trm79/Motorcycle-Engine-Design/README.md

# Motorcyle Engine Design

Used MATLAB to anaylyze efficiencies, loads, combustion, etc. After analysis, used SolidWorks to design fully functioning IC motorcycle engine.
