trm79/Motorcycle-Engine-Design/Lubrication/Lubricaiton Appendices References for Final Report.docx

References:

Chapter 13 (Heywood) (11 of Pulkrabeck)

Chapter 12 of Shigley

Lifter/pushrod lubrication:

https://www.thecarguys.net/valve_system_operation.pdf

Standards:

https://www.oilspecifications.org/jaso.php

https://www.cycleworld.com/2014/07/04/ask-kevin-should-i-use-motorcycle-synthetic-oil-or-petroleum

http://www.oil-tech.com/amsoil-pdf-files/motorcycle-oil-comparison.pdf

https://www.yourmechanic.com/article/how-the-engine-lubrication-system-works

http://edge.rit.edu/edge/P14453/public/Research/2-_LEADER_-_Understanding_Journal_Bearings.pdf

http://www.lube-media.com/wp-content/uploads/2017/11/Lube-Tech011-DesigningautomotiveenginelubricatingsystemsNewsurfacecoatingprocessdevelopedtor.pdf

Bearing Design:

Chapter 13 of juvinall
