trm79/Motorcycle-Engine-Design/Lubrication/Process - Lubrication.docx

Process 1:

1. Determine required flow rate for system
  a. Pick bearings based on L/D ratio and crankshaft dimensions
    i. Calculate total leakage rate
  b. Calculate flow rate needed through intake/exhaust manifolds
    i. Splash lubrication from bearings on camshaft, same calculations as for crankshaft and connecting rod bearings
2. Pick pump
  a. This finalizes system flow rate
  b. And pressure
    i. Need to find major, minor losses
    ii. Use flow rate to find velocity
3. Calculate diameter of oil channels through block and crankshaft (also intake/exhaust manifolds)
  a. Using flow rate
  b. Crankshaft channels
    i. Outer channels can be slightly longer with slightly lower pressures because they will have lower flow rates because they only support half the load of the central bearing
4. Implement channels into part design files

Process 2:

1. Design oil pan based on engine block design and required volume of oil (~4 litres)
  a. Must allow for safety factor for tilt, ac/deceleration (eliminate crankshaft dipping)
  b. Include drain plug
  c. Include considerations to ensure intake tube is always submerged
2. Design rest of components
  a. Dipstick
  b. Dipstick tube
  c. Oil manifold
  d. Oil pump mount
3. Spec rest of system components
  a. Intake tube
    i. Tube adapter (male)
  b. Drilling relief valve (after pump, before drilling entrance
  c. Bypass relief valve (before full flow filter)
  d. Piston relief valve (before piston cooling jet)
  e. Full flow filter
  f. Bypass filter
  g. Oil manifold mounting bolts

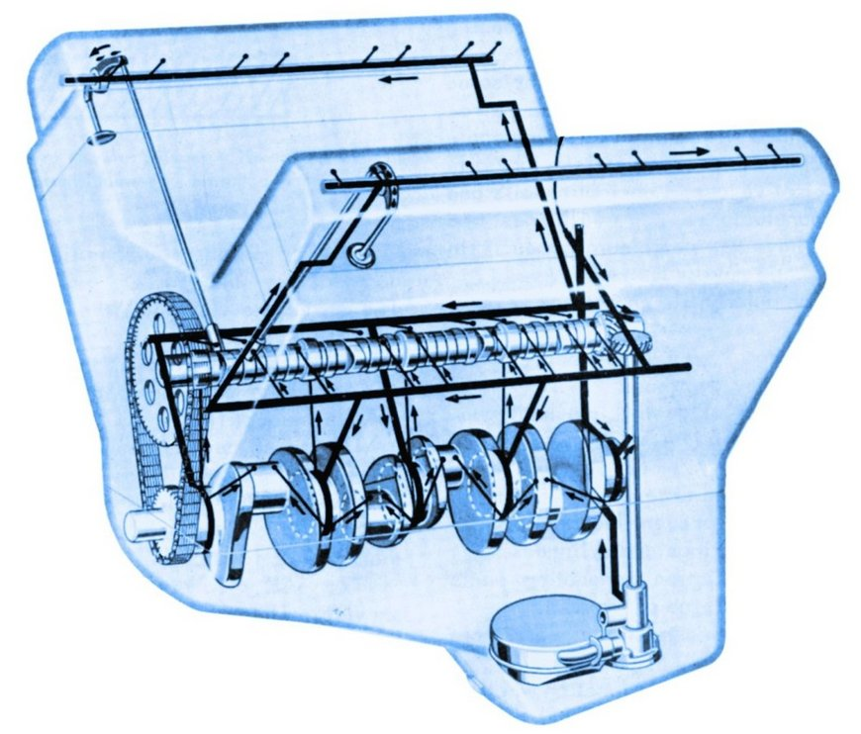
[picture p4: figure]

Lifter/pushrod lubrication:

https://www.thecarguys.net/valve_system_operation.pdf

Bearing material:

AST800 Bimetal Wrapped Steel With Bronze,

Good for lubricated applications, high load capacity, excellent heat dissipation, and good fatigue properties. They have been widely used in automotive industry
