trm79/Motorcycle-Engine-Design/Lubrication/crankshaft oil channels1.PNG

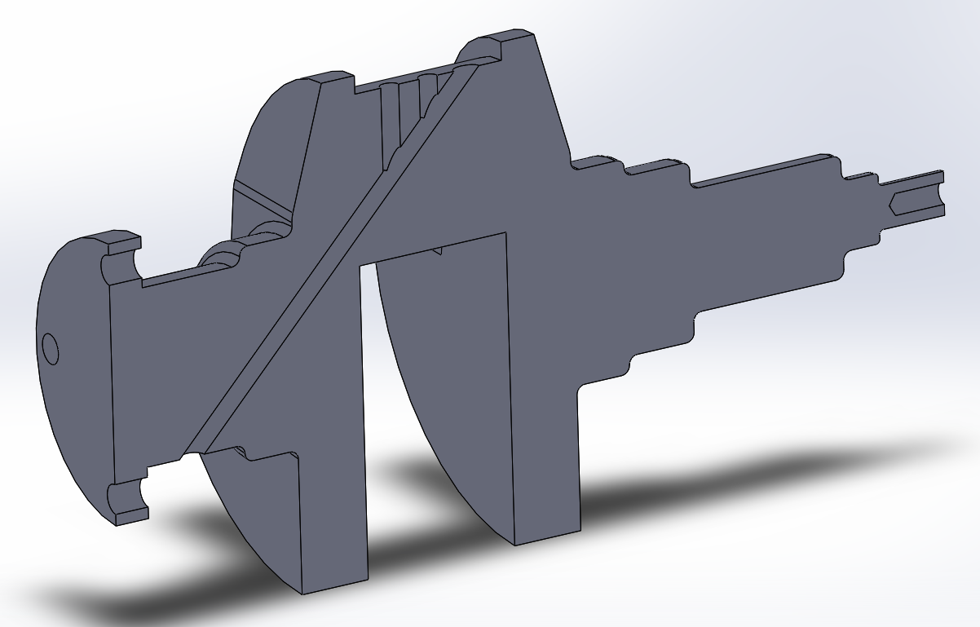
Lubrication/crankshaft oil channels1.PNG
