trm79/Motorcycle-Engine-Design/Lubrication/crankshaft oil channels2.PNG

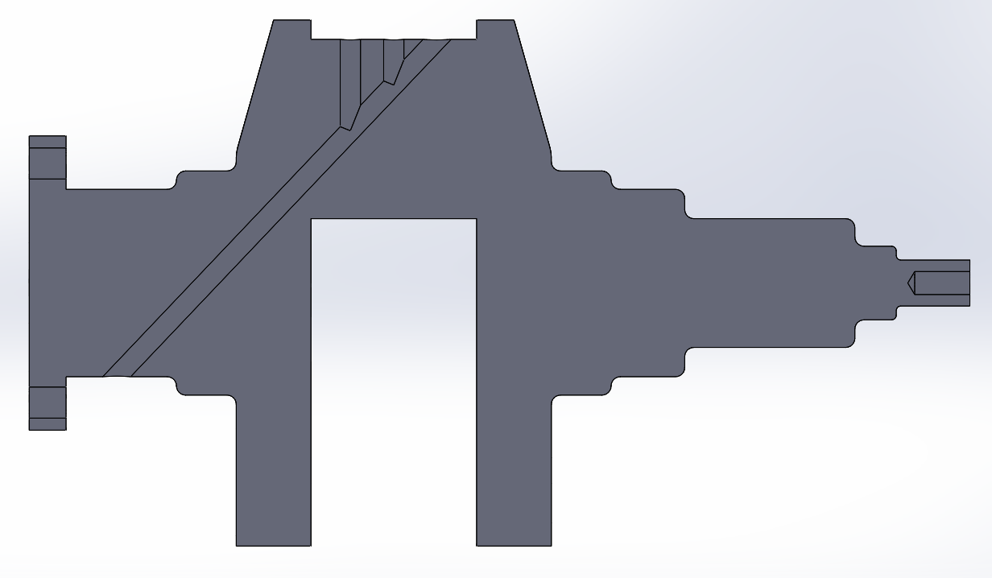
Lubrication/crankshaft oil channels2.PNG
