trm79/Motorcycle-Engine-Design/Lubrication/final flow chart.PNG

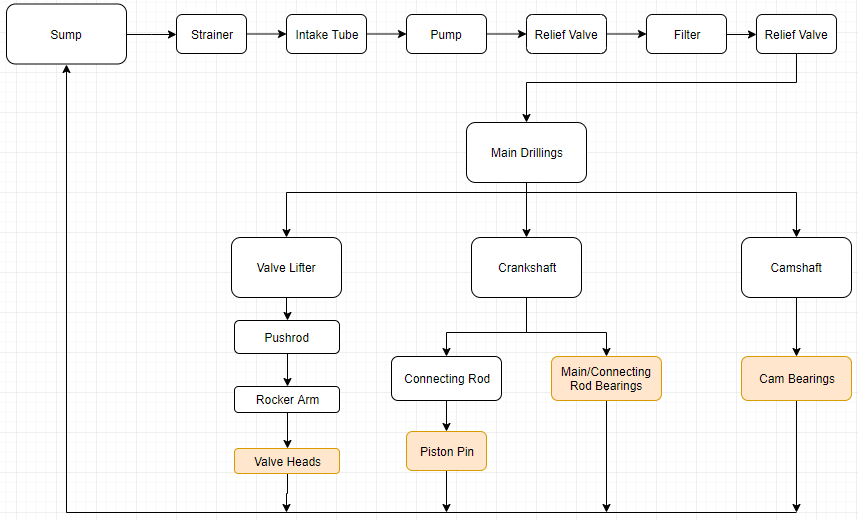
Lubrication/final flow chart.PNG
