trm79/Motorcycle-Engine-Design/Lubrication/Oil Flow Chart.PNG

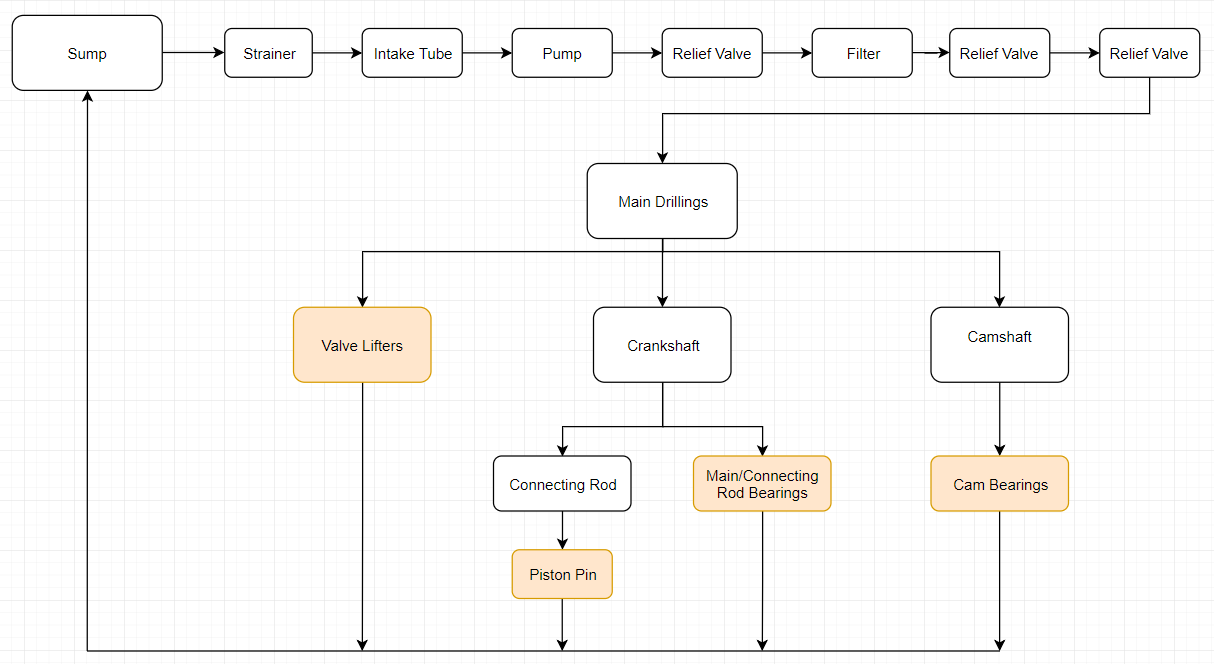
Lubrication/Oil Flow Chart.PNG
