trm79/Motorcycle-Engine-Design/Other Work/cooling flowchart.png

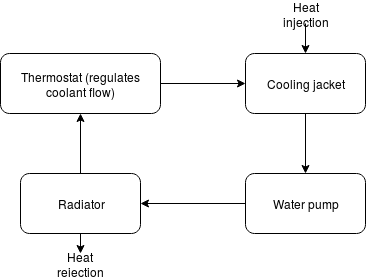
Other Work/cooling flowchart.png
