trm79/Motorcycle-Engine-Design/Other Work/Powertrain ISO.gif

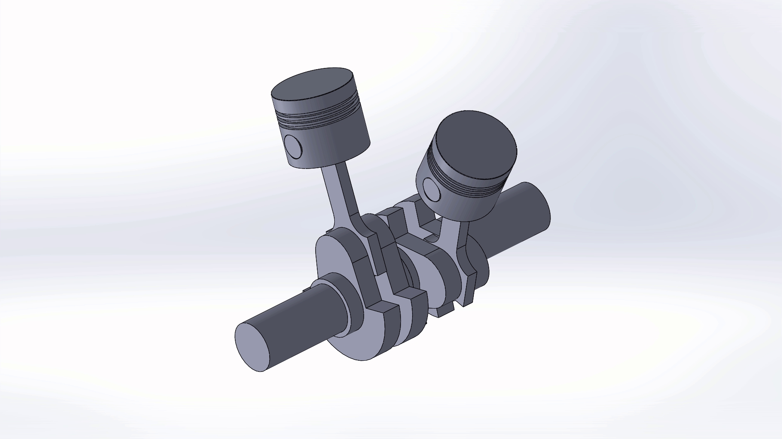
Other Work/Powertrain ISO.gif
