trm79/Motorcycle-Engine-Design/Lubrication/Purchased Parts Specifications.docx

Pump:

Specifications:

Required flow rate: 4.36L/min

Required Pressure: 520kPa

Manufacturer: RB Racing

Cost: $495

Quantity: 1

https://www.rbracing-rsr.com/oilsystems.htm

Filters:

Specifications:

Full flow filtration:

Manufacturer:

Cost:

Quantity: 1

Specifications:

Fine filtration:

Manufacturer:

Cost:

Quantity: 1

Relief Valves:

Specifications:

Main channel relief valve

Manufacturer:

Cost:

Quantity: 1

Specifications:

Filter relief valve:

Manufacturer:

Cost:

Quantity: 1

Strainer:

Specifications:

Manufacturer:

Cost:

Quantity: 1

Tubing:

Specifications:

Manufacturer:

Cost:

Quantity:

Temperature Sensor:

Specifications:

Manufacturer:

Cost:

Quantity: 1

Pump Mounting Bolts:

Specifications:

Manufacturer: RB Racing

Cost: $7.95 (set of 4)

Quantity: 4

Main Crankshaft Bearing:

Specifications:

Manufacturer:

Cost:

Quantity:

Crankpin Bearing:

Specifications:

Manufacturer:

Cost:

Quantity:

Camshaft Bearing:

Specifications:

Manufacturer:

Cost:

Quantity:
