trm79/Motorcycle-Engine-Design/Final Report/Bill of Materials .xlsx

Sheet: Injection
 | Part Name | Part Number | Local Part Number | Description | Material | Manufacturing Method | Retailer (if bought) |  | Quantity | Unit Cost ($) | Unit Weight (lb) | Total Cost | Total Weight (lb) | Comments
Manufactured Components
Purchased Components | Fuel injector* | F 02U V00 868-01 | DH-I-I001 | HDEV5.2 High pressure injector. Flow rate at 100 bar: up to 1,640 g/min (n-heptane) for port injection |  | Purchased | Bosch | http://www.bosch-motorsport.com/media/catalog_resources/HP_Injection_Valve_HDEV_52_Datasheet_51_en_2776067211pdf.pdf | 2 | 65 | 0.149914 | 130 | 0.299828 | Unit weight is without wire
 | Spark plug | 9613 | DH-I-I002 | Bosch Double Iridium Spark Plug |  | Purchased | Bosch | https://www.amazon.com/Bosch-9613-Double-Iridium-Longer/dp/B00515NJB6 | 2 | 7.23 | 0.11 | 14.46 | 0.22 | Bhavya found this
 | Throttle Position Sensor | C701260454BOS | DH-I-I004 | Throttle Position Sensor |  | Purchased | Bosch | https://shop.advanceautoparts.com/p/bosch-bosch-throttle-position-sensor-c701260454bos/10809310-P | 1 | 67 | 0.8 | 67 | 0.8 |  | Throttle valve position, crankshaft position, engine & coolant temp
 | Starter Motor |  | DH-I-I005 | All Balls Starter Motor |  | Purchased | All Balls | https://www.amazon.com/All-Balls-Starter-Motor-Harley/dp/B000GZR4CG | 1 | 287.5 | 8.8 | 287.5 | 8.8
Fasteners, Bearings, etc. | Fuel injector o-rings (2 each) | 1222595 |  | 13/16" Inside x 1" Outside Diam | Nitrile | Purchased | Buna-N | https://www.mscdirect.com/browse/tnpla/01222595?pcrid=164124449498&rd=k&product_id=01222595 | 16 | 3.4 | 0.05 | 54.4 | 0.8

Sheet: Lubrication and Cooling
/ | Part Name | Part Number | Local Part Number | Description | Material | Manufacturing Method | Retailer (if bought) | Quantity | Unit Cost | Unit Weight | Total Cost | Total Weight
Manufactured Components | Oil Pan |  |  | Part of the crankcase, not actually a separate part |  |  | NA | NA | NA | NA | NA | NA
 | Dipstick Tube |  |  | Also part of the crankcase, not a truly original part |  |  | NA | NA | NA | NA | NA | NA
Purchased Components | Oil Pump | 03-1054 | DH-LC-P001 | Oil Prelube / Scavenge Pump SuperX, 1/2" NPT x 1/2" BSPP Male exit/entry, 3.200" x 7.500", 4.0 GPM (15A Fuse) |  | NA | RB Racing | 1 | 395 | 9.46 | 395 | 9.46
 | Pressure Relief Valve (Main Channel) | A60871094826OES | DH-LC-P002 | Regulates pressure at main drilling inlet |  | NA | Advance Auto Parts | 1 | 8.37 | 0.25 | 8.37 | 0.25
 | Pressure Relief Valve (Filters) | A60871094826OES | DH-LC-P003 | Regulates pressure at filter inlet |  | NA | Advance Auto Parts | 1 | 8.37 | 0.25 | 8.37 | 0.25
 | Oil Temperature Sensor | 17 11 1 437 362 | DH-LC-P008 | AT Cooler Thermostat |  | NA | URO Parts | 1 | 35.63 | 0.2 | 35.63 | 0.2
 | Coolant Pump |  | DH-LC-P009 |  |  | NA |  | 1 |  |  | 0 | 0
 | Oil Strainer | 12-1542 | DH-LC-P010 | Includes: strainer, gasket, and pin |  | NA | V-Twin Manufacturing | 1 | 15.95 | 0.05 | 15.95 | 0.05
 | Check Valve (pump outlet) | 03-1036 | DH-LC-P011 | 03-1036 Check valve, 1/2" NPT 1psi backflow |  | NA | RB Racing | 1 | 40.5 | 0.1 | 40.5 | 0.1
 | Hose Barb Fitting | 03-1043 | DH-LC-P012 | 03-1043 1/2" Hose Barb Fitting |  | NA | RB Racing | 2 | 15 | 0.01 | 30 | 0.02
 | Drain plug sealing O-ring | -13 | DH-LC-P014 | Seals oil into crankcase |  | NA | Apple Rubber | 1 | 0.2 | 0.01 | 0.2 | 0.01
 | Drain Plug | BMS008Y | DH-LC-P015 | Screws into lowest point on oil pan to be removed for oil change |  | NA | Motosport | 1 | 6.95 | 0.08 | 6.95 | 0.08
 | Dipstick | 40-0470 | DH-LC-P016 | Measures level of oil, screws into dipstick tube |  | NA | V-Twin Manufacturing | 1 | 2.12 | 0.2 | 2.12 | 0.2
 | Thermostat | 7200-195 | DH-LC-P017 | Regulates coolant flow based on temperature |  | NA | Fail-Safe | 2 | 14.99 | 0.13 | 29.98 | 0.26
Fasteners, Bearings, etc. | Oil Manifold Mounting Bolts | 03-1045 | DH-LC-P017 | 03-1045 Mounting Bolts (pack of 4) |  | NA | RB Racing | 1 | 7.95 | 0.16 | 7.95 | 0.16
 | Main Crankshaft Bearing (top) | NA | DH-LC-P018 | Simple Hydrodynamic Bearing | AST800 Wrapped Steel w/ Bronze | NA | Mechanical Power | 2 | 19.275 | 0.24 | 38.55 | 0.48
 | Main Crankshaft Bearing (bottom) | NA | DH-LC-P019 | Simple Hydrodynamic Bearing | AST800 Wrapped Steel w/ Bronze | NA | Mechanical Power | 2 | 19.275 | 0.23 | 38.55 | 0.46
 | Connecting Rod Bearing (bottom) | NA | DH-LC-P020 | Simple Hydrodynamic Bearing | AST800 Wrapped Steel w/ Bronze | NA | Mechanical Power | 3 | 14.475 | 0.14 | 43.425 | 0.42
 | Connecting Rod Bearing (top) | NA | DH-LC-P021 | Simple Hydrodynamic Bearing | AST800 Wrapped Steel w/ Bronze | NA | Mechanical Power | 3 | 14.475 | 0.13 | 43.425 | 0.39
 | Camshaft Bearing (top) | NA | DH-LC-P022 | Simple Hydrodynamic Bearing | AST800 Wrapped Steel w/ Bronze | NA | Mechanical Power | 4 | 17.625 | 0.03 | 70.5 | 0.12
 | Camshaft Bearing (bottom) | NA | DH-LC-P023 | Simple Hydrodynamic Bearing | AST800 Wrapped Steel w/ Bronze | NA | Mechanical Power | 4 | 17.625 | 0.03 | 70.5 | 0.12
 | Auxiliary Crankshaft Bearing (top) | NA | DH-LC-P024 | Simple Hydrodynamic Bearing | AST800 Wrapped Steel w/ Bronze | NA | Mechanical Power | 1 | 11.125 | 0.02 | 11.125 | 0.02
 | Auxiliary Crankshaft Bearing (bottom) | NA | DH-LC-P025 | Simple Hydrodynamic Bearing | AST800 Wrapped Steel w/ Bronze | NA | Mechanical Power | 1 | 11.125 | 0.02 | 11.125 | 0.02
 | Piston Pin Bearing | NB-1457 | DH-LC-P026 | Needle Bearing, #: NB-1457 |  | NA | Parts Unlimited | 2 | 7.95 | 0.02 | 15.9 | 0.04
 | Piston Pin Bearing (ring) | NA | DH-LC-P027 | Needle bearing ring |  | NA | Parts Unlimited | 2 | 0 | 0 | 0 | 0
 | Piston Pin Bearing (needle) | NA | DH-LC-P028 | Needle bearing needle |  | NA | Parts Unlimited | 36 | 0 | 0 | 0 | 0
 | 90 degree pump adapter | 03-1049 | DH-LC-P029 | 90 fitting for inlet/outlet of pump |  | NA | RB Racing | 2 | 27.5 | 0.1 | 55 | 0.2
 | Dipstick O-ring | AS568-56 | DH-LC-P030 | O-ring to seal dipstick |  | NA | Apple Rubber | 1 | 0.2 | 0.01 | 0.2 | 0.01
 |  |  |  |  |  |  |  |  |  |  | 979.32 | 13.32

Sheet: Powertrain
 | Part Name | Part Number | Local Part Number | Description | Material | Manufacturing Method | Retailer (if bought) | Quantity | Unit Cost | Unit Weight | Total Cost | Total Weight
Manufactured Components | Piston |  | DH-PT-M001 | Piston | Aluminum 4032 | Forged | -- | 2
 | Wrist Pin |  | DH-PT-M002 | Secures connecting rod to piston | 4340 Steel | Forged | -- | 2 |  | 1.4 |  | 2.8
 | Blade Connecting Rod |  | DH-PT-M003 | Connects piston to crankshaft | AISI 1340 | Forged, Cold Finished | -- | 1 |  | 2.62 |  | 2.62
 | Connecting Rod Cap, Fork |  | DH-PT-M004 | Bottom portion of connecting rod | AISI 1340 | Forged, Cold Finished | -- | 2 |  |  |  | 0
 | Fork Connecting Rod |  | DH-PT-M009 | Connects piston to connecting rod | AISI 1340 | Forged, Cold Finished | -- | 1 |  | 4.55 |  | 4.55
 | Crankshaft |  | DH-PT-M008 | Provides output to transmission | 4340 Steel | Forged and Machined | -- | 1 |  | 29.75 |  | 29.75
 | Wrist Pin Circlip |  | DH -PT-M010 | Secures wrist clip onto piston | 4340 Steel | Extruded and bent? | -- | 4 |  | 0.002 |  | 0.008
 | Piston Compression Ring |  | DH-PT-M011 | Spreads lubrication along cylinder | Nitride Steel | Buy |  | 2
 | Connecting Rod Cap, Blade |  | DH-PT-M012 | Bottom portion of connecting rod | AISI 1340 | Forged, Cold Finished | -- | 1
Purchased Components | Piston Rings |  | DH-PT-P002 |  |  |  |  | 6
 | Wrist Pin Retainers | LR64 | DH-PT-P002 | Speed-Pro Piston Pin Lock Ring | Steel |  | Speed Pro | 4 | 1.99 | 0.007 | 7.96 | 0.028
Fasteners |  |  |  | Connecting Rod Cap Screws
 |  |  |  | Crankshaft Sprocket Retaining Bolt

Sheet: Valvetrain
 | Part Name | Part Number | Local Part Number | Description | Material | Manufacturing Method | Retailer (if bought) | Quantity | Unit Cost | Unit Weight (lb) | Total Cost | Total Weight (lb)
Manufactured Components | Camshaft Square End | -- | DH-VT-M001 | Camshaft for sprocket mounting | Gray Cast Iron Class 40 A48 |  | -- | 1
 | Camshaft Regular End | -- | DH-VT-M002 | Camshaft with retaining ring groove | Gray Cast Iron Class 40 A48 |  | -- | 1
 | Push Rod | -- | DH-VT-M007 | Connects cams to rocker arms | Steel Alloy 4140 | Machining | -- | 4 |  |  |  | 0
 | Rocker Holder Bottom | -- | DH-VT-M008 | Secures rocker arm shafts |  |  | -- | 4 |  |  |  | 0
 | Rocker Holder Top | -- | DH-VT-M009 | Secures rocker arm shafts |  |  | -- | 4
 | Exhaust Rocker Arm | -- | DH-VT-M0010 | Connects push rods to valve stems | Steel Alloy 4140 | Forging | -- | 2 |  |  |  | 0
 | Intake Rocker Arm | -- | DH-VT-M0011 | Connects push rods to valve stems | Steel Alloy 4140 | Forging | -- | 2 |  |  |  | 0
 | Rocker Arm Shaft | -- | DH-VT-M012 | Provides rotation surface for rocker arms | Steel Alloy 4140 |  | -- | 4
 | Intake Stem | -- | DH-VT-M013 | Stem of intake valve | Stainless Steel 201 |  |  | 4
 | Intake Valve | -- | DH-VT-M014 | Flange of intake valve | Stainless Steel 201 | Forging | -- | 4 |  |  |  | 0
 | Exhaust Stem | -- | DH-VT-M015 | Stem of exhaust valve | Stainless Steel 21-4N |  | -- | 4
 | Exhaust Valve | -- | DH-VT-M016 | Flange of exhaust valve | Stainless Steel 21-4N | Forging | -- | 4
Purchased Components | Crankshaft Timing Sprocket |  | DH-VT-P002 |  |  | -- |  | 1
 | Camshaft Timing Sprocket |  | DH-VT-P003 |  |  | -- |  | 1
 | Valve Lock | 13098-16 | DH-VT-M017/019 | Manley 7 Degree Machined Valve Locks | Alloy Steel | -- | Manley | 8 | 3 | 0.2 | 24 | 1.6
 | Valve Retainer | 660-23604-32 | DH-VT-M018 | Manley Street Master Steel Retainers 0.841" Spring O.D. | 4140 Chromoly steel | -- | Manley | 8 | 4 | 0.0154 | 32 | 0.1232
 | Valve Spring | LC 095J 04 S316 | DH-VT-P001 | Lee Spring Compression Spring | SS316 | -- | Lee Spring | 8 | 9.45 |  | 75.6
 | Oil seal |  |  |  |  | -- |  | 8
 | Camshaft Timing Chain |  |  |  |  | --
 | Hydraulic Lifter |  |  |  |  | --
Fasteners, Bearings, etc. | Camshaft Sprocket Retaining Bolt |  | -- | 1/2-13 0.75" flanged hex bolt |  |  |  | 1
 | Camshaft Retaining Ring |  | --
 | Crankshaft Sprocket Retaining Bolt |  |  | 3/8-16 0.75" flanged hex bolt |  | -- |  | 1

Sheet: IntakeExhaust
 | Part Name | Part Number | Local Part Number | Description | Material | Manufacturing Method | Retailer (if bought) | Link (if bought) | Quantity | Unit Cost | Unit Weight | Total Cost | Total Weight
Manufactured Components | Intake Manifold |  | DH-IE-M001 |  | Stainless Steel AISI 405 | Die Casting |  |  | 1
 | Exhaust Manifold 1 |  | DH-IE-M002 |  | Stainless Steel AISI 405 | Die Casting |  |  | 1
 | Exhaust Manifold 2 |  | DH-IE-M003 |  | Stainless Steel AISI 405 | Die Casting |  |  | 1
Purchased Components | Exhaust Gasket |  | DH-IE-P001 | AS-568-029 |  |  |  |  | 4
 | Intake Gasket |  | DH-IE-P002 | AS-568-029 |  |  |  |  | 4
 | Air Intake Filter
 | Catalytic Converter
 | Muffler
 | O2 Sensor | 15109 | DH-I-I003 | Bosch Exact Fit Oxygen Sensor |  | Purchased | Bosch | https://www.autozone.com/engine-management/oxygen-sensor/bosch-exact-fit-oxygen-sensor/491745_102074_0_98000 | 2 | 60 | 0.28 | 120 | 0.56 | Maybe look into more sensors?
Fasteners, Bearings, etc.

Sheet: Engine BlockHousing
 | Part Name | Part Number | Local Part Number | Description | Material | Manufacturing Method | Retailer | Quantity | Unit Cost | Unit Weight (lb) | Total Cost | Total Weight
Manufactured Components | Crankcase Front | -- | DH-EB-M002 | Houses crankshaft assembly | Aluminum Alloy 356-T6 | Sand Casting | -- | 1 |  | 15.96 |  | 15.96
 | Crankcase Rear | -- | DH-EB-M003 | Houses crankshaft assembly | Aluminum Alloy 356-T6 | Sand Casting | -- | 1 |  | 11.9 |  | 11.9
 | Cylinder | -- | DH-EB-M004 | Houses cylinder lining, cooling and lubrication channels | Aluminum Alloy 356-T6 | Sand Casting | -- | 2 |  | 11.4 |  | 22.8
 | Cylinder Lining | -- | DH-EB-M005 | Lining for smooth piston travel | Gray Cast Iron Class 40 A48 |  | -- | 2 |  |  |  | 0
 | Cylinder Stud | -- | DH-EB-M006 | Threaded rods for cylinder alignment and structure | Steel Alloy 4140 | Forging | -- | 8 |  | 0.4 |  | 3.2
 | Camshaft Retaining Plate | -- | DH-EB-M007 | Holds camshafts, camshaft bearings |  |  | -- | 1 |  |  |  | 0
 | Head Bolt | -- | DH-EB-M008 | Threads into cylinder studs to fixture cylinder, cylinder head |  |  | -- | 8 |  |  |  | 0
 | Cylinder Head | -- | DH-EB-M009 | Contains valves, spark plugs, and hooks to intake/exhaust | Aluminum Alloy 356-T6 | Sand Casting | -- | 2 |  |  |  | 0
 | Valve Stem Liner | -- | DH-EB-M010 | Ensures smooth translation of valves |  |  | -- | 8
 | Tappet Cover Left | -- | DH-EB-M011 | Covers hydraulic push rod lifter, houses pushrod gaskets |  |  | -- | 1
 | Rocker Box | -- | DH-EB-M012 | Houses rocker arms | Aluminum Alloy 356-T6 | Sand Casting | -- | 2
 | Tappet Cover Right | -- | DH-EB-M013 | Covers hydraulic push rod lifter, houses pushrod gaskets |  |  | --
 | Cylinder Cover | -- | DH-EB-M014 | Covers the rocker box |  |  | -- | 2
 | Front Crankcase Cover | -- | DH-EB-M015 | Covers the crankshaft and camshaft sprockets and chain |  |  | -- | 1
 | Push Rod Tube Bottom | -- | DH-EB-M016 | Protects the pushrod, slots into the tappet covers |  |  | -- | 4
 | Push Rod Tube Top | -- | DH-EB-M017 | Protects the pushrod, slots into the cylinder head |  |  | -- | 4
 | Push Rod Tube Spring Cover | -- | DH-EB-M018 | Protects the pushrod retaining spring |  |  | -- | 4
 | Head Gasket | -- | DH-EB-M019 | Seals gap between cylinder head and cylinder |  |  | -- | 2
 | Push Rod Covers | -- | DH-EB-M020 | Ensures tension in push rod spring for fixturing |  |  | -- | 8
 | Rocker Gasket | -- | DH-EB-M021 | Seals gap between rocker box and cylinder head |  |  | -- | 2
 | Cylinder Head Retaining Plug | -- | DH-EB-M023 | Prevents cylinder head slippage when unfastened |  |  | -- | 4
Purchased Components | Cylinder Gasket O-Ring | AS568-424 | DH-EB-P001 |  | Nitrile | -- | Marco Rubber and Plastics | 2 | $0.70 |  | $1.40
 | Push Rod Spring |  | DH-EB-P002 | Spring pressure fixtures push rods |  | -- |  | 4
 | Push Rod Spring Shims |  | DH-EB-P003 | Provides bottom spring support before spring gasket |  | -- |  | 4
 | Push Rod Spring Gasket O-Ring |  | DH-EB-P004 | Seals gap between top and bottom push rod covers | Nitrile | -- | Marco Rubber and Plastics | 4
 | Dual Piston Cam Chain Tensioner | 413-901 | DH-EB-P005,6 | Ensures tension in the crankshaft and camshaft chains | -- | -- | Red Shift | 1 | $159.95
 | Push Rod Gasket O-Ring | AS568-018 | DH-EB-P007 | Seals gap between bottom push rod cover and tappet cover | Nitrile | -- | Marco Rubber and Plastics | 8
Fasteners | 1/4-20 1" hex socket head cap screw |  | -- |  |  |  |  | 6
 | 1/4-20 0.75" hex bolt |  | -- |  |  |  |  | 8
 | 1/4-20 1.875" hex bolt |  | -- |  |  |  |  | 4
 | 1/4-20 1.75" hex bolt |  | -- |  |  |  |  | 4
 | 3/8-16 0.75" hex bolt |  | -- |  |  |  |  | 8
 | 3/8-16 0.625" hex bolt |  | -- |  |  |  |  | 8
 | 1/4-20 1.375" hex bolt |  | -- |  |  |  |  | 10
 | 3/8-16 5.5" hex bolt |  | -- |  |  |  |  | 5
 | 10-32 0.625" socket button head cap screw |  | -- |  |  |  |  | 6

Sheet: Materials
Material | Density (lb/in^3) | Yield Strength (ksi) | Elastic Modulus (ksi) | Ultimate Tensile Strength (ksi)
Stainless Steel AISI 201 | 0.28 | 80 | 28600 | 150
Stainless Steel 21-4N | 0.28 | 100 | 31000 | 180
Stainless Steel AISI 405 | 0.28 | 40 | 29000 | 65
Steel Alloy 4140 | 0.28 | 60 | 30000 | 95
Steel Alloy 4340 | 0.28 | 68.2 | 31000 | 108
Steel Alloy AISI 1340 | 0.28 | 62.9 | 30000 | 102
Aluminum Alloy 356-T6 | 0.0965 | 24 | 10500 | 34
Cast Iron ASTM Class 40 | 0.258 | 28 | 18000 | 40

Sheet: FINAL
Part Name | Part Number | Local Part Number | Description | Material | Manufacturing Method | Retailer | Quantity | Unit Cost | Unit Weight (lb) | Total Cost | Total Weight
Engine Block
Crankcase Front | -- | DH-EB-M002 | Houses crankshaft assembly | Aluminum Alloy 356-T6 | Sand Casting | -- | 1 | $60.00 | 15.61 | $60.00 | 15.610
Crankcase Rear | -- | DH-EB-M003 | Houses crankshaft assembly | Aluminum Alloy 356-T6 | Sand Casting | -- | 1 | $55.00 | 12.27 | $55.00 | 12.270
Cylinder | -- | DH-EB-M004 | Houses cylinder lining, cooling and lubrication channels | Aluminum Alloy 356-T6 | Sand Casting | -- | 2 | $53.00 | 11.3625 | $106.00 | 22.725
Cylinder Lining | -- | DH-EB-M005 | Lining for smooth piston travel | Gray Cast Iron Class 40 A48 | Sand Casting | -- | 2 | $9.00 | 4.6149 | $18.00 | 9.230
Cylinder Stud | -- | DH-EB-M006 | Threaded rods for cylinder alignment and structure | 316 Stainless Steel | Forging | -- | 8 | $5.00 | 0.3839 | $40.00 | 3.071
Camshaft Retaining Plate | -- | DH-EB-M007 | Holds camshafts, camshaft bearings | Aluminum Alloy 356-T6 | Sand Casting | -- | 1 | $10.00 | 0.9979 | $10.00 | 0.998
Head Bolt | -- | DH-EB-M008 | Threads into cylinder studs to fixture cylinder, cylinder head | 316 Stainless Steel | Forging | -- | 8 | $6.00 | 0.5649 | $48.00 | 4.519
Cylinder Head | -- | DH-EB-M009 | Contains valves, spark plugs, and hooks to intake/exhaust | Aluminum Alloy 356-T6 | Sand Casting | -- | 2 | $160.00 | 15.6253 | $320.00 | 31.251
Valve Stem Liner | -- | DH-EB-M010 | Ensures smooth translation of valves | Gray Cast Iron Class 40 A48 | Sand Casting | -- | 8 | $2.00 | 0.0383 | $16.00 | 0.306
Tappet Cover Left | -- | DH-EB-M011 | Covers hydraulic push rod lifter, houses pushrod gaskets | Aluminum Alloy 356-T6 | Sand Casting | -- | 1 | $3.00 | 0.1335 | $3.00 | 0.134
Rocker Box | -- | DH-EB-M012 | Houses rocker arms | Aluminum Alloy 356-T6 | Sand Casting | -- | 2 | $5.00 | 1.877 | $10.00 | 3.754
Tappet Cover Right | -- | DH-EB-M013 | Covers hydraulic push rod lifter, houses pushrod gaskets | Aluminum Alloy 356-T6 | Sand Casting | -- | 1 | $3.00 | 0.1335 | $3.00 | 0.134
Cylinder Cover | -- | DH-EB-M014 | Covers the rocker box | Aluminum Alloy 356-T6 | Sand Casting | -- | 2 | $10.00 | 3.6996 | $20.00 | 7.399
Front Crankcase Cover | -- | DH-EB-M015 | Covers the crankshaft and camshaft sprockets and chain | Aluminum Alloy 356-T6 | Sand Casting | -- | 1 | $11.00 | 9.2172 | $11.00 | 9.217
Push Rod Tube Bottom | -- | DH-EB-M016 | Protects the pushrod, slots into the tappet covers | Aluminum Alloy 356-T6 | Sand Casting | -- | 4 | $3.00 | 0.0807 | $12.00 | 0.323
Push Rod Tube Top | -- | DH-EB-M017 | Protects the pushrod, slots into the cylinder head | Aluminum Alloy 356-T6 | Sand Casting | -- | 4 | $2.00 | 0.0302 | $8.00 | 0.121
Push Rod Tube Spring Cover | -- | DH-EB-M018 | Protects the pushrod retaining spring | Aluminum Alloy 356-T6 | Sand Casting | -- | 4 | $2.00 | 0.0105 | $8.00 | 0.042
Head Gasket | -- | DH-EB-M019 | Seals gap between cylinder head and cylinder | Multi-Layer Steel | Machined | -- | 2 | $5.00 | 0.1632 | $10.00 | 0.326
Push Rod Covers | -- | DH-EB-M020 | Ensures tension in push rod spring for fixturing | Aluminum Alloy 356-T6 | Sand Casting | -- | 8 | $2.00 | 0.0167 | $16.00 | 0.134
Rocker Gasket | -- | DH-EB-M021 | Seals gap between rocker box and cylinder head | Multi-Layer Steel | Machined | -- | 2 | $5.00 | 0.4621 | $10.00 | 0.924
Cylinder Head Retaining Plug | -- | DH-EB-M023 | Prevents cylinder head slippage when unfastened | 316 Stainless Steel | Forging | -- | 4 | $3.00 | 0.0249 | $12.00 | 0.100
Cylinder Gasket O-Ring | AS568-424 | DH-EB-P001 | Seals gap between crank case and cylinder | Nitrile | -- | Marco Rubber and Plastics | 2 | $0.70 | 0.0048 | $1.40 | 0.010
Push Rod Spring | LP 049P 01 S316 | DH-EB-P002 | Spring pressure fixtures push rods | 316 stainless steel | -- | Lee Spring | 4 | $1.08 | 0.005 | $4.31 | 0.020
Push Rod Spring Shims | WSH.625.859.005SS | DH-EB-P003 | Provides bottom spring support before spring gasket | Stainless steel | -- | Apex Fasteners | 4 | $0.10 | 0.0004 | $0.40 | 0.002
Push Rod Spring Gasket O-Ring | AS568-011 | DH-EB-P004 | Seals gap between top and bottom push rod covers | Nitrile | -- | Marco Rubber and Plastics | 4 | $0.70 | 0.0003 | $2.80 | 0.001
Dual Piston Cam Chain Tensioner | 413-901 | DH-EB-P005,6 | Ensures tension in the crankshaft and camshaft chains | -- | -- | Red Shift | 1 | $159.95 | 0.1 | $159.95 | 0.100
Push Rod Gasket O-Ring | AS568-018 | DH-EB-P007 | Seals gap between bottom push rod cover and tappet cover | Nitrile | -- | Marco Rubber and Plastics | 8 | $0.16 | 0.000328 | $1.28 | 0.003
Retaining Plate Screws | 91251A542 | -- | 1/4-20 1" hex socket head cap screw | Black-Oxide Alloy Steel | -- | McMaster Carr | 6 | $0.16 | 0.0192 | $0.98 | 0.115
Rocker Arm Bolts | 91257A548 | -- | 1/4-20 1.75" hex bolt | Zinc Yellow-Chromate Plated Grade 8 Steel | -- | McMaster Carr | 8 | $0.22 | 0.0503 | $1.78 | 0.402
Front Cover Bolts | 92620A550 | -- | 1/4-20 2" hex bolt | Zinc Yellow-Chromate Plated Grade 8 Steel | -- | McMaster Carr | 8 | $0.22 | 0.0503 | $1.76 | 0.402
Rocker Box Bolts | 92620A622 | -- | 3/8-16 0.75" hex bolt | Zinc Yellow-Chromate Plated Grade 8 Steel | -- | McMaster Carr | 8 | $0.23 | 0.0441 | $1.81 | 0.353
Manifold Bolts | 92620A621 | -- | 3/8-16 0.625" hex bolt | Zinc Yellow-Chromate Plated Grade 8 Steel | -- | McMaster Carr | 8 | $0.22 | 0.0402 | $1.79 | 0.321
Cylinder Cover Bolts | 91257A535 | -- | 1/4-20 1.375" hex bolt | Zinc Yellow-Chromate Plated Grade 8 Steel | -- | McMaster Carr | 10 | $0.49 | 0.0279 | $4.93 | 0.279
Crankcase Bolts | 91257A646 | -- | 3/8-16 5.5" hex bolt | Zinc Yellow-Chromate Plated Grade 8 Steel | -- | McMaster Carr | 5 | $2.00 | 0.1931 | $9.99 | 0.965
Tapper Cover Screws | 92949A267 | -- | 10-32 0.625" socket button head cap screw | 18-8 Stainless Steel | -- | McMaster Carr | 6 | $0.08 | 0.0068 | $0.45 | 0.041
Powertrain
Piston | -- | DH-PT-M001 | Piston | Aluminum 4032 | Forged | -- | 2 | $45 | 2.272 | $90.00 | 4.544
Wrist Pin | -- | DH-PT-M002 | Secures connecting rod to piston | 4340 Steel | Forged | -- | 2 | $7 | 0.74 | $14.00 | 1.480
Blade Connecting Rod | -- | DH-PT-M003 | Connects piston to crankshaft | AISI 1340 | Forged, Cold Finished | -- | 1 | $21 | 2.62 | $21.00 | 2.620
Connecting Rod Cap, Fork | -- | DH-PT-M006 | Bottom portion of connecting rod | AISI 1340 | Forged, Cold Finished | -- | 2 | $10 | 0.61 | $20.00 | 1.220
Fork Connecting Rod | -- | DH-PT-M009 | Connects piston to connecting rod | AISI 1340 | Forged, Cold Finished | -- | 1 | $23 | 4.55 | $23.00 | 4.550
Crankshaft | -- | DH-PT-M008 | Provides output to transmission | 4340 Steel | Forged and Machined | -- | 1 | $250 | 29.75 | $250.00 | 29.750
Wrist Pin Circlip | -- | DH -PT-M010 | Secures wrist clip onto piston | 4340 Steel | Extruded and bent | -- | 4 | $2.00 | 0.002 | $8.00 | 0.008
Piston Compression Ring | -- | DH-PT-M011 | Spreads lubrication along cylinder | Gray Cast Iron Class 40 A48 | Machined | -- | 2 | $8.00 | 0.036 | $16.00 | 0.072
Connecting Rod Cap, Blade | -- | DH-PT-M012 | Bottom portion of connecting rod | AISI 1340 | Forged, Cold Finished | -- | 1 | $8.00 | 0.52 | $8.00 | 0.520
Connecting Rod Cap Bolts | 91257A630 | -- | 3/8-16 1.75" hex bolt | Zinc Yellow-Chromate Plated Grade 8 Steel | -- | McMaster Carr | 6 | $0.31 | 0.077 | $1.89 | 0.460
Valvetrain
Camshaft Square End | -- | DH-VT-M001 | Camshaft for sprocket mounting | Gray Cast Iron Class 40 A48 | Casting | -- | 1 | $35 | 1.18 | $35.00 | 1.180
Camshaft Regular End | -- | DH-VT-M002 | Camshaft with retaining ring groove | Gray Cast Iron Class 40 A48 | Casting | -- | 1 | $35 | 1.159 | $35.00 | 1.159
Push Rod | -- | DH-VT-M007 | Connects cams to rocker arms | Steel Alloy 4140 | Machining | -- | 4 | $5 | 0.1334 | $20.00 | 0.534
Rocker Holder Bottom | -- | DH-VT-M008 | Secures rocker arm shafts | Steel Alloy 4140 | Machining | -- | 4 | $8 | 0.3635 | $32.00 | 1.454
Rocker Holder Top | -- | DH-VT-M009 | Secures rocker arm shafts | Steel Alloy 4140 | Machining | -- | 4 | $7 | 0.2486 | $28.00 | 0.994
Intake Rocker Arm | -- | DH-VT-M010 | Connects push rods to valve stems | Steel Alloy 4140 | Forging | -- | 2 | $7 | 0.6054 | $14.00 | 1.211
Exhaust Rocker Arm | -- | DH-VT-M011 | Connects push rods to valve stems | Steel Alloy 4140 | Forging | -- | 2 | $7 | 0.6054 | $14.00 | 1.211
Rocker Arm Shaft | -- | DH-VT-M012 | Provides rotation surface for rocker arms | Steel Alloy 4140 | Machining | -- | 4 | $5 | 0.3953 | $20.00 | 1.581
Intake Stem | -- | DH-VT-M013 | Stem of intake valve | Stainless Steel AISI 201 | Forging | -- | 4 | $17 | 0.0567 | $68.00 | 0.227
Intake Valve | -- | DH-VT-M014 | Flange of intake valve | Stainless Steel AISI 201 | Forging | -- | 4 | $0 | 0.1386 | $0.00 | 0.554
Exhaust Stem | -- | DH-VT-M015 | Stem of exhaust valve | Stainless Steel 21-4N | Forging | -- | 4 | $17 | 0.0529 | $68.00 | 0.212
Exhaust Valve | -- | DH-VT-M016 | Flange of exhaust valve | Stainless Steel 21-4N | Forging | -- | 4 | $0 | 0.1082 | $0.00 | 0.433
Crankshaft Timing Sprocket | D25B18H | DH-VT-P002 | Transfers motion of crankshaft to camshaft | Stainless steel | -- | Martin Sprocket | 1 | $7.99 | 0.48 | $7.99 | 0.480
Camshaft Timing Sprocket | D25B36H | DH-VT-P003 | Transfers motion of crankshaft to camshaft | Stainless steel | -- | Martin Sprocket | 1 | $9.99 | 0.76 | $9.99 | 0.760
Valve Lock | 13098-16 | DH-VT-M017/019 | Manley 7 Degree Machined Valve Locks | Alloy Steel | -- | Manley | 8 | $3.00 | 0.20 | $24.00 | 1.600
Valve Retainer | 660-23604-32 | DH-VT-M018 | Manley Street Master Steel Retainers 0.841" Spring O.D. | 4140 Chromoly steel | -- | Manley | 8 | $4.00 | 0.0154 | $32.00 | 0.123
Valve Spring | LC 095J 04 S316 | DH-VT-P001 | Ensures push rod engagement and smooth valve lift/return | 316 stainless steel | -- | Lee Spring | 8 | $9.45 | 0.0238 | $75.60 | 0.190
Oil seal | AS568-56 | DH-VT-P005 | Ensures oil does not leak out into cylinder head | Nitrile | -- | Marco Rubber and Platics | 8 | $0.15 | 0.01 | $1.20 | 0.080
Camshaft Timing Chain | 25A2 | DH-VT-P004 | Connects camshaft and crankshaft sprockets | Medium Carbon Steel | -- | Renold | 1 | $8.85 | 2.375 | $8.85 | 2.375
Hydraulic Lifter | 84000-12 | -- | Helps transfer load between cam and push rod | -- | -- | Comp Cams | 4 | $65.99 | 1 | $263.96 | 4.000
Camshaft Sprocket Retaining Bolt | 92316A710 | -- | 1/2-13 0.75" flanged hex bolt | High-Strength Grade 8 Steel | -- | McMaster Carr | 1 | $0.94 | 0.091 | $0.94 | 0.091
Camshaft Retaining Ring | 93416A315 | -- | 1" OD Heavy Duty External Retaining Ring | 15-7 PH Stainless Steel | -- | McMaster Carr | 1 | $8.68 | 0.01 | $8.68 | 0.010
Crankshaft Sprocket Retaining Bolt | 92316A622 |  | 3/8-16 0.75" flanged hex bolt | High-Strength Grade 8 Steel | -- | McMaster Carr | 1 | $0.39 | 0.045 | $0.39 | 0.045
Lubrication and Cooling
Oil Pan | -- | -- | Part of the crankcase, not actually a separate part | -- | -- | -- | -- | -- | -- | -- | --
Dipstick Tube | -- | -- | Also part of the crankcase, not a truly original part | -- | -- | -- | -- | -- | -- | -- | --
Oil Pump | 03-1054 | DH-LC-P001 | Oil Prelube / Scavenge Pump SuperX, 1/2" NPT x 1/2" BSPP Male exit/entry, 3.200" x 7.500", 4.0 GPM (15A Fuse) | -- | -- | RB Racing | 1 | $395.00 | 9.46 | $395.00 | 9.460
Pressure Relief Valve (Main Channel) | A60871094826OES | DH-LC-P002 | Regulates pressure at main drilling inlet | -- | -- | Advance Auto Parts | 1 | $8.37 | 0.25 | $8.37 | 0.250
Pressure Relief Valve (Filters) | A60871094826OES | DH-LC-P003 | Regulates pressure at filter inlet | -- | -- | Advance Auto Parts | 1 | $8.37 | 0.25 | $8.37 | 0.250
Oil Temperature Sensor | 17 11 1 437 362 | DH-LC-P008 | AT Cooler Thermostat | -- | -- | URO Parts | 1 | $35.63 | 0.2 | $35.63 | 0.200
Coolant Pump | 9013 | DH-LC-P009 | EBP25 Electric Booster Pump | -- | -- | Davies Craig | 1 | $185.00 | 2.19 | $185.00 | 2.190
Oil Strainer | 12-1542 | DH-LC-P010 | Includes: strainer, gasket, and pin | -- | -- | V-Twin Manufacturing | 1 | $15.95 | 0.05 | $15.95 | 0.050
Check Valve (pump outlet) | 03-1036 | DH-LC-P011 | 03-1036 Check valve, 1/2" NPT 1psi backflow | -- | -- | RB Racing | 1 | $40.50 | 0.1 | $40.50 | 0.100
Hose Barb Fitting | 03-1043 | DH-LC-P012 | 03-1043 1/2" Hose Barb Fitting | -- | -- | RB Racing | 2 | $15.00 | 0.01 | $30.00 | 0.020
Drain plug sealing O-ring | -13 | DH-LC-P014 | Seals oil into crankcase | Nitrile | -- | Marco Rubber and Plastics | 1 | $0.20 | 0.01 | $0.20 | 0.010
Drain Plug | BMS008Y | DH-LC-P015 | Screws into lowest point on oil pan to be removed for oil change | ASTM A320 Steel | -- | Motosport | 1 | $6.95 | 0.08 | $6.95 | 0.080
Dipstick | 40-0470 | DH-LC-P016 | Measures level of oil, screws into dipstick tube | High Density Polyethylene | -- | V-Twin Manufacturing | 1 | $2.12 | 0.2 | $2.12 | 0.200
Thermostat | 7200-195 | DH-LC-P017 | Regulates coolant flow based on temperature | -- | -- | Fail-Safe | 2 | $14.99 | 0.13 | $29.98 | 0.260
Oil Manifold Mounting Bolts | 03-1045 | DH-LC-P017 | 03-1045 Mounting Bolts (pack of 4) | Zinc Yellow-Chromate Plated Grade 8 Steel | -- | RB Racing | 1 | $7.95 | 0.16 | $7.95 | 0.160
Main Crankshaft Bearing (top) | Custom Designed Part (no specific part #) | DH-LC-P018 | Simple Hydrodynamic Bearing | AST800 Wrapped Steel w/ Bronze | -- | Mechanical Power | 2 | $19.27 | 0.24 | $38.55 | 0.480
Main Crankshaft Bearing (bottom) | Custom Designed Part (no specific part #) | DH-LC-P019 | Simple Hydrodynamic Bearing | AST800 Wrapped Steel w/ Bronze | -- | Mechanical Power | 2 | $19.27 | 0.23 | $38.55 | 0.460
Connecting Rod Bearing (bottom) | Custom Designed Part (no specific part #) | DH-LC-P020 | Simple Hydrodynamic Bearing | AST800 Wrapped Steel w/ Bronze | -- | Mechanical Power | 3 | $14.47 | 0.14 | $43.42 | 0.420
Connecting Rod Bearing (top) | Custom Designed Part (no specific part #) | DH-LC-P021 | Simple Hydrodynamic Bearing | AST800 Wrapped Steel w/ Bronze | -- | Mechanical Power | 3 | $14.47 | 0.13 | $43.42 | 0.390
Camshaft Bearing (top) | Custom Designed Part (no specific part #) | DH-LC-P022 | Simple Hydrodynamic Bearing | AST800 Wrapped Steel w/ Bronze | -- | Mechanical Power | 4 | $17.62 | 0.03 | $70.50 | 0.120
Camshaft Bearing (bottom) | Custom Designed Part (no specific part #) | DH-LC-P023 | Simple Hydrodynamic Bearing | AST800 Wrapped Steel w/ Bronze | -- | Mechanical Power | 4 | $17.62 | 0.03 | $70.50 | 0.120
Auxiliary Crankshaft Bearing (top) | Custom Designed Part (no specific part #) | DH-LC-P024 | Simple Hydrodynamic Bearing | AST800 Wrapped Steel w/ Bronze | -- | Mechanical Power | 1 | $11.12 | 0.02 | $11.12 | 0.020
Auxiliary Crankshaft Bearing (bottom) | Custom Designed Part (no specific part #) | DH-LC-P025 | Simple Hydrodynamic Bearing | AST800 Wrapped Steel w/ Bronze | -- | Mechanical Power | 1 | $11.12 | 0.02 | $11.12 | 0.020
Piston Pin Bearing | NB-1457 | DH-LC-P026 | Needle Bearing, #: NB-1457 | -- | -- | Parts Unlimited | 2 | $7.95 | 0.02 | $15.90 | 0.040
Piston Pin Bearing (ring) | no unique # (part of bearing) | DH-LC-P027 | Needle bearing ring | Carbon Chromium Bearing Steel | -- | Parts Unlimited | 2 | $0.00 | 0 | $0.00 | 0.000
Piston Pin Bearing (needle) | no unique # (part of bearing) | DH-LC-P028 | Needle bearing needle | Carbon Chromium Steel | -- | Parts Unlimited | 36 | $0.00 | 0 | $0.00 | 0.000
90 degree pump adapter | 03-1049 | DH-LC-P029 | 90 fitting for inlet/outlet of pump | -- | -- | RB Racing | 2 | $27.50 | 0.1 | $55.00 | 0.200
Dipstick O-ring | AS568-56 | DH-LC-P030 | O-ring to seal dipstick | Nitrile | -- | Marco Rubber and Plastics | 1 | $0.20 | 0.01 | $0.20 | 0.010
Injection
Fuel injector | F 02U V00 868-01 | DH-IN-P001 | HDEV5.2 High pressure injector. Flow rate at 100 bar: up to 1,640 g/min (n-heptane) for port injection | -- | Purchased | Bosch | 2 | $65.00 | 0.149914 | $130.00 | 0.300
Spark plug | 9613 | DH-IN-P002 | Bosch Double Iridium Spark Plug | -- | Purchased | Bosch | 2 | $7.23 | 0.11 | $14.46 | 0.220
Throttle Position Sensor | C701260454BOS | DH-IN-P004 | Throttle Position Sensor | -- | Purchased | Bosch | 1 | $67.00 | 0.8 | $67.00 | 0.800
Starter Motor | 80-1001 | DH-IN-P005 | All Balls Starter Motor | -- | Purchased | All Balls | 1 | $287.50 | 8.8 | $287.50 | 8.800
Fuel injector o-rings | 1222595 | DH-I-P006 | 13/16" Inside x 1" Outside Diam | Nitrile | Purchased | Marco Rubber and Plastics | 16 | $3.40 | 0.05 | $54.40 | 0.800
Intake/Exhaust
Intake Manifold | -- | DH-IE-M001 | Directs air into the cylinder head | Stainless Steel AISI 405 | Die Casting | -- | 1 | $11 | 2.7618 | $11.00 | 2.762
Exhaust Manifold 1 | -- | DH-IE-M002 | Directs air out of the cylinder head on the left side | Stainless Steel AISI 405 | Die Casting | -- | 1 | $12 | 2.9604 | $12.00 | 2.960
Exhaust Manifold 2 | -- | DH-IE-M003 | Directs air out of the cylinder head on the right side | Stainless Steel AISI 405 | Die Casting | -- | 1 | $14 | 4.0822 | $14.00 | 4.082
Exhaust Gasket | AS-568-029 | DH-IE-P001 | Seals gap betwen exhaust manifold and cylinder head | Nitrile | -- | Marco Rubber and Plastics | 4 | $0.20 | 0.0006 | $0.80 | 0.002
Intake Gasket | AS-568-029 | DH-IE-P002 | Seals gap betwen intake manifold and cylinder head | Nitrile | -- | Marco Rubber and Plastics | 4 | $0.20 | 0.0006 | $0.80 | 0.002
Air Intake Filter | 29400020 | DH-IE-P003 | Filters air before it enters the intake manifold | -- | -- | Harley Davidson | 1 | $59.95 | 2 | $59.95 | 2.000
Catalytic Converter | 444106 | DH-IE-P004 | Lessens pollutants coming from exhaust manifold | -- | -- | Magna Flow | 1 | $206.99 | 4.6 | $206.99 | 4.600
O2 Sensor | 15109 | DH-IN-P003 | Bosch Exact Fit Oxygen Sensor | -- | -- | Bosch | 2 | $60 | 0.28 | $120 | 0.560
TOTALS |  |  |  |  |  |  |  |  |  | $4352.34 | 214.224
