trm79/Motorcycle-Engine-Design/Other Work/02 Crucial Part Dimensions.xlsx

Sheet: Master Dimensions Sheet
 | Dimension Name | Dimension Value | Units | Who Calculated/Selected It? | How Was It Calculated/Selected? | Any Relevant Links/Notes
Powertrain
 | Cylinder Bore | 4.0625 | in | Clarissa | CDR slide 9 equations
 | Cylinder Stroke | 4.1875 | in | Clarissa | CDR slide 9 equations
 | Bore/Stroke Ratio | 0.97 | - | Clarissa | CDR slide 9 equations
 | Rod Ratio | 4 | - | Clarissa | Calculations Tab 1
Connecting Rod | Crankpin Offset Angle | 90 | degrees | Mere | equation from link | https://www.cycleworld.com/2016/02/01/motorcycle-v-twin-and-parallel-twin-and-flat-twin-engine-tech-sound-insights | X = 180 - (2*V_angle)
 | Connecting Rod Length | 8.375 |  | Clarissa | Pulkrabek PDT pg. 50
 | Piston-Connecting Rod Interface Diameter | 1.26 | in | Adam | Calculations Force Analysis Tab | The following 4 values add up to the minimum 800 sq mm cross sectional area requirement needed from the force analysis
 | Piston-Connecting Rod Interface Width | 0.6 | in | Adam | Calculation Force Analysis Tab
 | Connecting Rod Crankshaft Interface Diameter | 2.44 | in | Adam | Calculation Force Analysis Tab
 | Connecting Rod Crankshaft Interface Width | 0.6 | in | Adam | Calculation Force Analysis Tab
 | Forked Connecting Rod Crankshaft Interface Width | 0.59 | in | Adam
 | Crank Offset | 2.09375 | in | Clarissa | PDF Pg. 50 Pulkrabek
 |  | 5.318125 | cm
 | Oil Hole Diameter | 0.15 | in | Adam | Rex
Crankshaft | Cylinder Spacing | 4.875 | in | James | Hoag ch 16, p. 16
 | Crankpin (Conrod-Crankshaft) Diameter | 2.4375 | in | James | Hoag ch 16, p. 17
 | Crankpin Journal Width | 1.421875 | in | James | Hoag ch 16, p. 18
 | Main Journal Diameter | 3.046875 | in | James | Hoag ch 16, p. 19
 | Main Journal Width | 1.625 | in | James | Hoag ch 16, p. 20
 | Web (cheek) Thickness | 1.015625 | in | James | Hoag ch 16, p. 21
 | Crankpin fillet | 0.1625 | in | James | Hoag ch 16, p. 22
 | Main fillet | 0.1625 | in | James | Hoag Eqn. 16.1
 | Pin Overlap | 0.6484375 | in
 | Offset of Rod Journal | 2.09375 |  |  | stroke / 2
 | Counterweight
 | Linear offset of cranks | 5.078125
 | Mean Piston Speed
Valvetrain
Cam |  |  | in | Mere | Valve lift (ex) = Rlg - Rsm
 |  |  | in | Mere | Arbitrary
 | Shaft Diameter | 1 | in | Mere |  | https://www.google.com/search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
 | Shaft Length | 1 | in
 | Thickness | 0.5 | in |  | Arbitrary
 | Diameter
Rocker | Rocker Ratio (Intake) | 1.128912665
 | Rocker Ratio (Exhaust) | 1
 | Valve Angle (btw valves) | 45 | degrees
Engine Block
Injection
Intake valves | head diameter | 1.462 | in | Grace | Chapter 6 Heywood | .36*bore
 | Inner seat diameter | 1.336 | in | Grace | Heywood | D/1.095
 | Stem diameter | 0.280 | in | Grace | Heywood | .21*Dseat
 | Valve lift | 0.575 | in | Mere | R.S. Khurmi and J.K. Gupta | Dport/(4cos(45))
 | Seat Width | 0.073 | in | Mike | Heywood
 | Mean Seat Diameter | 1.389 | in | Mike | Heywood 6.8
 | Valve curtain area | 2.590 | in^2 | Grace | Hoag | pi*D*.98*Lift
 | Port area | 1.147 | in^2 | Grace | Hoag | pi/4*(seat Diameter^2 - Stem Diam ^2)
 | Valve stem length | 4.141 | in | Mere
 | Port diameter | 1.209 | in | Grace | Hoag | d=2*sqrt(PortArea/pi)
 | Seat angle | 45.000 | degrees | Grace | Heywood | Based off Heywood
 | Overall thickness of head | 0.120 | in | Grace | Heywood | .1*D
Intake Spring | Total load on valve spring | 39.670 | lb | Grace | Internal Combustion Engine Parts
 | Diameter of wire | 0.0932 | in | Grace | Internal Combustion Engine Parts
 | Mean diameter of spring coil | 0.746 | in | Grace | Internal Combustion Engine Parts
 | Outer diameter of spring coil | 0.839 | in | Grace | Internal Combustion Engine Parts
 | Turns in coil | 5.000 | turns | Grace | Internal Combustion Engine Parts
 | turns in coil (squared & ground ends) | 7.000 | turns | Grace | Internal Combustion Engine Parts
 | Max compression produced | 0.593 | in | Grace | Internal Combustion Engine Parts
 | Free length | 1.333 | in | Grace | Internal Combustion Engine Parts
 | Pitch of coil | 0.222 | in | Grace | Internal Combustion Engine Parts
 | spring constant (k) | 77.800 | lb/in | Clarissa | Motion study
Exhaust valves | head diameter | 1.219 | in | Grace | Heywood | .3*bore
 | Inner seat diameter | 1.103 | in | Grace | Heywood | D/1.105
 | Stem diameter | 0.2647 | in | Grace | Heywood | .24*Dseat
 | Valve lift | 0.5095 | in | Grace | R.S. Khurmi and J.K. Gupta | Dport/(4cos(45))
 | Seat Width | 0.0609 | in | Mike | heywood 6.8
 | Mean Seat Diameter | 1.1578 | in | Mike | heywood
 | Valve curtain area | 1.9119 | in^2 | Grace | Hoag | pi*D*.98*Lift
 | Port area | 0.9004 | in^2 | Grace | Hoag | pi/4*(seat Diam^2 - Stem Diam ^2)
 | Valve stem length | 4.1410 | in | Mere
 | Port diameter | 1.0707 | in | Grace | Hoag | d=2*sqrt(PortArea/pi)
 | Seat angle | 45.000 | degrees | Grace | Heywood | Based off Heywood
 | Overall thickness of head | 0.110 | in | Grace | Heywood | .09*Seat Diameter
Exhaust Spring | Total load on valve spring | 33.843 | lb | Grace | Internal Combustion Engine Parts
 | Diameter of wire | 0.09524 | in | Grace | Internal Combustion Engine Parts
 | Mean diameter of spring coil | 0.7619 | in | Grace | Internal Combustion Engine Parts
 | Outer diameter of spring coil | 0.85714 | in | Grace | Internal Combustion Engine Parts
 | Turns in coil | 5 | turns | Grace | Internal Combustion Engine Parts
 | turns in coil (squared & ground ends) | 7 | turns | Grace | Internal Combustion Engine Parts
 | Max compression produced | 0.5927 | in | Grace | Internal Combustion Engine Parts
 | Free length | 1.348 | in | Grace | Internal Combustion Engine Parts
 | Pitch of coil | 0.2247 | in | Grace | Internal Combustion Engine Parts
 | Spring constant (k) | 77.800 | lb/in | Clarissa | Motion study
Exhaust |  |  |  |  |  |  |  | AQS BHV C
Cooling
Lubrication
Air Intake

Sheet: Piston Dimensions
Piston Dimensions
Thickness of the Piston Head (th): | 0.605 in.
Radial Thickness of the Ring (t1): | 0.179 in.
Axial Thickness of Ring (t2): | 0.179 in.
Width of the Top Land (b1): | 0.726 in.
Width of the other Lands (b2): | 0.134 in.
Maximum Thickness of Barrel (t3): | 0.480 in.
Piston Wall Thickness Towards the Open End (t4): | 0.163 in.
Gap between the rings (tL): | 0.223 in.
Second Ring: | 0.163 in.
Depth of Ring Groove (Dr): | 0.194 in.
Length of Piston Skirt (Lps): | 2.031 in.
Length of Piston (L): | 3.562 in.
Piston Pin Diameter (Pdo): | 1.137 in.
Diameter of Thickening of Piston Pin (d): | 1.219 in.
Depth of Thickening of Piston Pin (b): | 1.219 in.

Sheet: ConRod Dimension Calcs
Calcs Needed | Connecting Rod Calculations |  |  |  |  |  | Fork Cross Sectional Area |  |  | Reg Cross Sectional Area
 | R = r/a |  |  |  | Cylinder Angle | Crankpin Offset | Design Force | 279.7 | kN | Design Force | 194.1 | kN
Max Pressure | r = connecting rod length = R*a |  |  |  | 45 | 90 | Yield Strength | 814 | MPa | Yield Strength | 814 | MPa
Temperature | a = crank offset = S/2 |  |  |  |  |  | Required Cross Sectional Area | 343.6 | mm^2 | Required Cross Sectional Area | 238.4 | mm^2
 | R = 3 |  |  |  |  |  |  | 0.533 | in^2 |  | 0.370 | in^2
 |  |  |  |  |  |  | Actual Cross Sectional Area | 0.99 | in^2 | Actual Cross Sectional Area | 0.749 | in^2
 | Variable | Value (in) | Value (cm) | Description |  |  |  | 638.7 | mm^2 |  | 483.2 | mm^2
 | S | 4.1875 | 10.63625 | Stroke length |  |  | Safety Factor | 5.6 |  | Safety Factor | 6.1
 | R | 3 | 3 | Ratio of conrod length to crank offset
 | a | 2.09375 | 5.318125 | crank offset |  |  | Ring Hoop Thickness
 | r | 6.28125 | 15.954375 | conrod length |  |  | Tensile Reciprocating Force | 65500.0 | N
 |  |  |  |  |  |  | Shear Strength | 407000000 | Pa
 | Rod Length/Stroke | 1.5 |  |  |  |  | Required Cross Sectional Area | 0.000161 | in^2
 |  |  |  |  |  |  |  | 1.61 | cm^2
 |  |  |  |  |  |  |  | 0.28 | in^2
 | Max Angles | (deg)
 | Sm end w/ vertical | 19.5
 | Lg end w/horiz | 70.5

Sheet: ConRod Force Analysis
Combustion Force (Ideal) |  | Units | Combusiton Force (Non Ideal) |  | Units
Max Pressure from ideal (Pa) | 11768300 | Pa | Max Presssure non ideal (Pa) | 7961200 | Pa |  | 7961.2 | kPa
Bore (m) | 0.1031875 | m | Bore (m) | 0.1031875 | m |  | 10.31875 | cm
Piston Head Area (m^2) | 0.008362652731 | m^2 | Piston Head Area (m^2) | 0.008362652731 | m^2 |  | 83.62652731 | cm^2
Combustion Force (N) | 98414.20614 | N | Combusiton Force (N) | 66576.75092 | N |  | 66.57675092
Safety Factor | 3 |  | Safety Factor | 1
Design Load (kN) | 295.2 |  | Design Load (kN) | 66.6
Reciprocating Force (tensile) |  |  | Reciprocating Force (compressive) |  |  |  | Reciprocating Force (tensile) y-fork |  |  | Reciprocating Force (compressive) y-fork
Piston Mass | 0.963 | kg | Piston Mass | 0.963 | kg |  | Pistion Mass | 0.963 | kg | Pistion Mass | 0.963 | kg
ConRod Mass | 0.87 | kg | ConRod Mass | 0.87 | kg |  | Y-ConRod Mass | 2.10 | kg | Y-ConRod Mass | 2.10 | kg
Crank Radius (stroke/2) | 0.0532 | m | Crank Radius (stroke/2) | 0.0532 | m |  | Crank Radius (stroke/2) | 0.0532 | m | Crank Radius (stroke/2) | 0.0532 | m
ConRod Length (pin to pin, measured from centerpoints) | 0.213 | m | ConRod Length (pin to pin, measured from centerpoints) | 0.213 | m |  | ConRod Length (pin to pin, measured from centerpoints) | 0.2128 | m | ConRod Length (pin to pin, measured from centerpoints) | 0.2128 | m
Angular Velocity | 590.7 | rad/sec | Angular Velocity | 590.7 | rad/sec |  | Angular Velocity | 590.7 | rad/sec | Angular Velocity | 590.7 | rad/sec
Theta | 0 | rad | Theta | 0 | rad |  | Theta | 0 | rad | Theta | 0 | rad
Lambda | 0.250 |  | Lambda | 0.250 |  |  | Lambda | 0.250 |  | Lambda | 0.250
Reciprocating Force (tensile) | 42501.9 | N | Gas Force | 22192.3 | N |  | Reciprocating Force (tensile) | 71041.2 | N | Gas Force | 22192.3 | N
 | 42.5 | kN | Reciprocating Force (compressive) | 64694.2 | N |  |  | 71.0 | kN | Reciprocating Force (compressive) | 93233.4 | N
 |  |  |  | 64.7 | kN |  |  |  |  |  | 93.2 | kN
Helpful Constants
density | 7870 | kg/m^3
 | 7.87 | g/cm^3 | Beam Force
Normal Volume | 110.48 | cm^3 | Reg | 43040.04 | N
 | 6.74 | in^3 | Fork | 103949.89 | N
Redline | 5641 | rpm | Max Moment
 | 590.7 | rad/s | Reg | 1175.09 | Nm
Stroke | 0.10636 | m | Fork | 2838.06 | Nm
Tensile Strength | 814 | MPa | Critical Force | 16838105013 | N
Shear Strength | 407 | MPa | Johnson Buckling | -139430370191 | N
Forked Volume | 16.29 | in^3 |  | -139430370.2 | kN
 | 266.8302 | cm^3 | Euler Buckling | 256744.8782 | N | 256744.8782
Izz | 9.6571e-05 | kg*m^2 |  | 256.7 | kN
 | 0.33 | lb*in^2 | Rankin Buckling | 9118.178025 | N
Modulus of Elasticity | 200 | GPa |  | 9.1 | kN
xx M of I | 18.94 | lb*in^2
 | 5.89e-09 | kg*m^2
mass | 0.8694776 | kg
Rad of Gyr | 8.230542246e-05 | m^2
Slend Ratio | 1292.75
Test Value 16.39 | 69.6 |  | Safety Factor | 3.9
Forked Cross Sectional Area | 0.768 | in^2
 | 5.0 | cm^2
Forked Max Force | 403223.04 | N
 | 403.2 | kN
Forked Factor of Safety | 4.3

Sheet: ConRod Bearing Calcs
Max Static Load on Piston End (both) | 64.7 | kN
Max Static Load on Crank End (Reg) | 64.7 | kN
Max Static Load on Crank End (Fork) | 46.6 | kN
Crankshaft Diameter | 2.44 | in
 | 6.1976 | cm
Piston Pin Diameter | 1.26 | in
 | 3.20 | cm
Bearing Length Reg | 0.6 | in
 | 1.524 | cm
Bearing Length Fork | 0.6 | in
 | 1.524 | cm
Oil Viscosity
Max RPM | 5641
Min RPM | 800
L/D Ratio Crank | 0.25
L/D Ratio Piston | 0.48

Sheet: IntakeExhaust Calcs
Helpful Constants |  | Units |  | Needed Dimensions | Units
Bore | 4.1 | in |  | Required Inlet Area | m^2
 | 10.3 | cm
Stroke | 4.2 | in
 | 10.6 | cm
1 Cyl Displacement | 889.5 | cm^3
Total Displacement | 1778.9 | cm^3
Redline RPM | 5641 | RPM
Redline RPS | 94.0 | RPS
Volume Per Second | 41812.6 | cm^3/s
 | 0.04181 | m^3/s
Density | 1.2 | kg/m^3
Mass Flow per Second | 0.0502 | kg/s
Intake Pressure | 101.3 | kPa
 | 101300 | Pa | kg/m*s^2
 |  |  | N=kgm/s^2
 |  |  | Pa=kg/m*s^2

Sheet: Sprocket Calcs
Chain Length based on Center-to-Center distance |  |  |  | Horspower needed to be transmitted to Camshaft (using Genesis's Group Report)
Parameters | Variable | Value |  | Parameters | Variable | Value | Units
Center-to-Center Distance (in) | C | 2.782905956 |  | Spring Constant | k | 77.8 | lb/in
Number of Teeth (Large Sprocket) | N | 36 |  | Lift | Lv(theta) | 0.5095 | in | 12.9413 | mm
Number of Teeth (Small Sprocket) | n | 18 |  | Pressure Angle | phi | 0.464257581
Length of Chain in Pitches | L | 50 |  | Prime Radius | Rp | 0.591 | in | 15.0114 | mm
Pitch of Chain | P | 0.25 |  | Spring Preload | p | 0.1 |  | 2.54
c-c in pitches |  | 11.13162383 |  | Force | F | 53.03234951 | lbf | 235.8878906 | N
length in inches |  | 12.5 |  | Lever Arm | L | 0.5510893489 | in | 13.99766946 | mm
 | Spring Preload |  |  | RPM | RPM | 2964.5 | rev/min
 | FS | 1.5 |  | Torque | T | 29.22556296 | lb in | 3.302488614 | Nm
 | Fnet,in | 58.73147812 |  | Power | P | 1.374679594 | hp
 | Fnet,ex | 47.4191
 | Fpre,in | 7.78
 | Fpre,ex | 7.78
 | Kin | 77.8
 | Kex | 77.8
 | Xpre,in | 0.1
 | Xpre,ex | 0.1 |  | Camshaft Torque and Horspower (T = k * x^2)
 |  |  |  | Parameters | Variable | Value | Units
 |  |  |  | Spring Constant | k | 77.8 | lb/in
small sprocket diameter | 1.56775 | 1.57 |  | Valve displacement | x | 0.6095 | in
large sprocket diameter | 3.0075 | 3.01 |  | Torque | T | 1.206084514 | ft lb
min c-c distance | 2.287625 | 2.29 |  | Alt HP | HP | 0.680776379 | hp
 | 3.4314375 |  |  | HP w SF |  | 1.021164568 | hp
 |  |  |  | 33.30308223
 |  |  |  |  |  | lever arm | 0.5220870964
 |  |  |  |  |  | torque | 30.66294688
 | Quick Selector Chart |  |  |  |  |  | 2.555245573
 | Parameters | Variable | Value | Units |  | hp | 1.442312548 | 2.163468822
 | Pitch | p | 0.25 | in |  | Tension | 32.1108545
 | large Sprocket RPM | N | 5929 | RPM
 | large Sprocket Teeth | T | 18 | teeth
 | Linear Chain Speed | S | 2223.375 | ft/min
 | Torque | t | 14.47301417 | in lb
 | Horsepower | HP | 2.042329137 | hp
 | Working Load | WL | 30.31286289 | lb |  | Working load of chain is 134 lb, so this is well under the limit
 |  |  |  |  |  | For continuous use max load is 1/8 of that, or |  | 16.75

Sheet: Flywheel Calcs
Emotor | 1331.86 | W |  | w_diff | 2.51 | rad/s |  | thickness | 1.8 | in
Ework | 209.11 | W |  | w1 | 82.52 | rad/s |  | Inner radius | 1 | in
Eflywheel | 1122.75 | W |  | w2 | 85.03 | rad/s |  | outer radius | 6.5 | in
 | 26.95 | J |  |  |  |  |  | mass | 36 | lb
w_mean | 800 | rpm |  |  |  |  |  | density | 7750 | lb
 | 83.78 | rad/s |  | I | 0.13 | kg*m^2
CdA | 0.5 | m^2
p | 1.167 | kg/m^3
v | 100 | km/h
 | 27.78 | m/s |  |  |  |  |  | 0.3199457137
Cf | 0.03
 |  |  |  |  |  | 1827.28
Stroke | Pressure (kPa) | Vdot (m^3/s) | Avg energy (W) |  | Overall Average Energy | 209.1117742
Intake | 101.3 | 0.167 | -16.95 |  | Max fluctuation | 1122.75
Compression | 2542.9 | 0.167 | -425.41
Power | 7961.2 | 0.167 | 1331.86
Exhaust | 317.1 | 0.167 | -53.06
 |  |  |  |  | Friction Force | 5307.74 | N
atmosphere | 101.3 | kPa |  |  | Piston losses | 564.54 | J
Bore | 4.063 | in |  |  |  | 23522.67 | W
 | 10.32 | cm |  |  | Chem Energy | 3222.32 | lb
 | 0.10 | m |  |  | mFuel | 0.00016 | J/lb
Stroke | 4.1875 | in |  |  | Energy density | 20139501 | kW
 | 10.64 | cm |  |  | Pout | 33.3
Mean Piston spd | 20 | m/s |  |  | Time | 0.012 | kJ
Vdot | 0.167 | m^3/s |  |  | Eout | 0.3996 | J
time | 0.024 | s |  |  |  | 399.6 | J
 |  |  |  |  | Losses | 2822.72
