trm79/Motorcycle-Engine-Design/Part Files/Powertrain/DH-LC-P026.SLDASM

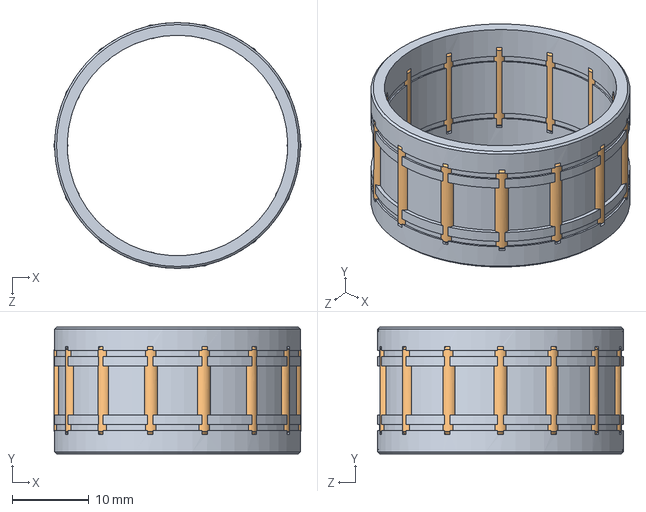
[picture p21: CAD file, 2019-07-24]
Part Files/Powertrain/DH-LC-P026.SLDASM
32.2 x 16.5 x 32.0 mm
DH-LC-P027
DH-LC-P028 x 14
