trm79/Motorcycle-Engine-Design/Part Files/Intake_Exhaust/DH-IE-A002.SLDASM

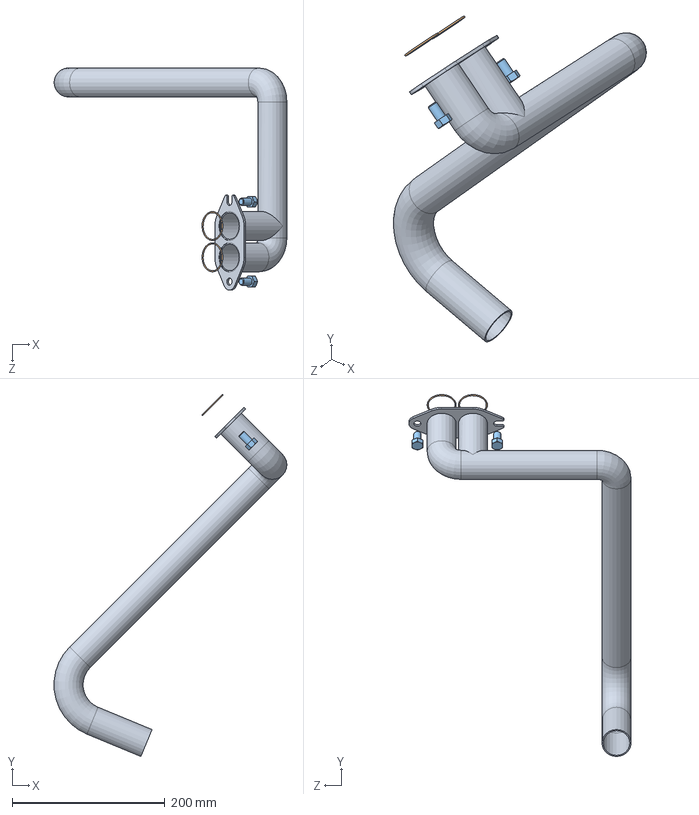
[picture p22: CAD file, 2019-07-24]
Part Files/Intake_Exhaust/DH-IE-A002.SLDASM
304.4 x 473.2 x 290.4 mm
DH-IE-M002
DH-IE-P001 x 2
hex bolt_ai x 2
