trm79/Motorcycle-Engine-Design/Part Files/Valvetrain/DH-VT-SA004.SLDASM

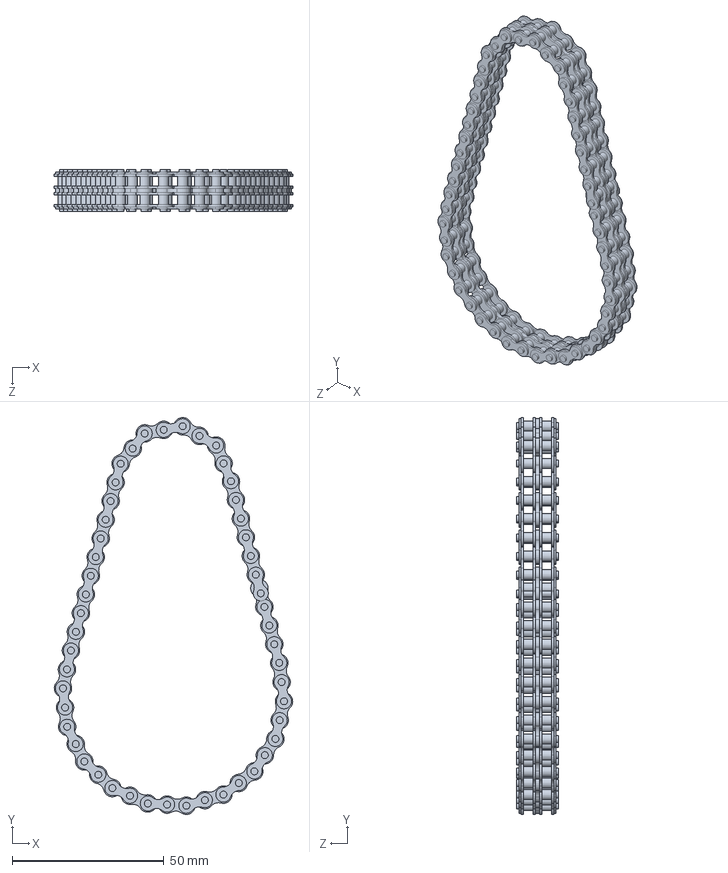
[picture p23: CAD file, 2019-07-24]
Part Files/Valvetrain/DH-VT-SA004.SLDASM
78.5 x 130.7 x 13.7 mm
DH-VT-P005 x 25
