trm79/Motorcycle-Engine-Design/Part Files/Intake_Exhaust/DH-IE-A003.SLDASM

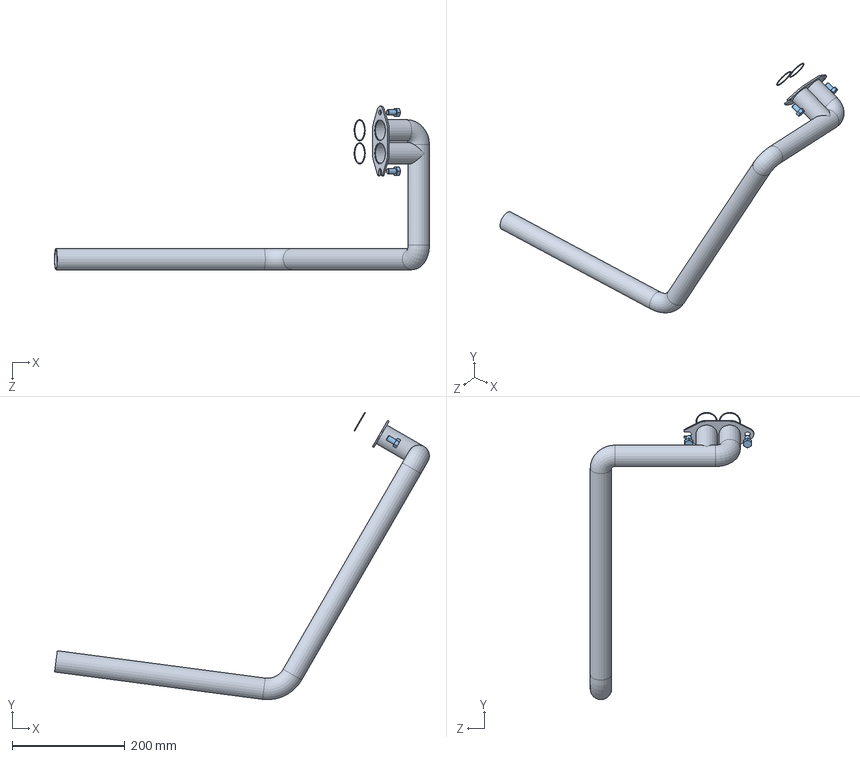
[picture p24: CAD file, 2019-07-24]
Part Files/Intake_Exhaust/DH-IE-A003.SLDASM
665.8 x 510.1 x 290.4 mm
DH-IE-M003
DH-IE-P001 x 2
hex bolt_ai x 2
