trm79/Motorcycle-Engine-Design/Part Files/Intake_Exhaust/Intake Manifold Assembly (Drawings).SLDASM

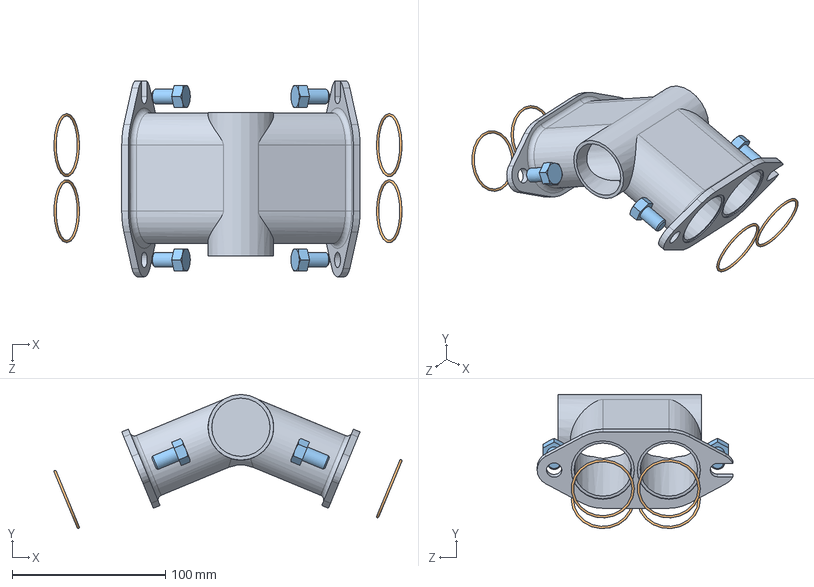
[picture p25: CAD file, 2019-07-24]
Part Files/Intake_Exhaust/Intake Manifold Assembly (Drawings).SLDASM
227.1 x 87.5 x 127.7 mm
DH-IE-M001
DH-IE-P002 x 4
hex bolt_ai x 4
