trm79/Motorcycle-Engine-Design/Part Files/Powertrain/DH-PT-A001.SLDASM

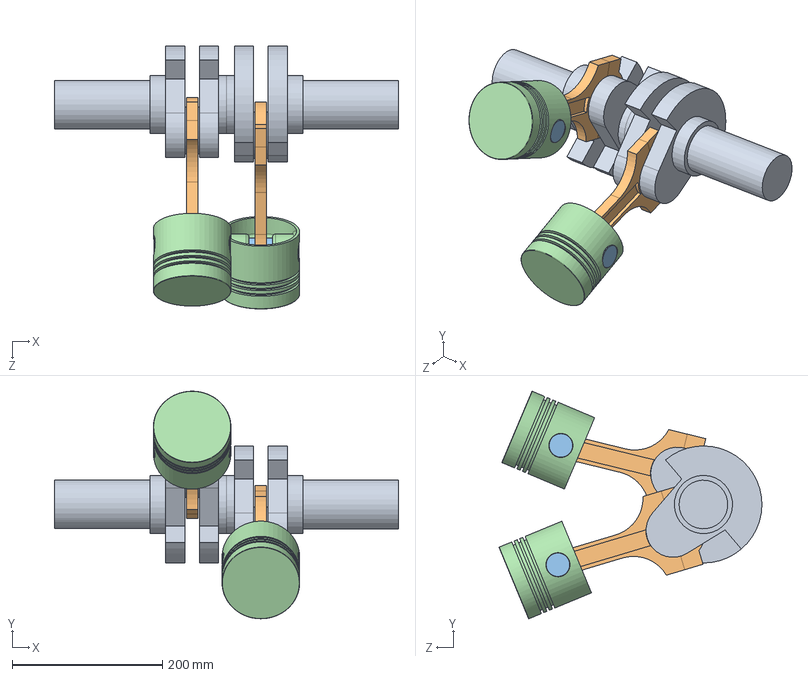
[picture p26: CAD file, 2019-07-24]
Part Files/Powertrain/DH-PT-A001.SLDASM
457.2 x 302.5 x 349.4 mm
DH-PT-M005
DH-PT-M003 x 2
DH-PT-M002 x 2
DH-PT-M001 x 2
