trm79/Motorcycle-Engine-Design/Part Files/Powertrain/Powertrain.SLDASM

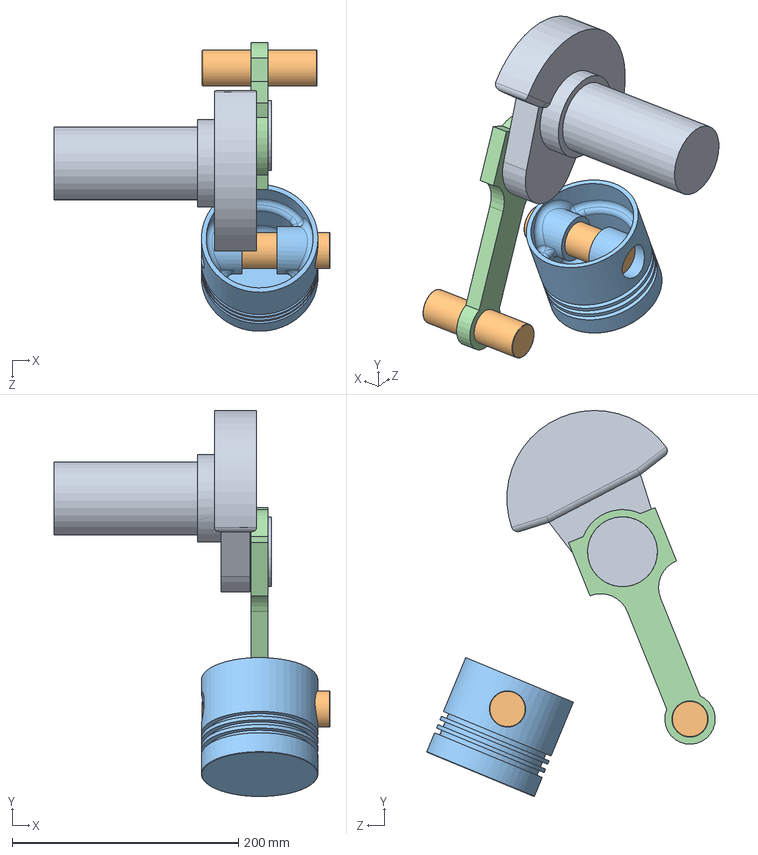
[picture p27: CAD file, 2019-07-24]
Part Files/Powertrain/Powertrain.SLDASM
244.1 x 341.5 x 255.2 mm
Crankshaft2
WristPin1 x 2
Piston WB
ConRod
