trm79/Motorcycle-Engine-Design/Part Files/Valvetrain/DH-VT-A002.SLDASM

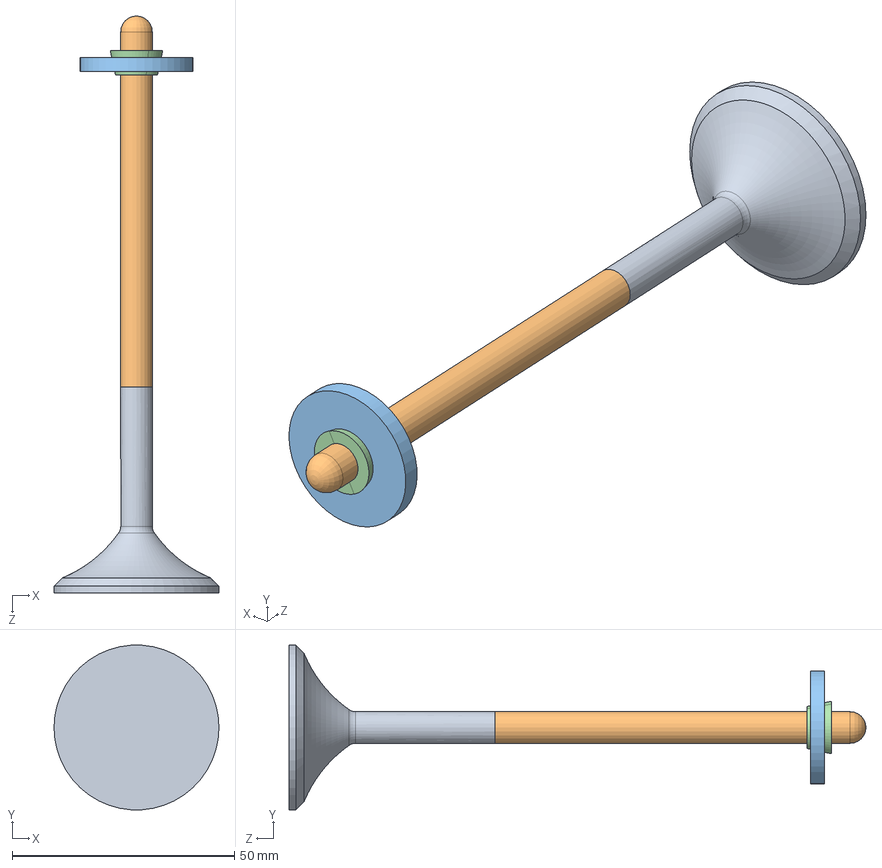
[picture p28: CAD file, 2019-07-24]
Part Files/Valvetrain/DH-VT-A002.SLDASM
37.1 x 37.1 x 129.9 mm
DH-VT-M014
DH-VT-M013
DH-VT-M018
DH-VT-M017 x 2
