trm79/Motorcycle-Engine-Design/Part Files/Engine Block/DH-EB-A001.SLDASM

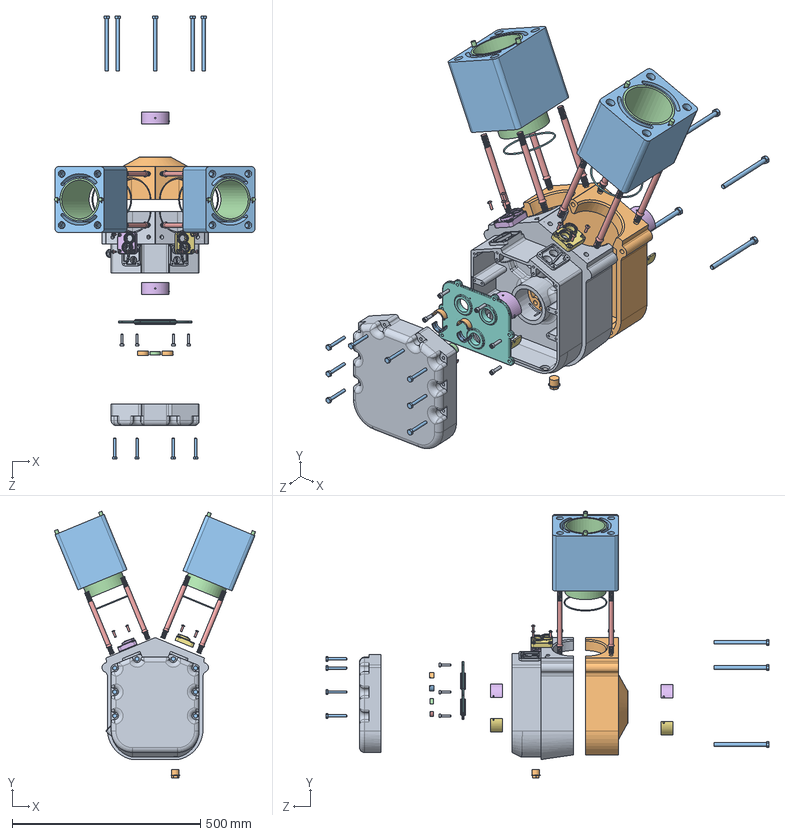
[picture p29: CAD file, 2019-07-24]
Part Files/Engine Block/DH-EB-A001.SLDASM
534.7 x 709.0 x 1177.2 mm
DH-EB-M002
DH-EB-M003
DH-EB-M004 x 2
DH-EB-M005 x 2
DH-EB-M006 x 8
DH-EB-M011
DH-EB-M013
DH-EB-M007
DH-EB-M015
DH-LC-P022 x 2
DH-LC-P023 x 2
DH-LC-P024
DH-LC-P025
DH-LC-P018 x 2
DH-LC-P019 x 2
DH-EB-P001 x 2
socket head cap screw_ai x 6
DH-LC-P015
hex bolt_ai x 13
DH-EB-M023 x 4
socket button head cap screw_ai x 6
