trm79/Motorcycle-Engine-Design/Part Files/Powertrain/DH-PT-A002.SLDASM

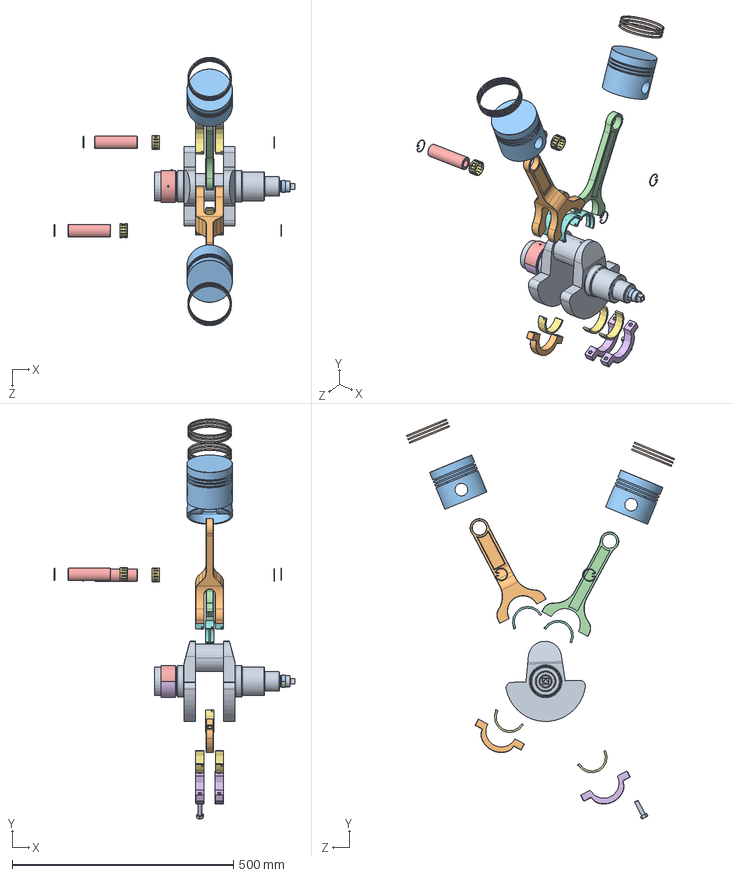
[picture p30: CAD file, 2019-07-24]
Part Files/Powertrain/DH-PT-A002.SLDASM
543.9 x 904.4 x 606.7 mm
DH-PT-M008
DH-PT-M009
DH-PT-M001 x 2
DH-PT-M007
DH-PT-M002 x 2
DH-PT-M006 x 2
DH-LC-P027 x 2
DH-LC-P028 x 28
DH-PT-M010 x 4
DH-PT-M012
DH-LC-P024
DH-LC-P025
DH-LC-P021 x 3
DH-LC-P020 x 2
hex bolt_ai
DH-PT-M011 x 6
