trm79/Motorcycle-Engine-Design/Part Files/Valvetrain/DH-VT-A001.SLDASM

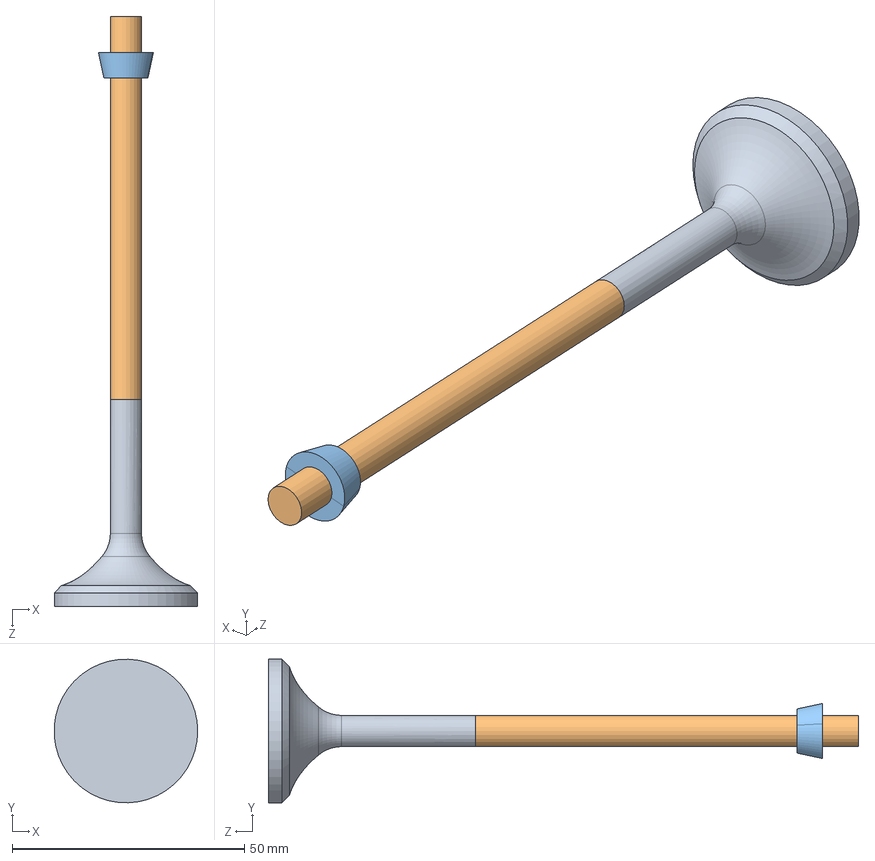
[picture p31: CAD file, 2019-07-24]
Part Files/Valvetrain/DH-VT-A001.SLDASM
30.9 x 30.9 x 127.1 mm
DH-VT-M016
DH-VT-M015
DH-VT-M019 x 2
