trm79/Motorcycle-Engine-Design/Part Files/Engine Block/DH-EB-A002.SLDASM

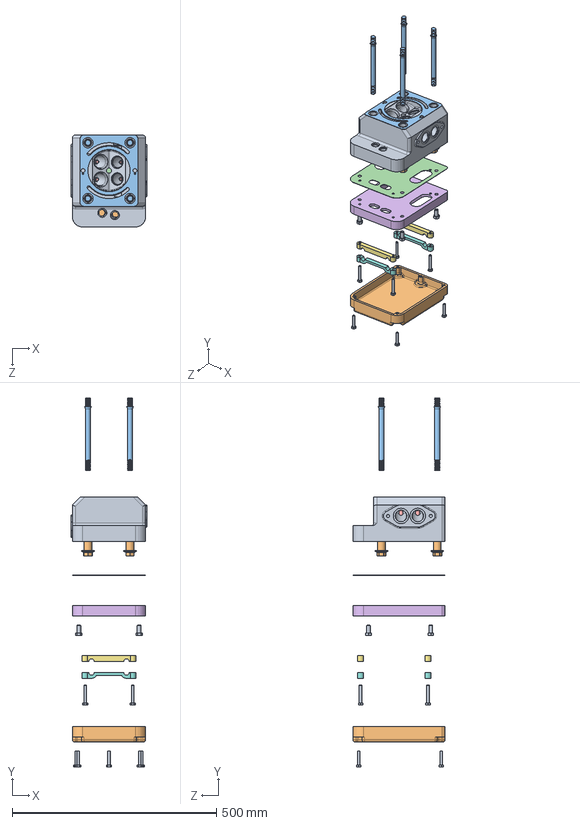
[picture p32: CAD file, 2019-07-24]
Part Files/Engine Block/DH-EB-A002.SLDASM
185.7 x 903.0 x 225.4 mm
DH-EB-M009
DH-EB-M008 x 4
DH-EB-M019
DH-EB-M021
DH-EB-M010 x 4
DH-EB-M012
DH-VT-M008 x 2
DH-VT-M009 x 2
hex bolt_ai x 13
DH-EB-M014
DH-EB-M006 x 4
