trm79/Motorcycle-Engine-Design/Part Files/Engine Block/DH-EB-SA002.SLDASM

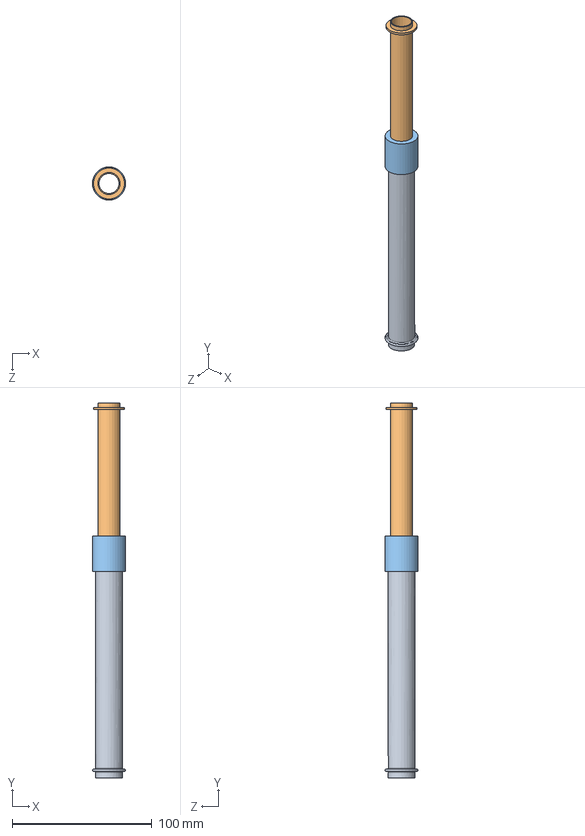
[picture p33: CAD file, 2019-07-24]
Part Files/Engine Block/DH-EB-SA002.SLDASM
23.8 x 267.9 x 23.8 mm
DH-EB-M016
DH-EB-M017
DH-EB-M018
DH-EB-P002
