trm79/Motorcycle-Engine-Design/Part Files/Engine Block/DH-EB-SA003.SLDASM

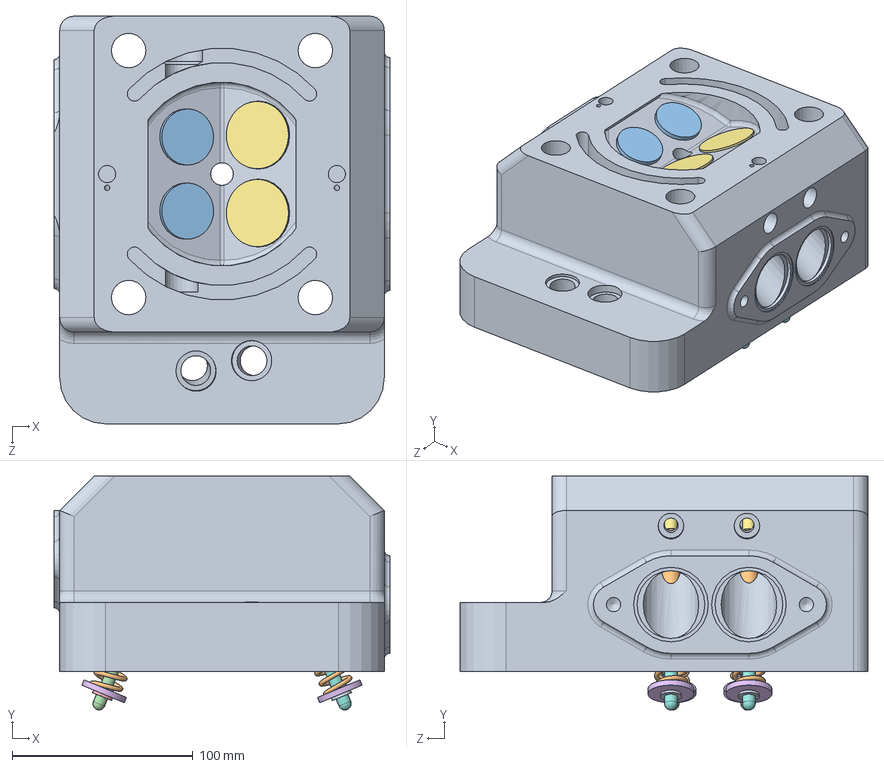
[picture p35: CAD file, 2019-07-24]
Part Files/Engine Block/DH-EB-SA003.SLDASM
185.7 x 129.3 x 225.4 mm
DH-EB-M022
DH-EB-M010 x 4
DH-VT-M016 x 2
DH-VT-M015 x 2
DH-VT-M019 x 4
DH-VT-M018 x 4
DH-VT-M014 x 2
DH-VT-M013 x 2
DH-VT-M017 x 4
DH-VT-P001 x 4
