trm79/Motorcycle-Engine-Design/Other Work/Crankshaft.SLDPRT

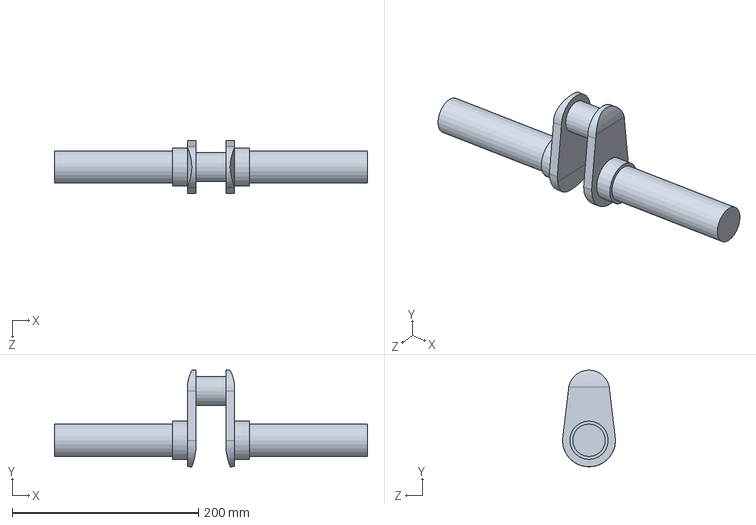
[picture p36: CAD file, 2019-07-24]
Other Work/Crankshaft.SLDPRT
336.5 x 104.0 x 57.1 mm
