trm79/Motorcycle-Engine-Design/Part Files/Engine Block/DH-EB-M015.SLDPRT

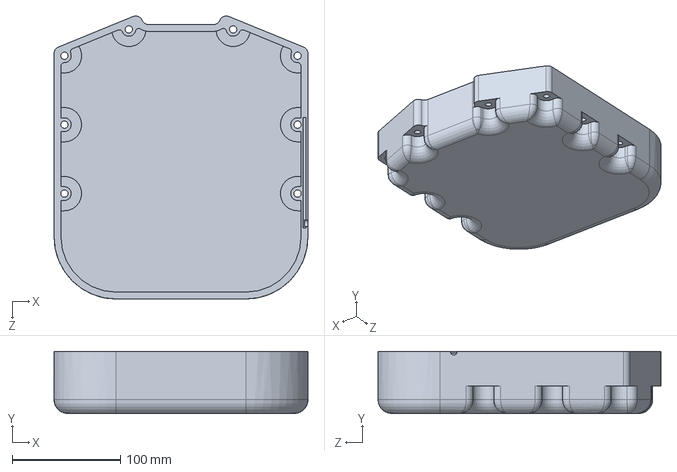
[picture p37: CAD file, 2019-07-24]
Part Files/Engine Block/DH-EB-M015.SLDPRT
234.0 x 57.2 x 260.9 mm
