trm79/Motorcycle-Engine-Design/Part Files/Intake_Exhaust/DH-IE-M002.SLDPRT

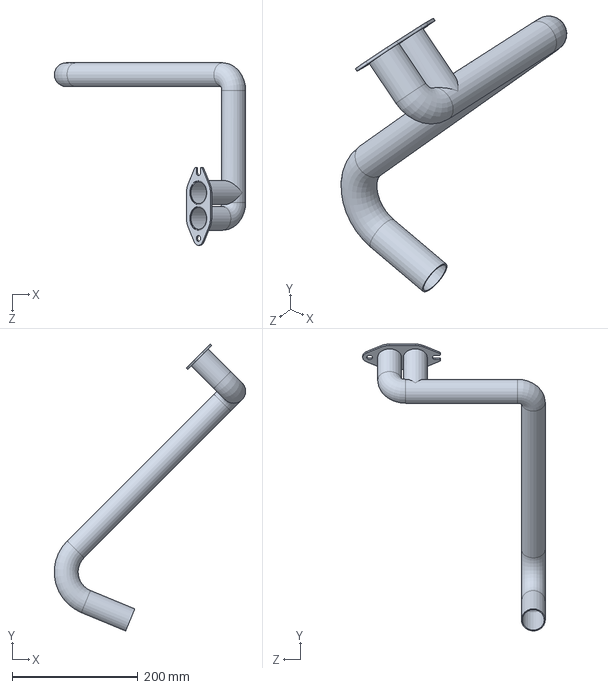
[picture p38: CAD file, 2019-07-24]
Part Files/Intake_Exhaust/DH-IE-M002.SLDPRT
304.4 x 456.5 x 290.4 mm
