trm79/Motorcycle-Engine-Design/Part Files/Powertrain/Piston WB.SLDPRT

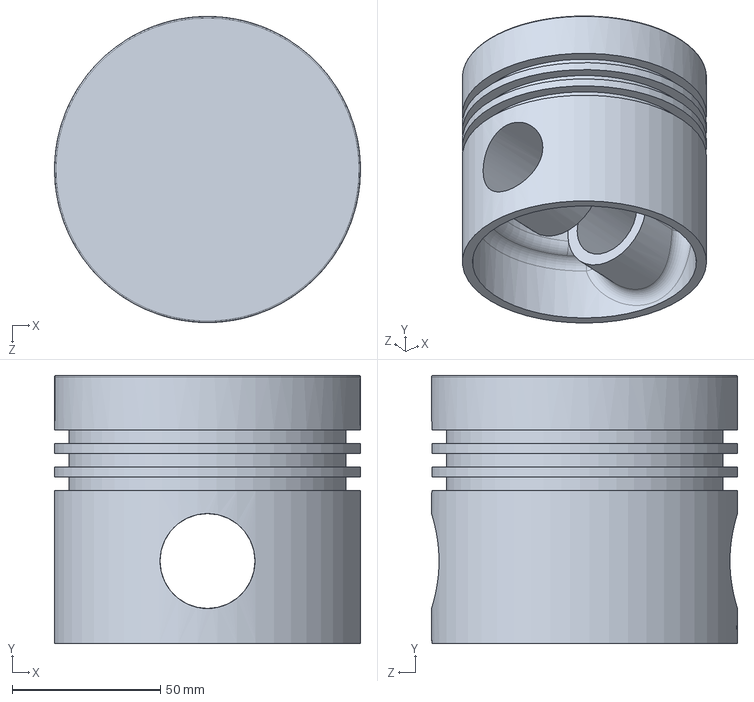
[picture p39: CAD file, 2019-07-24]
Part Files/Powertrain/Piston WB.SLDPRT
103.2 x 90.5 x 103.2 mm
