trm79/Motorcycle-Engine-Design/Part Files/Valvetrain/DH-VT-P005.SLDPRT

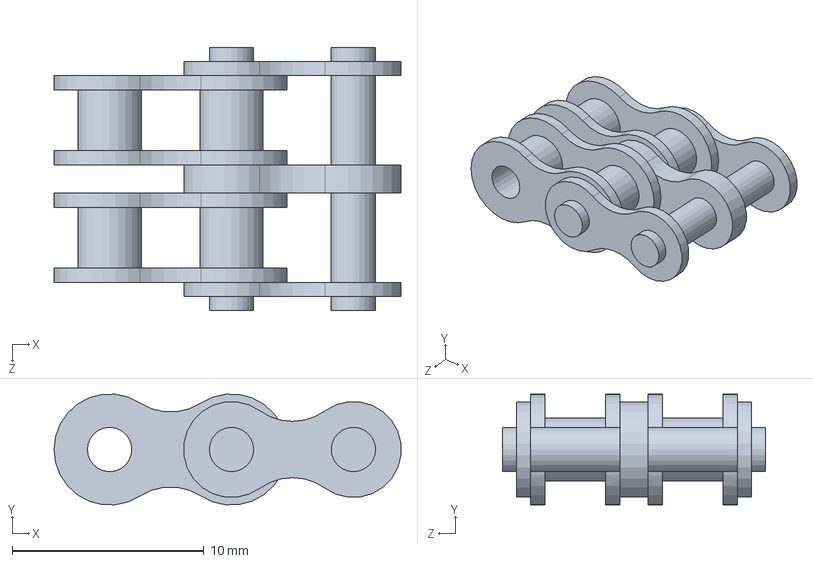
[picture p40: CAD file, 2019-07-24]
Part Files/Valvetrain/DH-VT-P005.SLDPRT
18.1 x 5.76 x 13.7 mm
