trm79/Motorcycle-Engine-Design/Part Files/Intake_Exhaust/DH-IE-P001.SLDPRT

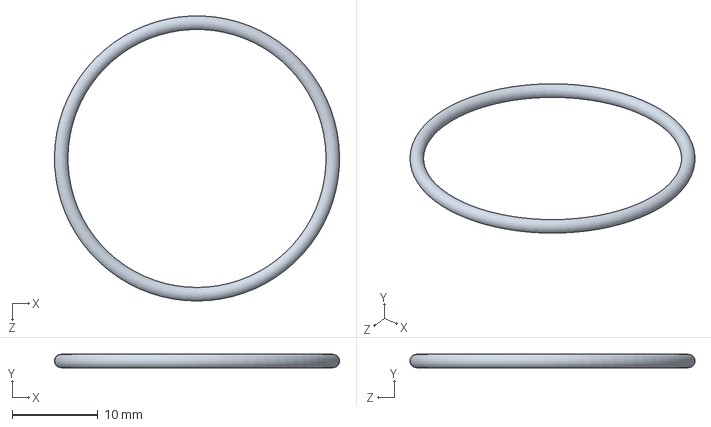
[picture p41: CAD file, 2019-07-24]
Part Files/Intake_Exhaust/DH-IE-P001.SLDPRT
33.3 x 1.59 x 33.3 mm
