trm79/Motorcycle-Engine-Design/Part Files/Valvetrain/DH-VT-M002.SLDPRT

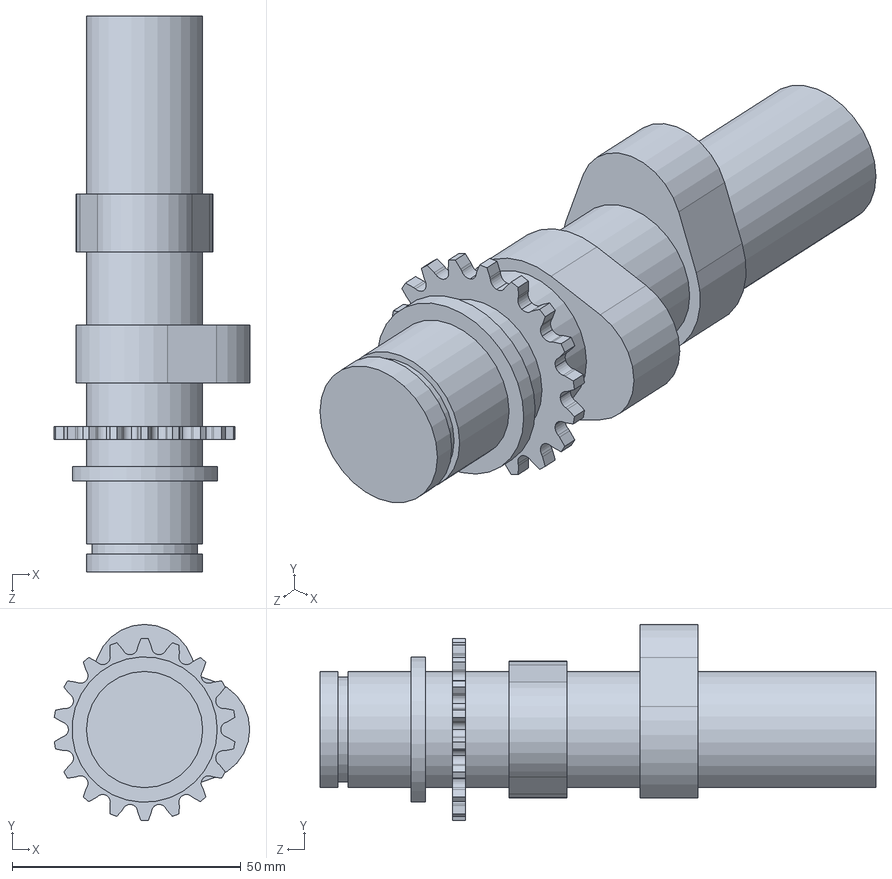
[picture p42: CAD file, 2019-07-24]
Part Files/Valvetrain/DH-VT-M002.SLDPRT
42.7 x 42.9 x 121.4 mm
