trm79/Motorcycle-Engine-Design/Part Files/Engine Block/DH-EB-M012.SLDPRT

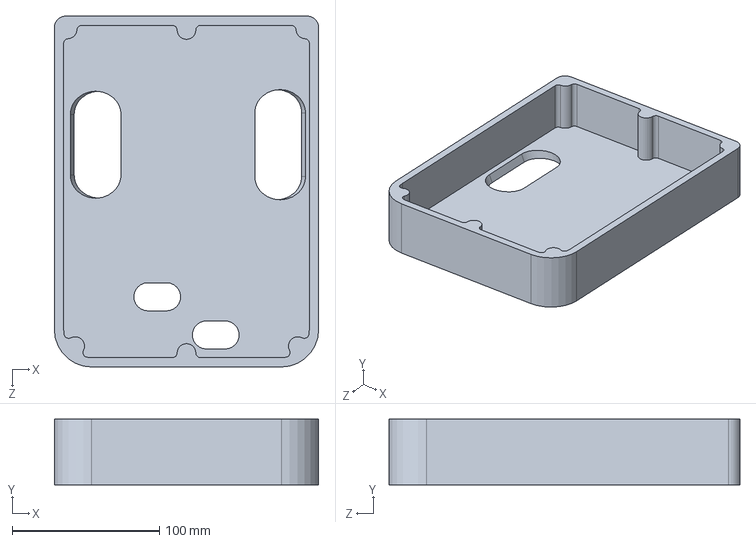
[picture p43: CAD file, 2019-07-24]
Part Files/Engine Block/DH-EB-M012.SLDPRT
179.4 x 44.5 x 238.1 mm
