trm79/Motorcycle-Engine-Design/Part Files/Intake_Exhaust/DH-IE-M002.5.SLDPRT

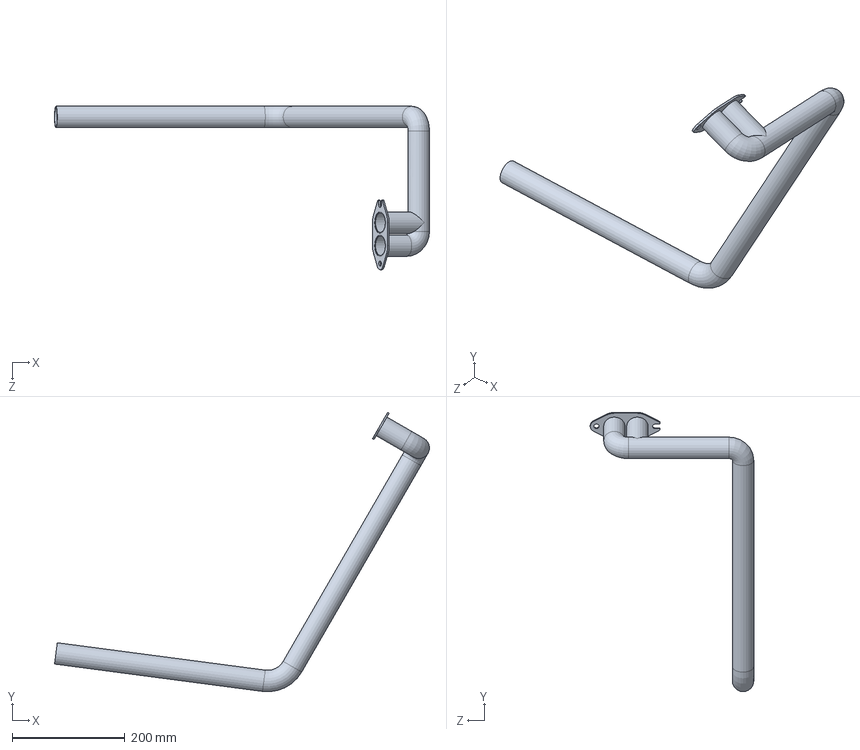
[picture p44: CAD file, 2019-07-24]
Part Files/Intake_Exhaust/DH-IE-M002.5.SLDPRT
665.8 x 495.9 x 290.5 mm
