trm79/Motorcycle-Engine-Design/Part Files/Powertrain/Piston Compression Ring.SLDPRT

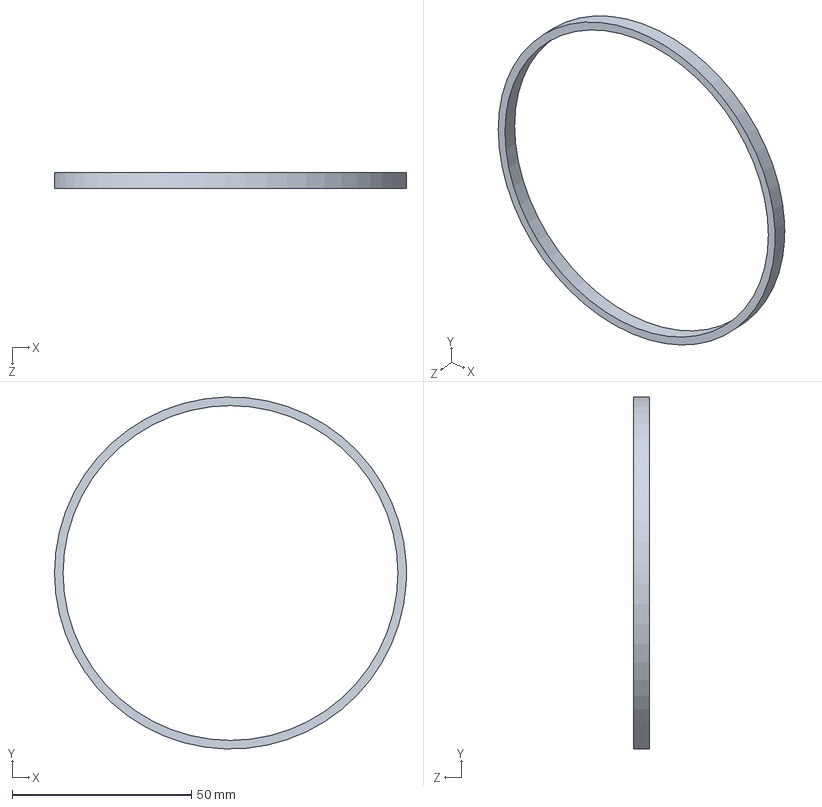
[picture p45: CAD file, 2019-07-24]
Part Files/Powertrain/Piston Compression Ring.SLDPRT
98.2 x 98.1 x 4.39 mm
