trm79/Motorcycle-Engine-Design/Part Files/Valvetrain/Intake Valve.SLDPRT

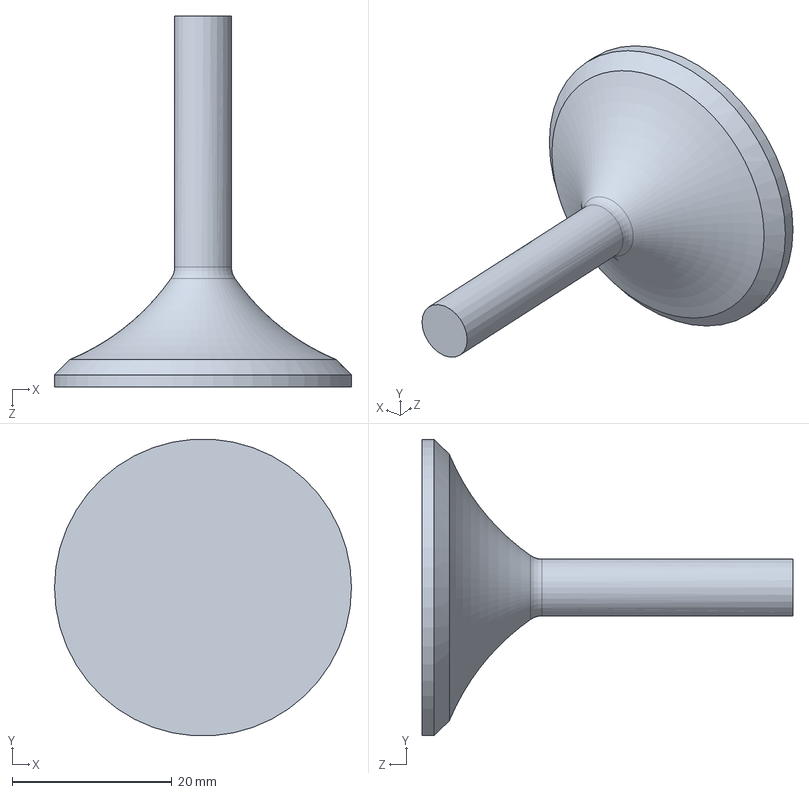
[picture p46: CAD file, 2019-07-24]
Part Files/Valvetrain/Intake Valve.SLDPRT
37.1 x 37.1 x 46.4 mm
