trm79/Motorcycle-Engine-Design/Part Files/Intake_Exhaust/Intake.SLDPRT

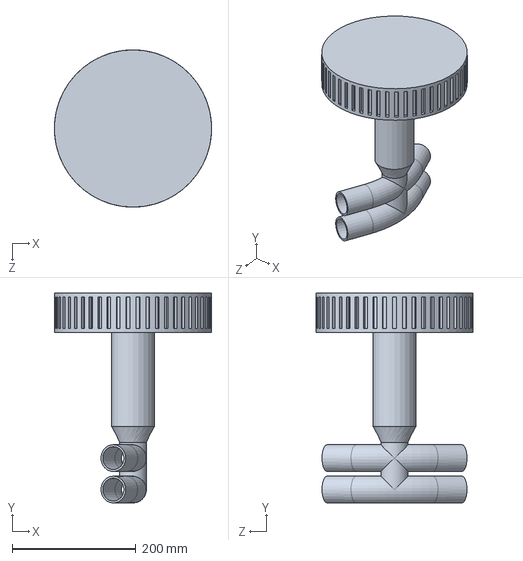
[picture p47: CAD file, 2019-07-24]
Part Files/Intake_Exhaust/Intake.SLDPRT
253.9 x 339.2 x 254.0 mm
