trm79/Motorcycle-Engine-Design/Part Files/Powertrain/DH-LC-P019.SLDPRT

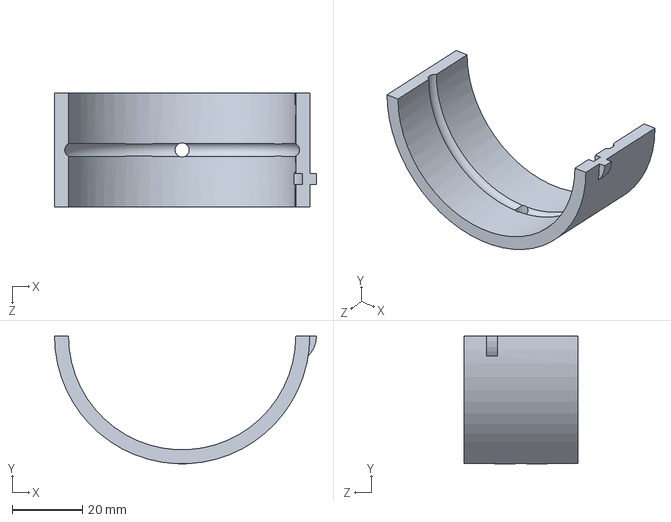
[picture p48: CAD file, 2019-07-24]
Part Files/Powertrain/DH-LC-P019.SLDPRT
74.4 x 36.3 x 32.3 mm
