trm79/Motorcycle-Engine-Design/Part Files/Valvetrain/DH-VT-M009.SLDPRT

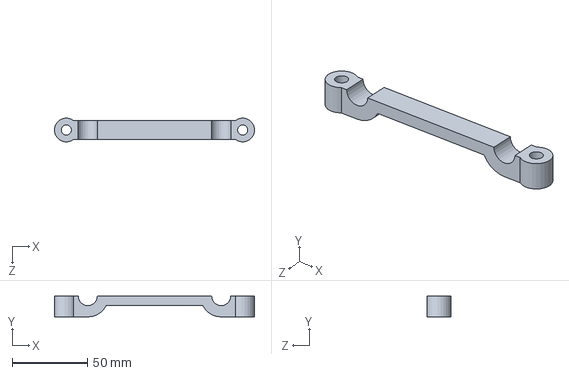
[picture p49: CAD file, 2019-07-24]
Part Files/Valvetrain/DH-VT-M009.SLDPRT
133.2 x 13.9 x 15.8 mm
