trm79/Motorcycle-Engine-Design/Part Files/Engine Block/DH-EB-M022.SLDPRT

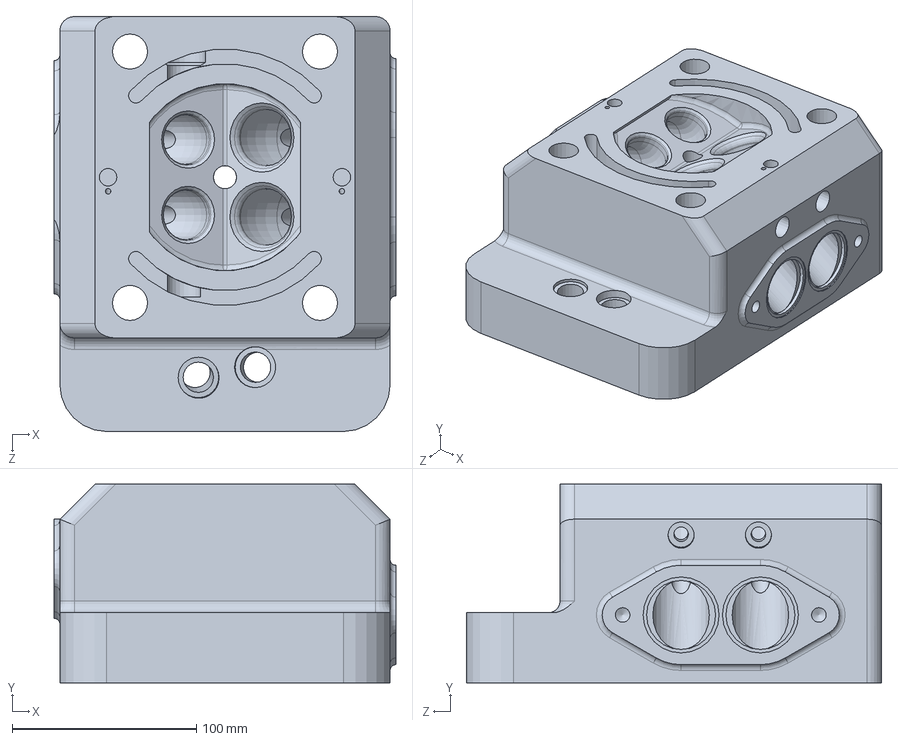
[picture p50: CAD file, 2019-07-24]
Part Files/Engine Block/DH-EB-M022.SLDPRT
185.7 x 108.0 x 225.4 mm
