trm79/Motorcycle-Engine-Design/Part Files/Intake_Exhaust/DH-IE-M001.SLDPRT

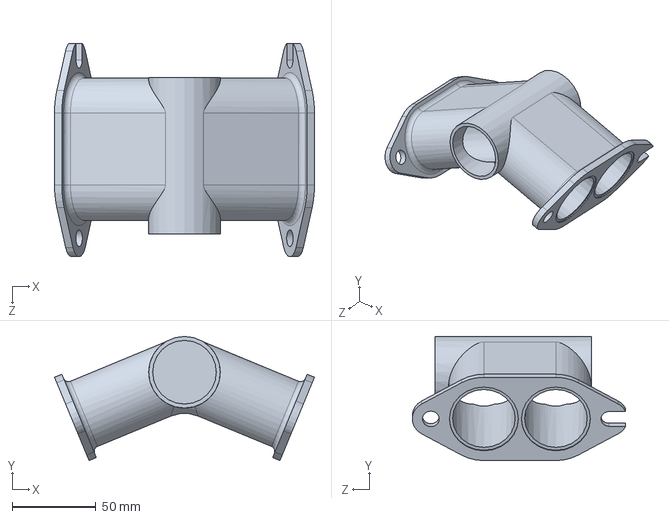
[picture p51: CAD file, 2019-07-24]
Part Files/Intake_Exhaust/DH-IE-M001.SLDPRT
155.6 x 74.3 x 127.7 mm
