trm79/Motorcycle-Engine-Design/Part Files/Powertrain/DH-LC-P028.SLDPRT

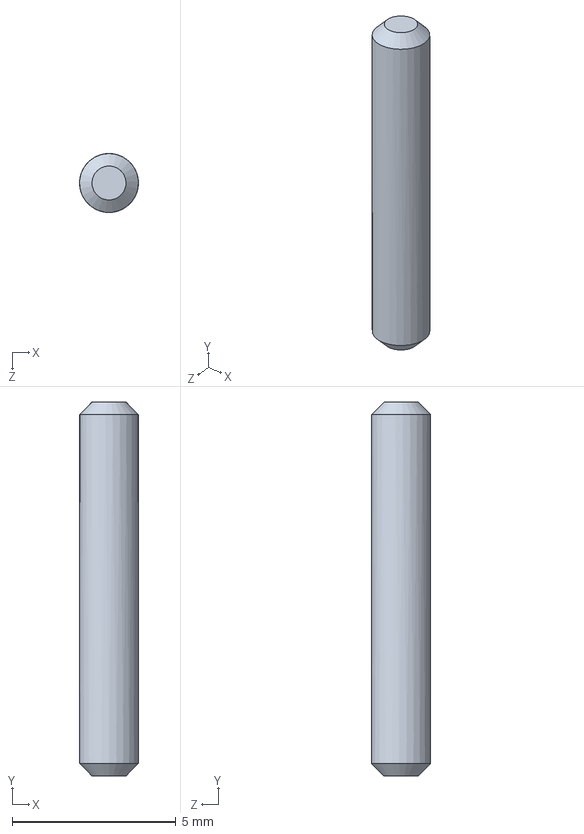
[picture p52: CAD file, 2019-07-24]
Part Files/Powertrain/DH-LC-P028.SLDPRT
1.80 x 11.4 x 1.80 mm
