trm79/Motorcycle-Engine-Design/Part Files/Valvetrain/DH-LC-P022.SLDPRT

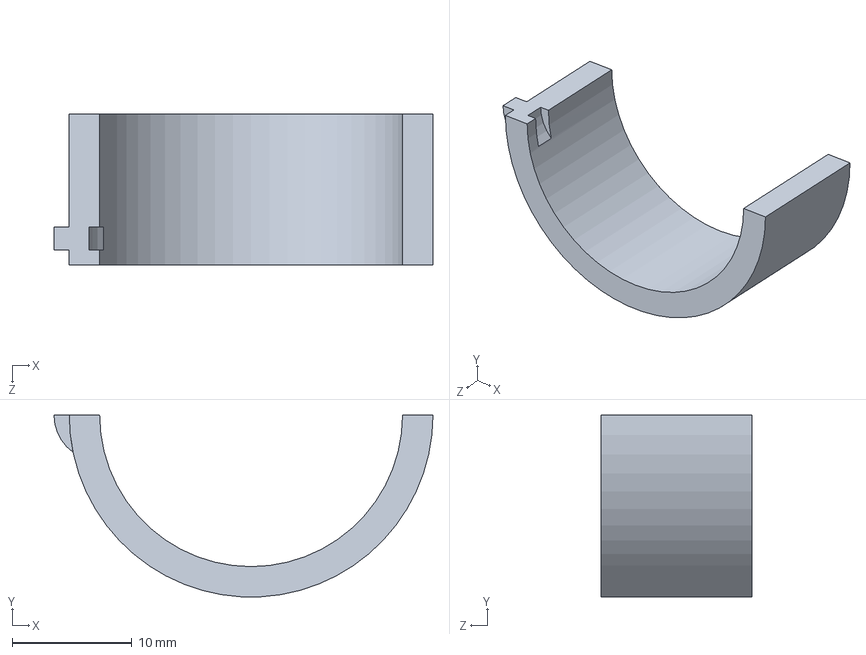
[picture p53: CAD file, 2019-07-24]
Part Files/Valvetrain/DH-LC-P022.SLDPRT
31.6 x 15.1 x 12.6 mm
