trm79/Motorcycle-Engine-Design/Part Files/Engine Block/DH-EB-P002.SLDPRT

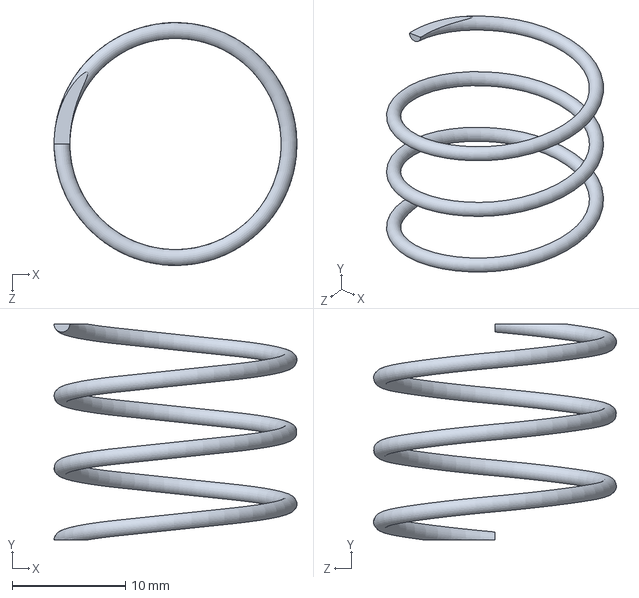
[picture p54: CAD file, 2019-07-24]
Part Files/Engine Block/DH-EB-P002.SLDPRT
21.5 x 19.1 x 21.5 mm
