trm79/Motorcycle-Engine-Design/Part Files/Powertrain/DH-PT-M011.SLDPRT

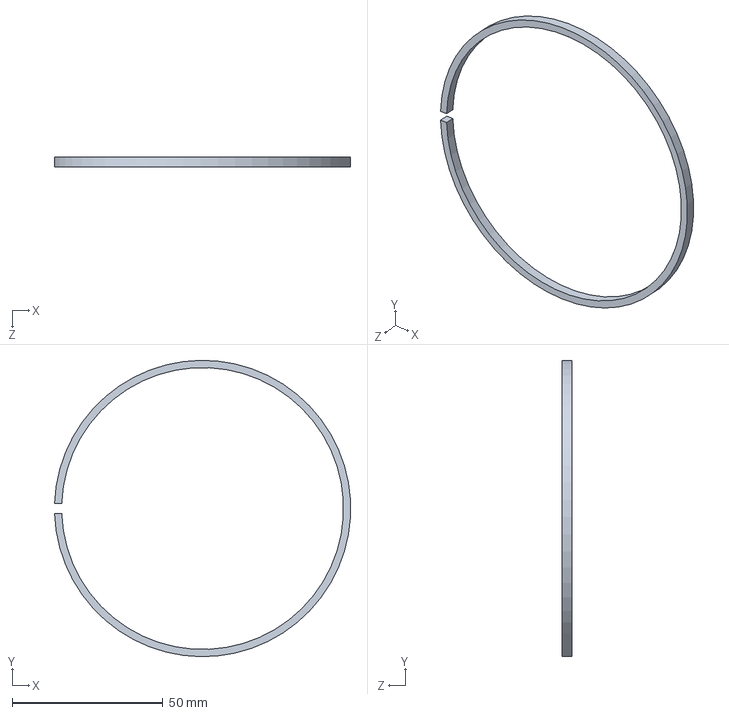
[picture p55: CAD file, 2019-07-24]
Part Files/Powertrain/DH-PT-M011.SLDPRT
98.1 x 98.2 x 3.17 mm
