trm79/Motorcycle-Engine-Design/Part Files/Engine Block/DH-EB-M016.SLDPRT

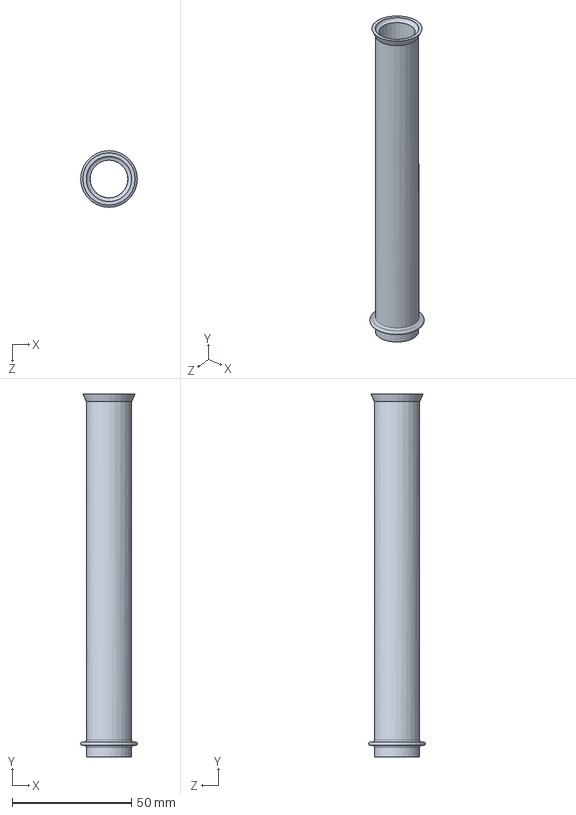
[picture p56: CAD file, 2019-07-24]
Part Files/Engine Block/DH-EB-M016.SLDPRT
23.8 x 152.4 x 23.8 mm
