trm79/Motorcycle-Engine-Design/Part Files/Powertrain/DH-PT-M005.SLDPRT

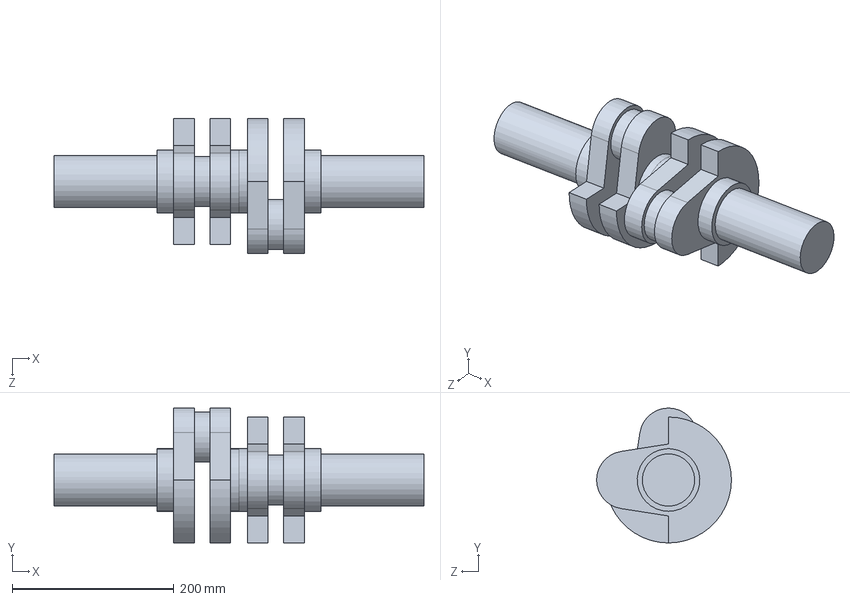
[picture p57: CAD file, 2019-07-24]
Part Files/Powertrain/DH-PT-M005.SLDPRT
457.2 x 166.7 x 166.7 mm
