trm79/Motorcycle-Engine-Design/Part Files/Engine Block/DH-EB-M005.SLDPRT

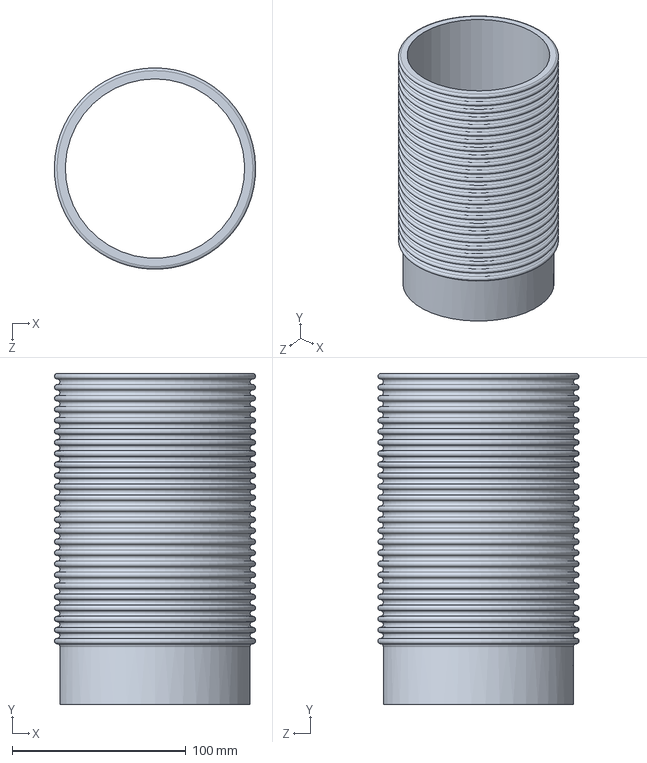
[picture p58: CAD file, 2019-07-24]
Part Files/Engine Block/DH-EB-M005.SLDPRT
115.8 x 190.5 x 115.8 mm
