trm79/Motorcycle-Engine-Design/Part Files/Powertrain/DH-PT-M006.SLDPRT

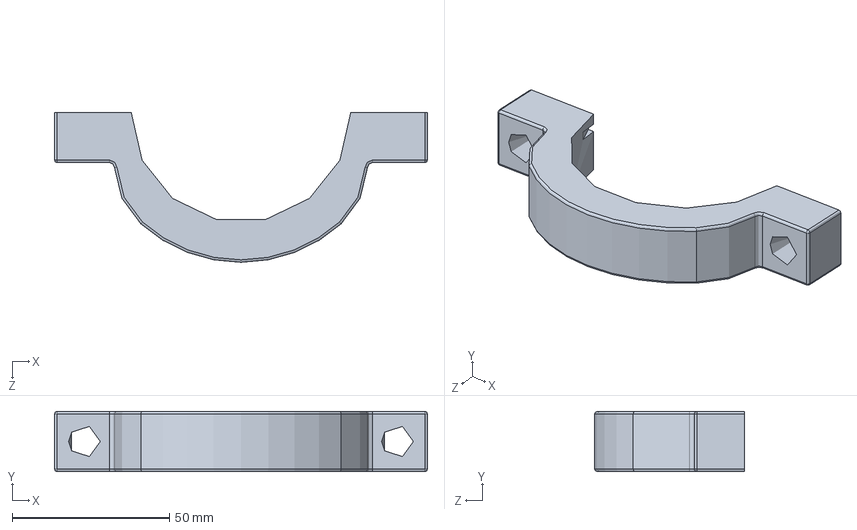
[picture p59: CAD file, 2019-07-24]
Part Files/Powertrain/DH-PT-M006.SLDPRT
118.6 x 19.1 x 47.6 mm
