trm79/Motorcycle-Engine-Design/Part Files/Valvetrain/DH-VT-M010.SLDPRT

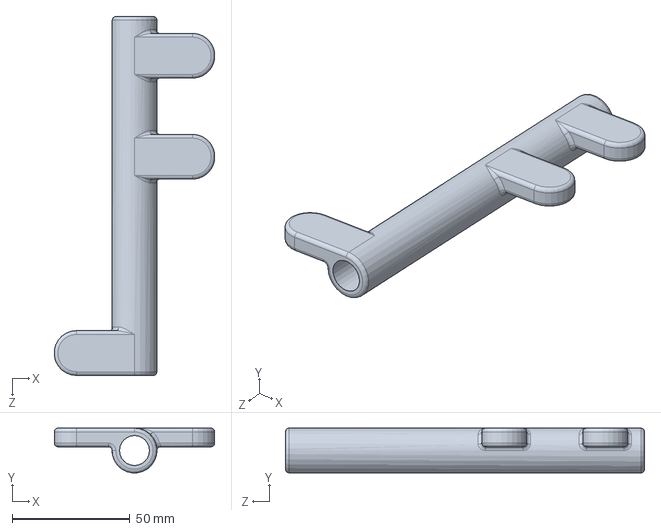
[picture p60: CAD file, 2019-07-24]
Part Files/Valvetrain/DH-VT-M010.SLDPRT
68.1 x 19.0 x 152.4 mm
