trm79/Motorcycle-Engine-Design/Part Files/Engine Block/DH-EB-M007.SLDPRT

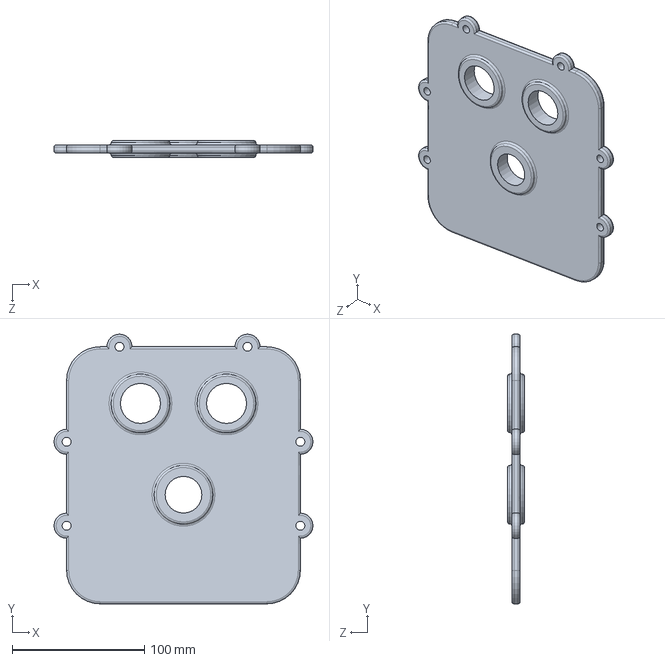
[picture p61: CAD file, 2019-07-24]
Part Files/Engine Block/DH-EB-M007.SLDPRT
195.9 x 204.0 x 12.7 mm
