trm79/Motorcycle-Engine-Design/Part Files/Intake_Exhaust/DH-IE-P002.SLDPRT

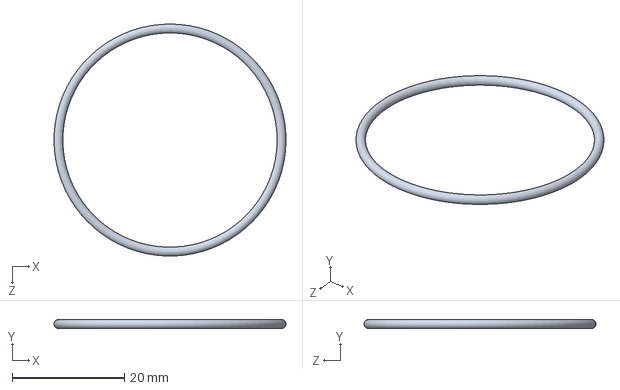
[picture p62: CAD file, 2019-07-24]
Part Files/Intake_Exhaust/DH-IE-P002.SLDPRT
41.3 x 1.59 x 41.3 mm
