trm79/Motorcycle-Engine-Design/Part Files/Powertrain/DH-PT-M007.SLDPRT

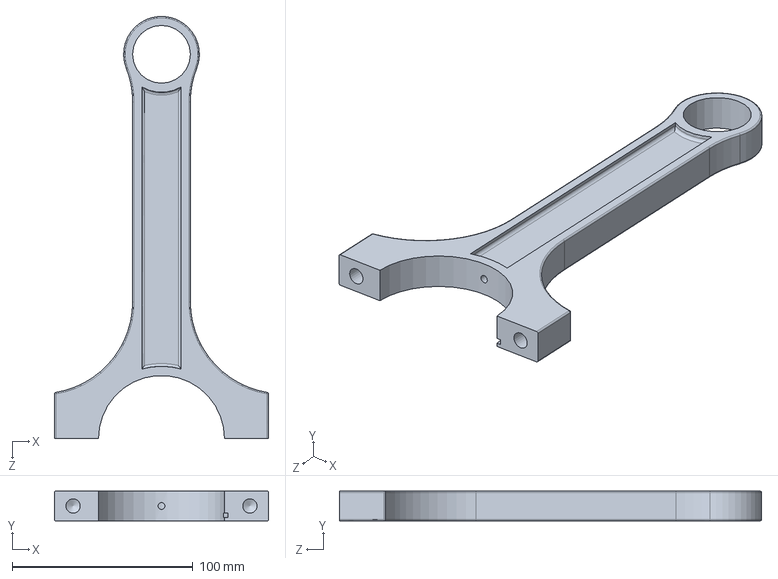
[picture p63: CAD file, 2019-07-24]
Part Files/Powertrain/DH-PT-M007.SLDPRT
118.6 x 16.5 x 233.7 mm
