trm79/Motorcycle-Engine-Design/Part Files/Engine Block/DH-EB-M004.SLDPRT

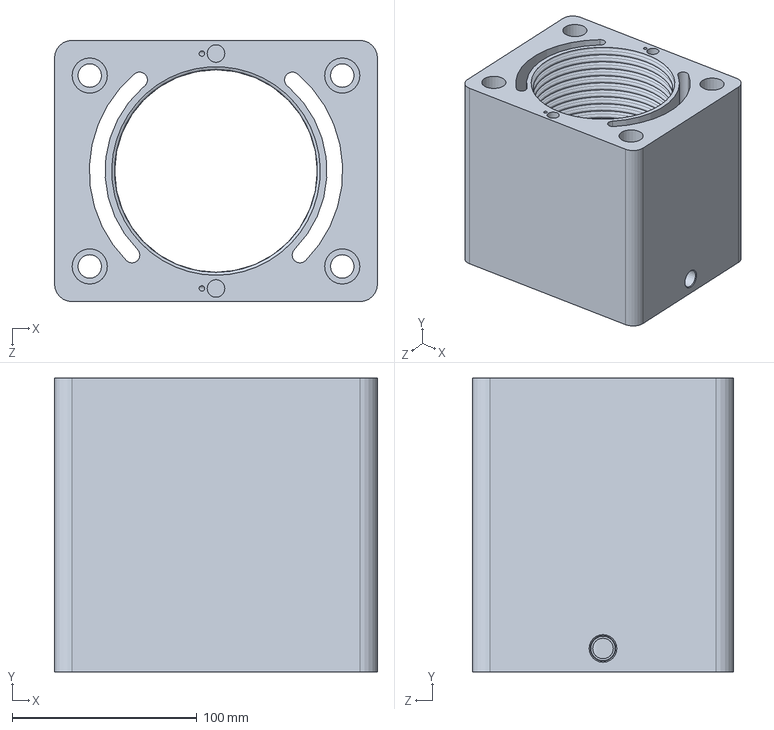
[picture p64: CAD file, 2019-07-24]
Part Files/Engine Block/DH-EB-M004.SLDPRT
174.6 x 158.9 x 141.3 mm
