trm79/Motorcycle-Engine-Design/Part Files/Powertrain/DH-LC-P020.SLDPRT

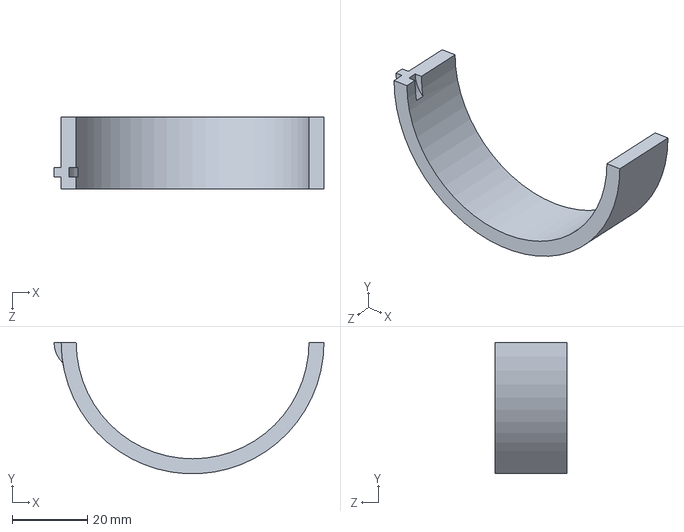
[picture p65: CAD file, 2019-07-24]
Part Files/Powertrain/DH-LC-P020.SLDPRT
71.7 x 34.8 x 19.1 mm
