trm79/Motorcycle-Engine-Design/Part Files/Valvetrain/Camshaft.SLDPRT

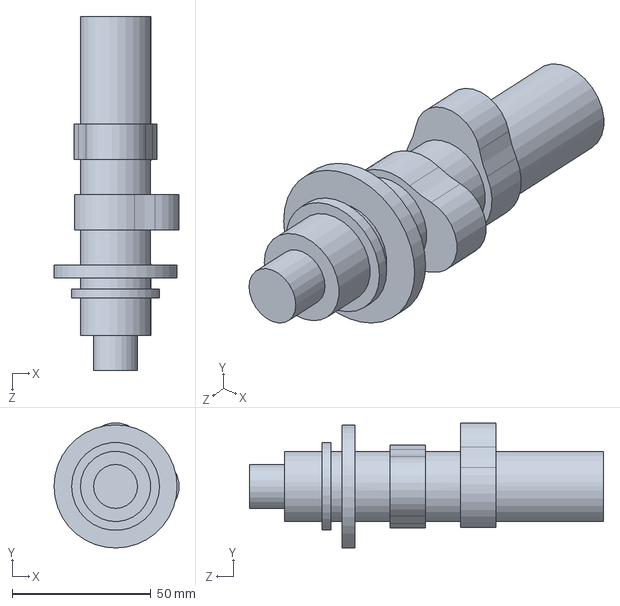
[picture p66: CAD file, 2019-07-24]
Part Files/Valvetrain/Camshaft.SLDPRT
45.1 x 45.1 x 127.8 mm
