trm79/Motorcycle-Engine-Design/Part Files/Engine Block/DH-EB-P007.SLDPRT

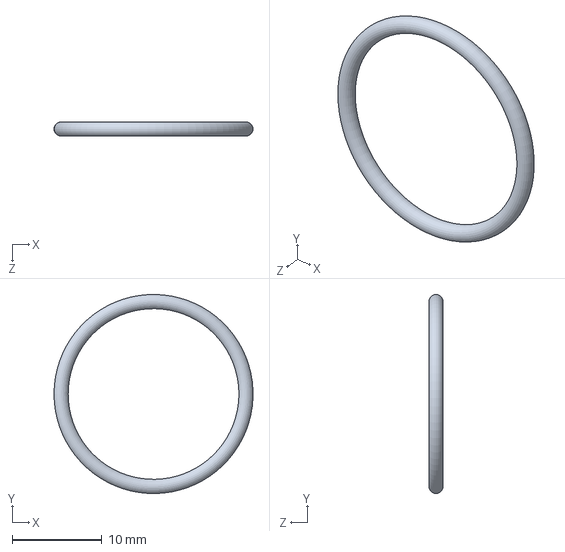
[picture p67: CAD file, 2019-07-24]
Part Files/Engine Block/DH-EB-P007.SLDPRT
22.2 x 22.2 x 1.59 mm
