trm79/Motorcycle-Engine-Design/Part Files/Powertrain/DH-PT-M008.SLDPRT

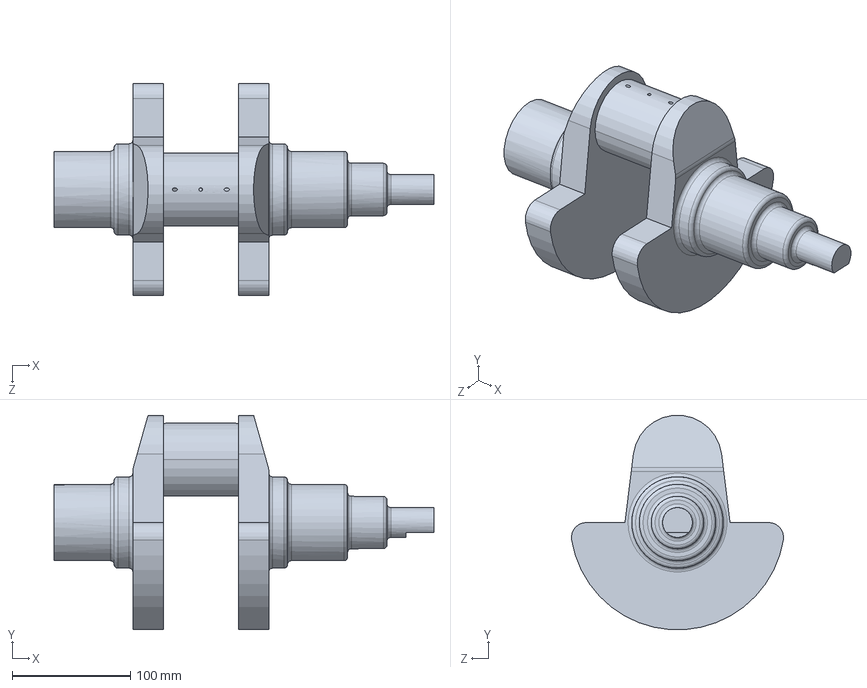
[picture p68: CAD file, 2019-07-24]
Part Files/Powertrain/DH-PT-M008.SLDPRT
321.5 x 181.1 x 179.4 mm
