trm79/Motorcycle-Engine-Design/Part Files/Valvetrain/Exhaust Valve.SLDPRT

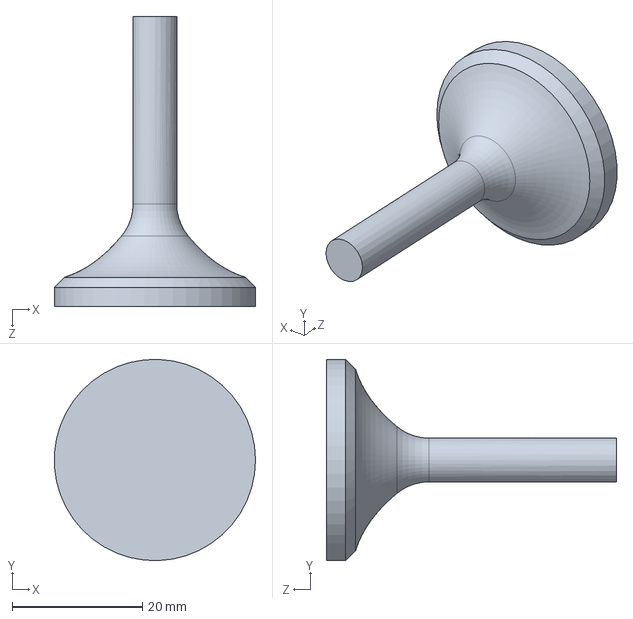
[picture p69: CAD file, 2019-07-24]
Part Files/Valvetrain/Exhaust Valve.SLDPRT
30.9 x 30.9 x 44.6 mm
