trm79/Motorcycle-Engine-Design/Part Files/Engine Block/DH-EB-M008.SLDPRT

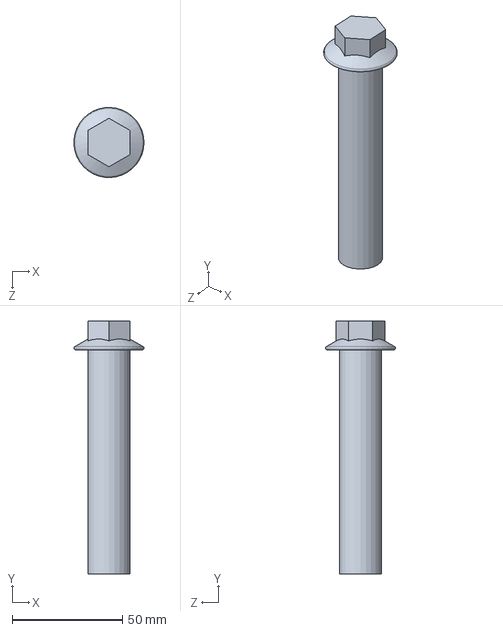
[picture p70: CAD file, 2019-07-24]
Part Files/Engine Block/DH-EB-M008.SLDPRT
31.7 x 114.7 x 31.8 mm
