trm79/Motorcycle-Engine-Design/Part Files/Powertrain/DH-LC-P025.SLDPRT

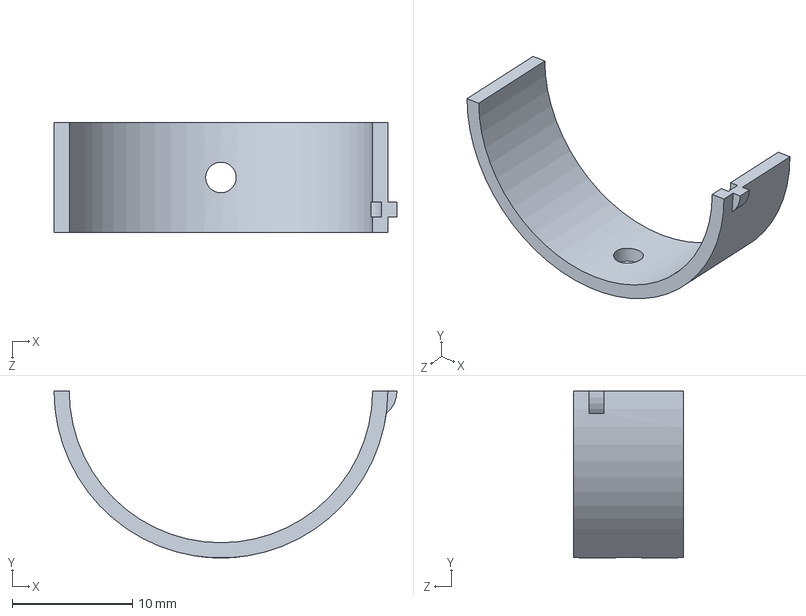
[picture p71: CAD file, 2019-07-24]
Part Files/Powertrain/DH-LC-P025.SLDPRT
28.5 x 13.9 x 9.14 mm
