trm79/Motorcycle-Engine-Design/Part Files/Valvetrain/DH-VT-M015.SLDPRT

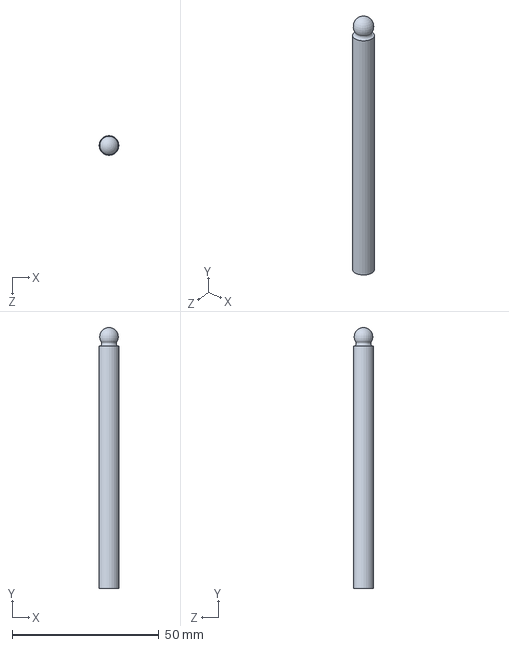
[picture p72: CAD file, 2019-07-24]
Part Files/Valvetrain/DH-VT-M015.SLDPRT
6.73 x 88.9 x 6.73 mm
