trm79/Motorcycle-Engine-Design/Part Files/Valvetrain/DH-VT-P006.SLDPRT

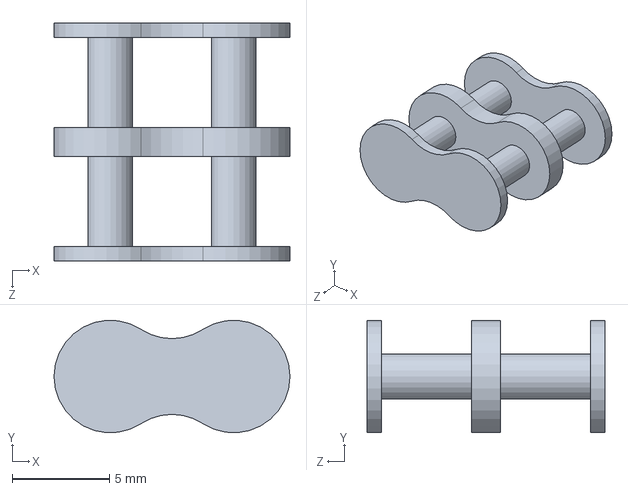
[picture p73: CAD file, 2019-07-24]
Part Files/Valvetrain/DH-VT-P006.SLDPRT
12.1 x 5.78 x 12.2 mm
