trm79/Motorcycle-Engine-Design/Part Files/Engine Block/DH-EB-P006.SLDPRT

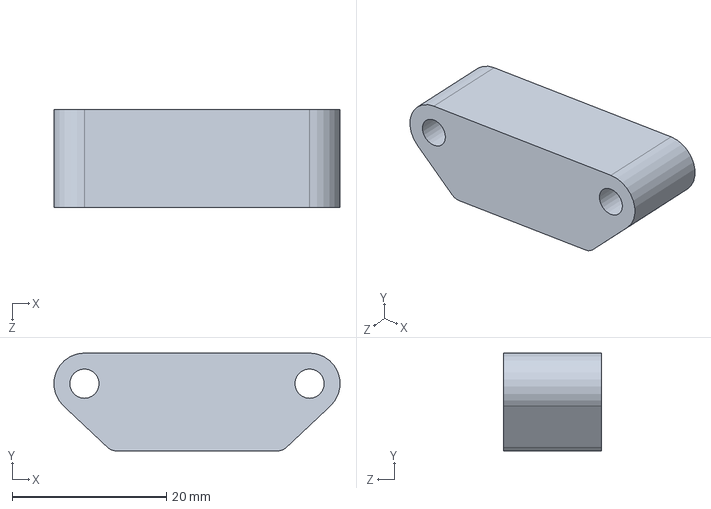
[picture p74: CAD file, 2019-07-24]
Part Files/Engine Block/DH-EB-P006.SLDPRT
37.1 x 12.7 x 12.7 mm
