trm79/Motorcycle-Engine-Design/Part Files/Powertrain/DH - PT - M001.SLDPRT

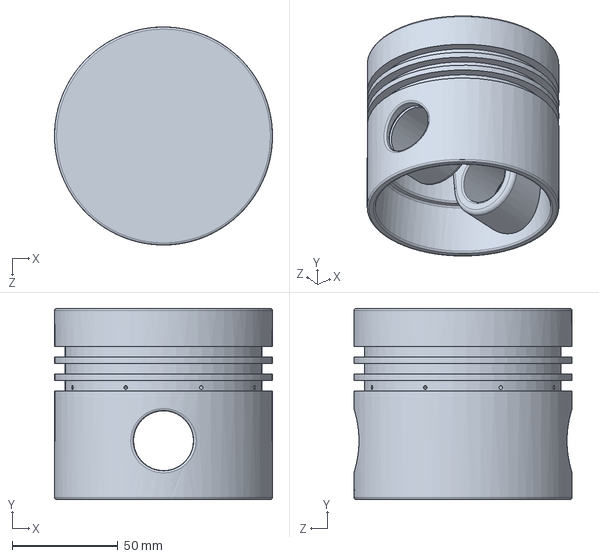
[picture p75: CAD file, 2019-07-24]
Part Files/Powertrain/DH - PT - M001.SLDPRT
103.2 x 90.5 x 103.2 mm
