trm79/Motorcycle-Engine-Design/Part Files/Valvetrain/DH-VT-M011.SLDPRT

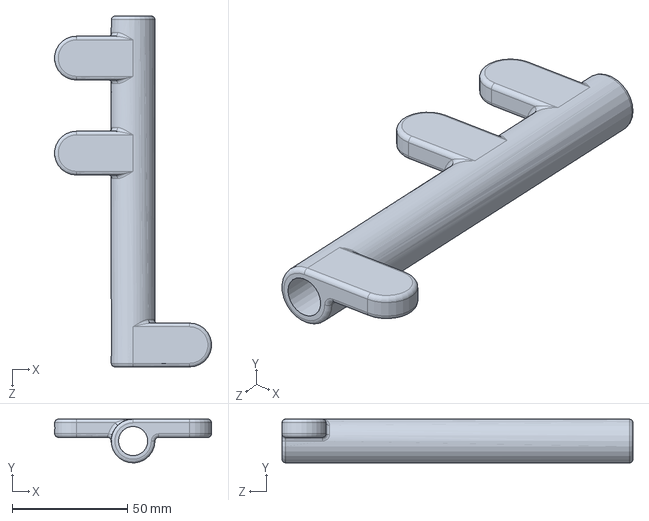
[picture p76: CAD file, 2019-07-24]
Part Files/Valvetrain/DH-VT-M011.SLDPRT
68.2 x 19.0 x 152.4 mm
