trm79/Motorcycle-Engine-Design/Part Files/Engine Block/DH-EB-M003.sldprt

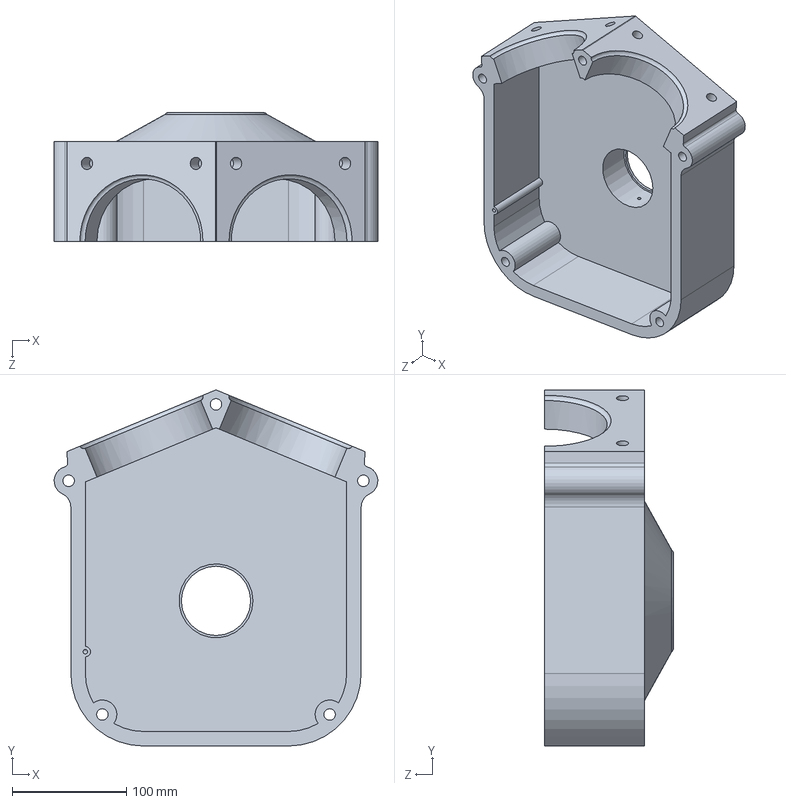
[picture p77: CAD file, 2019-07-24]
Part Files/Engine Block/DH-EB-M003.sldprt
283.1 x 311.5 x 112.7 mm
