trm79/Motorcycle-Engine-Design/Part Files/Valvetrain/DH-VT-P003.SLDPRT

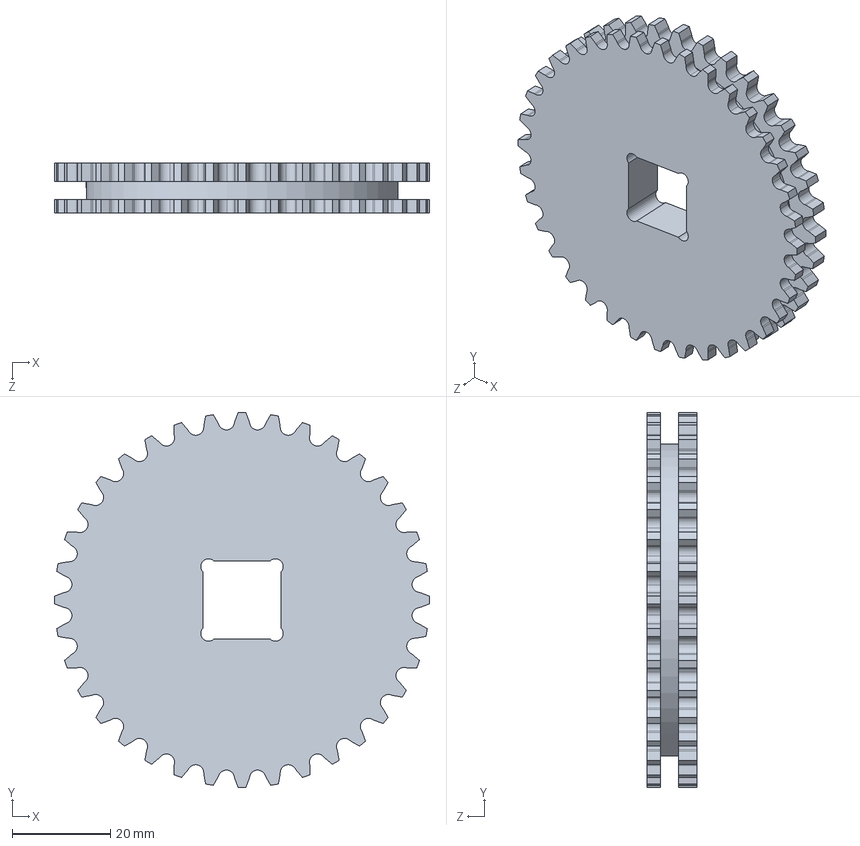
[picture p78: CAD file, 2019-07-24]
Part Files/Valvetrain/DH-VT-P003.SLDPRT
76.4 x 76.4 x 10.1 mm
