trm79/Motorcycle-Engine-Design/Part Files/Engine Block/DH-EB-M021.SLDPRT

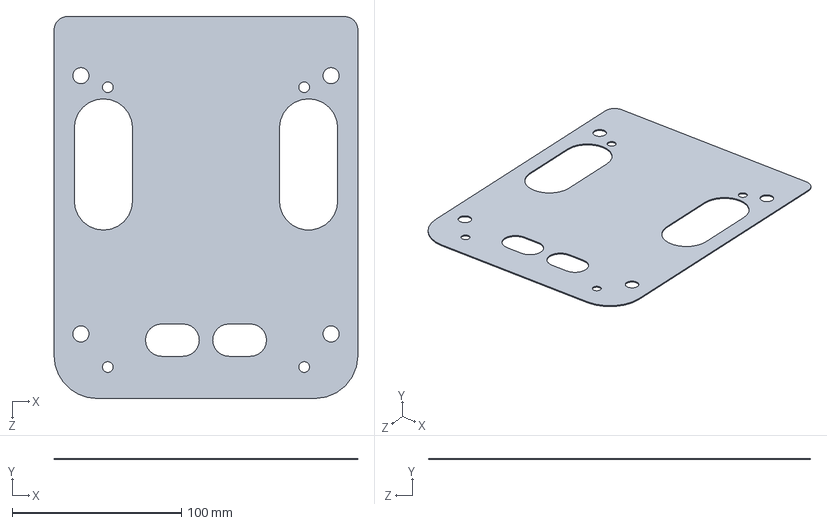
[picture p79: CAD file, 2019-07-24]
Part Files/Engine Block/DH-EB-M021.SLDPRT
179.4 x 0.794 x 225.4 mm
