trm79/Motorcycle-Engine-Design/Part Files/Powertrain/DH-PT-M004.SLDPRT

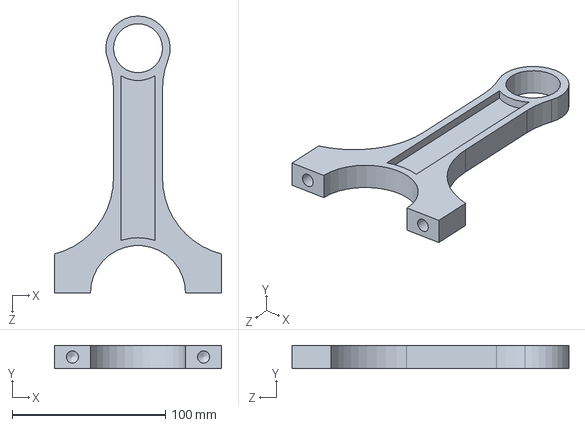
[picture p80: CAD file, 2019-07-24]
Part Files/Powertrain/DH-PT-M004.SLDPRT
109.1 x 15.0 x 180.5 mm
