trm79/Motorcycle-Engine-Design/Part Files/Valvetrain/DH-VT-M013.SLDPRT

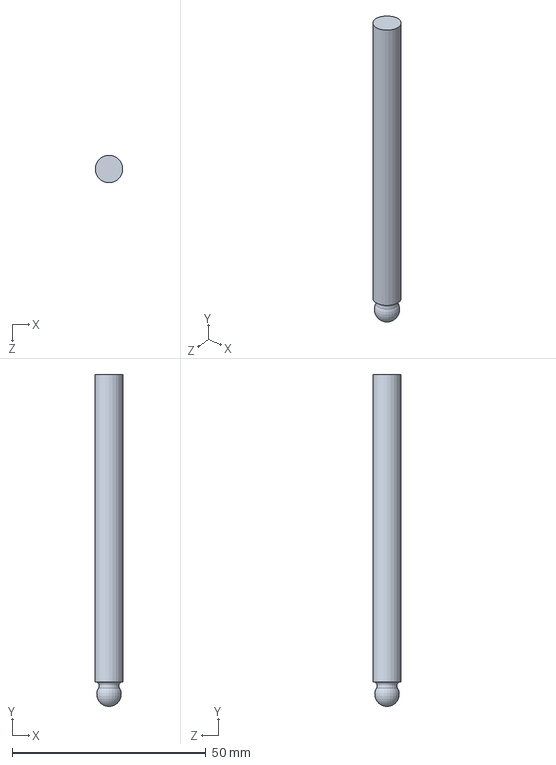
[picture p81: CAD file, 2019-07-24]
Part Files/Valvetrain/DH-VT-M013.SLDPRT
7.11 x 85.7 x 7.11 mm
