trm79/Motorcycle-Engine-Design/Part Files/Engine Block/DH-EB-M023.SLDPRT

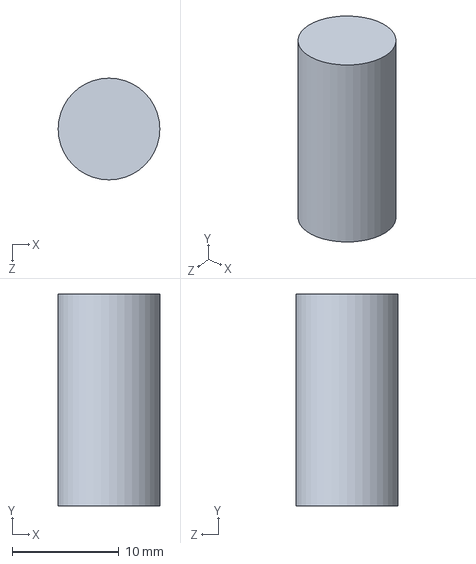
[picture p82: CAD file, 2019-07-24]
Part Files/Engine Block/DH-EB-M023.SLDPRT
9.53 x 19.8 x 9.53 mm
