trm79/Motorcycle-Engine-Design/Part Files/Powertrain/DH-PT-M010.SLDPRT

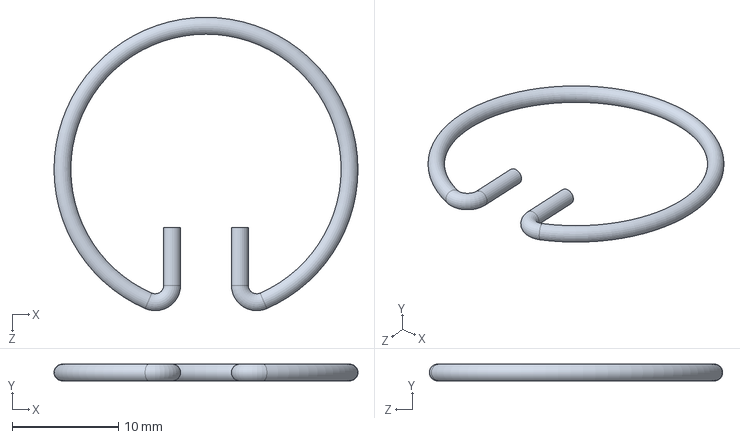
[picture p83: CAD file, 2019-07-24]
Part Files/Powertrain/DH-PT-M010.SLDPRT
28.5 x 1.59 x 27.6 mm
