trm79/Motorcycle-Engine-Design/Part Files/Valvetrain/DH-VT-M001.SLDPRT

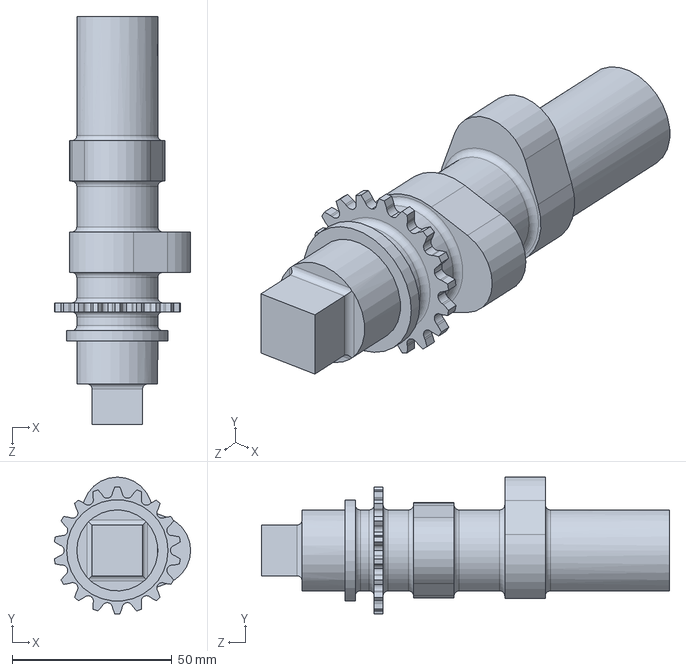
[picture p84: CAD file, 2019-07-24]
Part Files/Valvetrain/DH-VT-M001.SLDPRT
42.7 x 42.9 x 127.8 mm
