trm79/Motorcycle-Engine-Design/Part Files/Powertrain/DH-LC-P018.SLDPRT

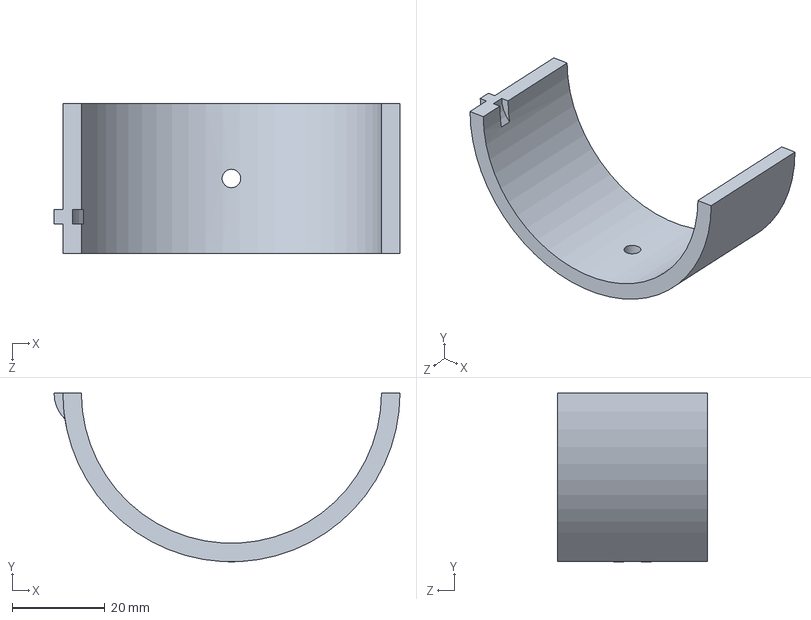
[picture p85: CAD file, 2019-07-24]
Part Files/Powertrain/DH-LC-P018.SLDPRT
74.4 x 36.3 x 32.3 mm
