trm79/Motorcycle-Engine-Design/Part Files/Valvetrain/DH-VT-M018.SLDPRT

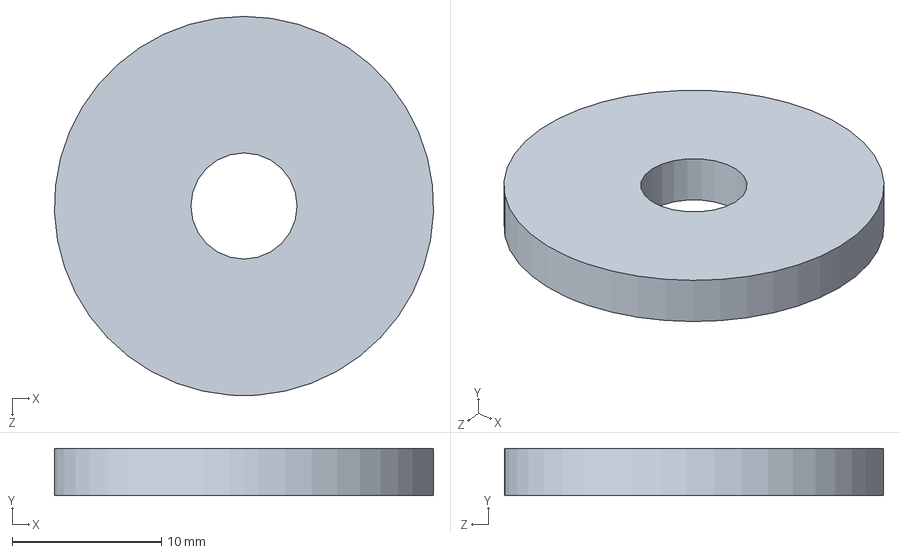
[picture p86: CAD file, 2019-07-24]
Part Files/Valvetrain/DH-VT-M018.SLDPRT
25.4 x 3.17 x 25.4 mm
