trm79/Motorcycle-Engine-Design/Part Files/Engine Block/DH-EB-M018.SLDPRT

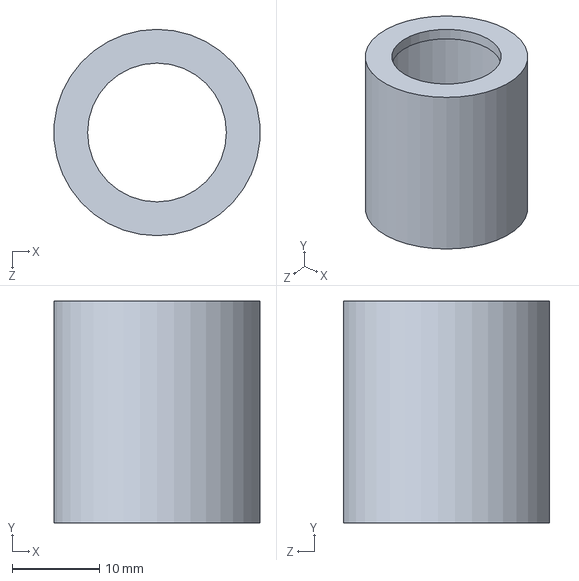
[picture p87: CAD file, 2019-07-24]
Part Files/Engine Block/DH-EB-M018.SLDPRT
23.5 x 25.4 x 23.6 mm
