trm79/Motorcycle-Engine-Design/Part Files/Valvetrain/DH-VT-P002.SLDPRT

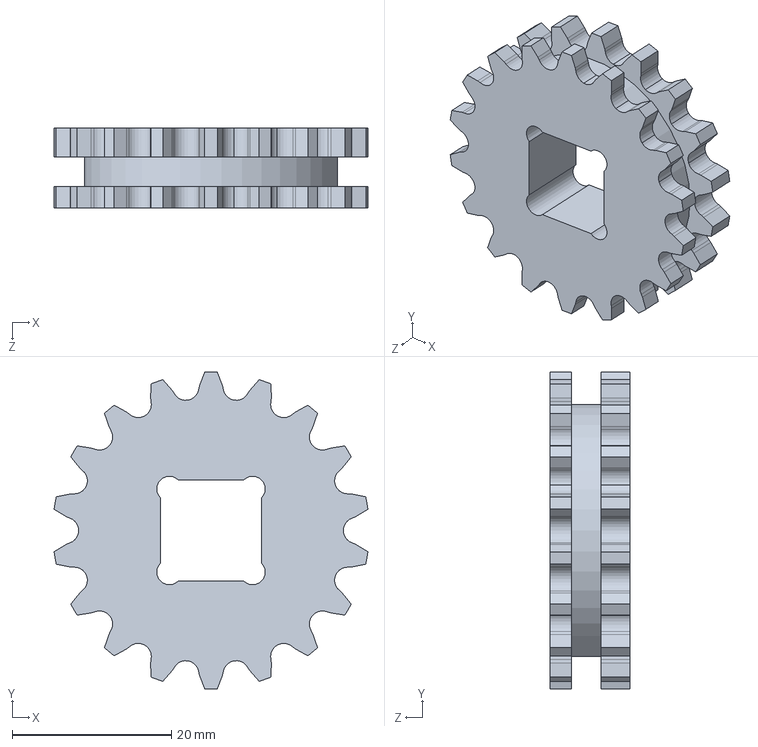
[picture p88: CAD file, 2019-07-24]
Part Files/Valvetrain/DH-VT-P002.SLDPRT
39.5 x 39.8 x 10.1 mm
