trm79/Motorcycle-Engine-Design/Part Files/Engine Block/DH-EB-M017.SLDPRT

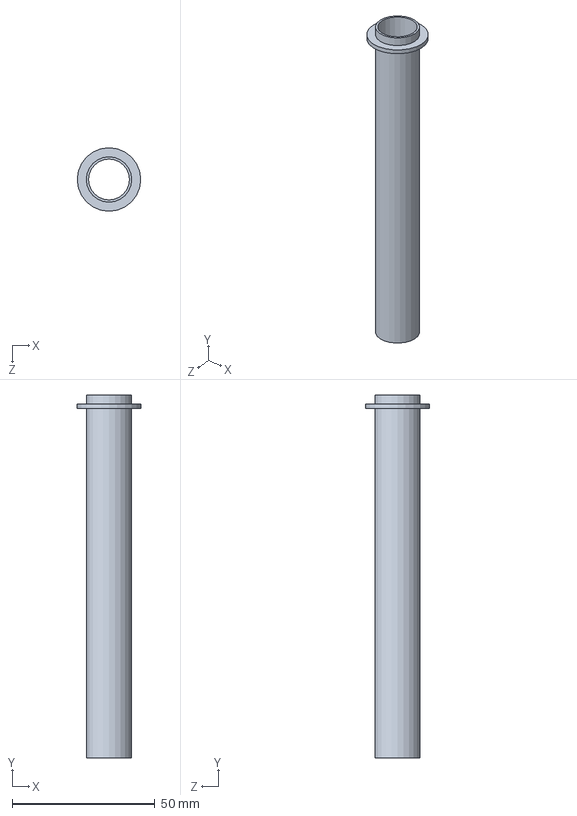
[picture p89: CAD file, 2019-07-24]
Part Files/Engine Block/DH-EB-M017.SLDPRT
22.2 x 127.0 x 22.2 mm
