trm79/Motorcycle-Engine-Design/Part Files/Powertrain/DH-LC-P021.SLDPRT

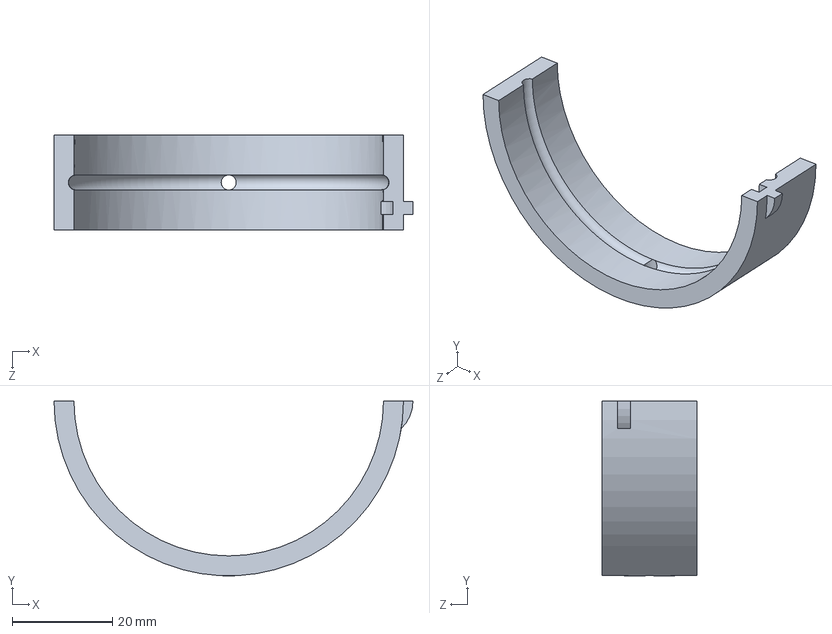
[picture p90: CAD file, 2019-07-24]
Part Files/Powertrain/DH-LC-P021.SLDPRT
71.7 x 34.9 x 19.1 mm
