trm79/Motorcycle-Engine-Design/Part Files/Engine Block/DH-EB-M014.SLDPRT

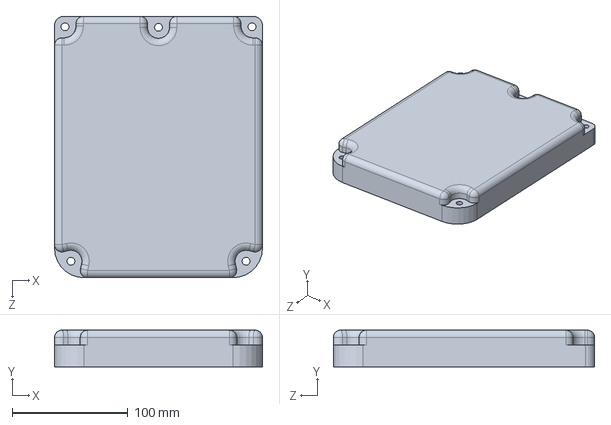
[picture p91: CAD file, 2019-07-24]
Part Files/Engine Block/DH-EB-M014.SLDPRT
179.4 x 31.8 x 225.4 mm
