trm79/Motorcycle-Engine-Design/Part Files/Powertrain/DH-PT-M009.SLDPRT

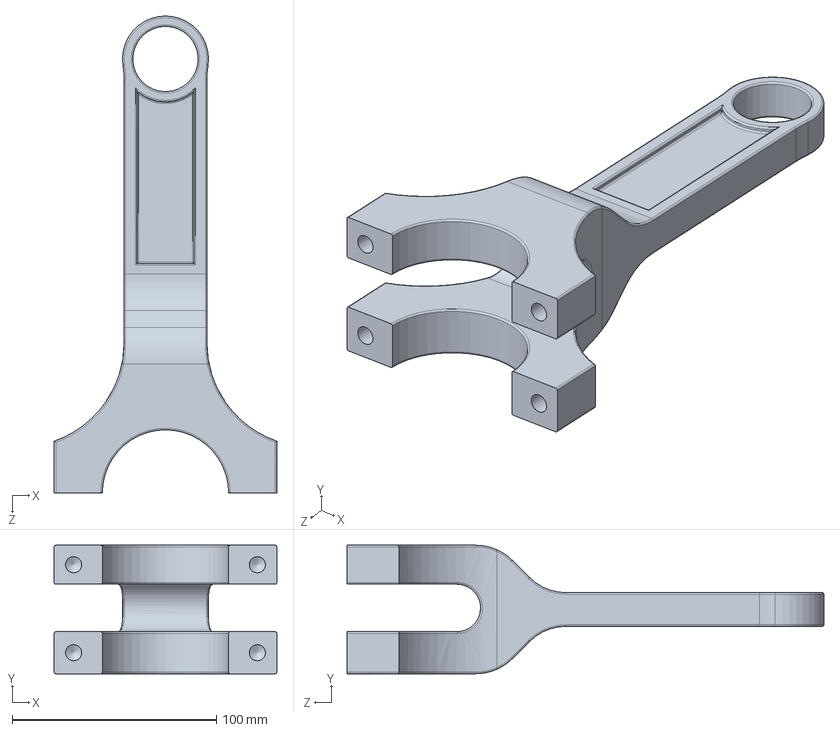
[picture p92: CAD file, 2019-07-24]
Part Files/Powertrain/DH-PT-M009.SLDPRT
109.1 x 63.0 x 233.8 mm
