trm79/Motorcycle-Engine-Design/Part Files/Valvetrain/DH-VT-M019.SLDPRT

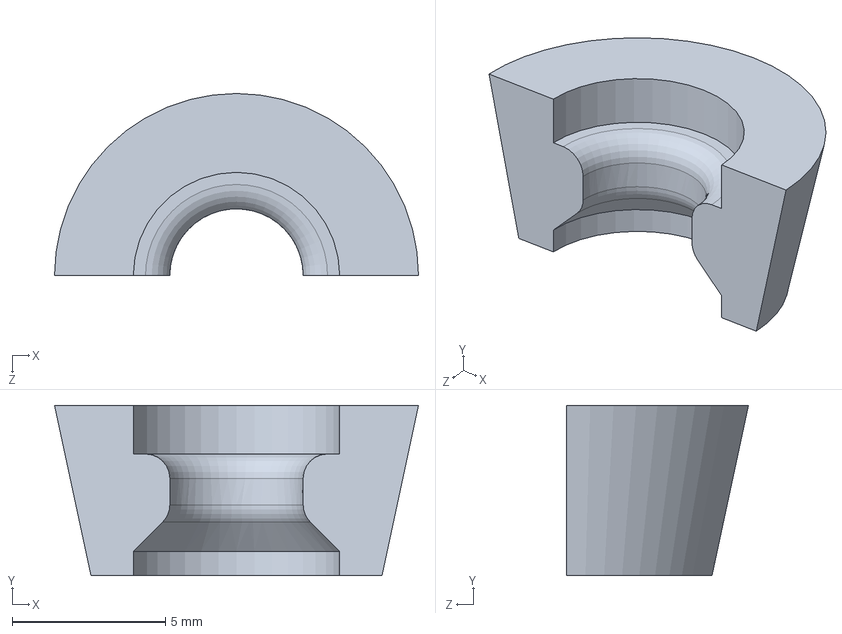
[picture p93: CAD file, 2019-07-24]
Part Files/Valvetrain/DH-VT-M019.SLDPRT
11.9 x 5.56 x 5.94 mm
