trm79/Motorcycle-Engine-Design/Part Files/Powertrain/DH-PT-M002.SLDPRT

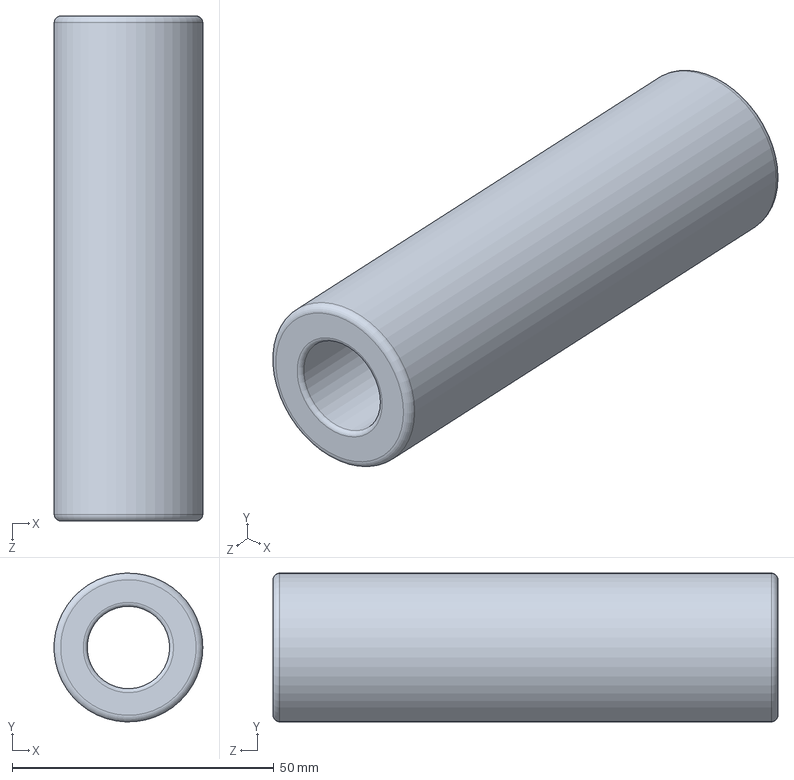
[picture p94: CAD file, 2019-07-24]
Part Files/Powertrain/DH-PT-M002.SLDPRT
28.4 x 28.4 x 96.5 mm
