trm79/Motorcycle-Engine-Design/Part Files/Engine Block/DH-EB-M011.SLDPRT

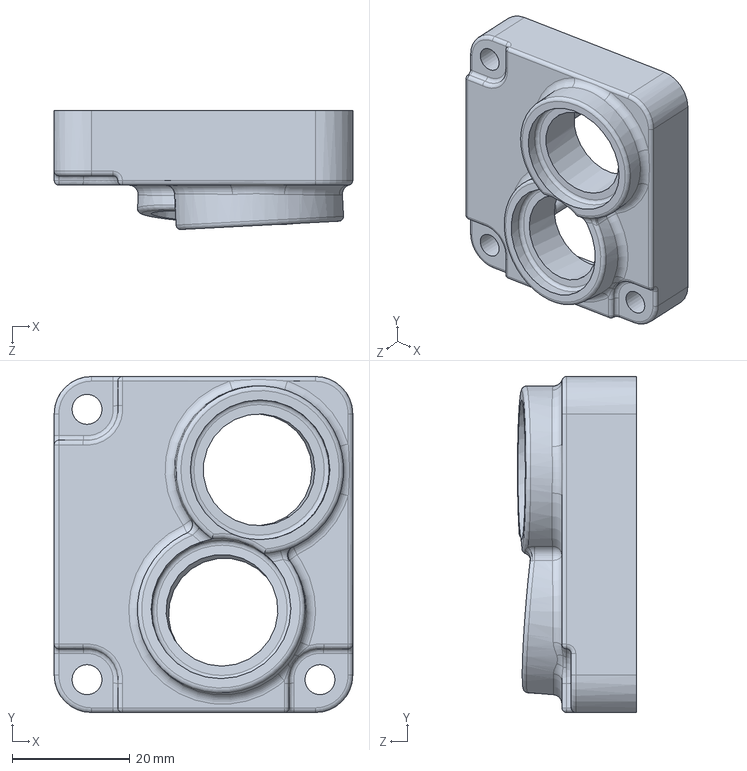
[picture p95: CAD file, 2019-07-24]
Part Files/Engine Block/DH-EB-M011.SLDPRT
50.8 x 57.1 x 20.2 mm
