trm79/Motorcycle-Engine-Design/Part Files/Valvetrain/DH-VT-M008.SLDPRT

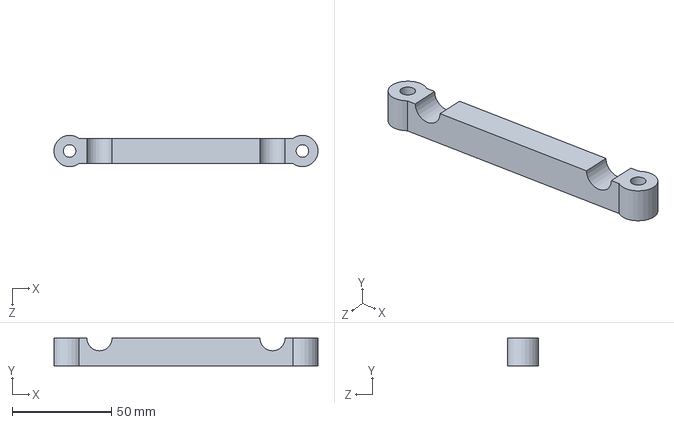
[picture p97: CAD file, 2019-07-24]
Part Files/Valvetrain/DH-VT-M008.SLDPRT
133.2 x 13.9 x 15.8 mm
