trm79/Motorcycle-Engine-Design/Part Files/Engine Block/DH-EB-M019.SLDPRT

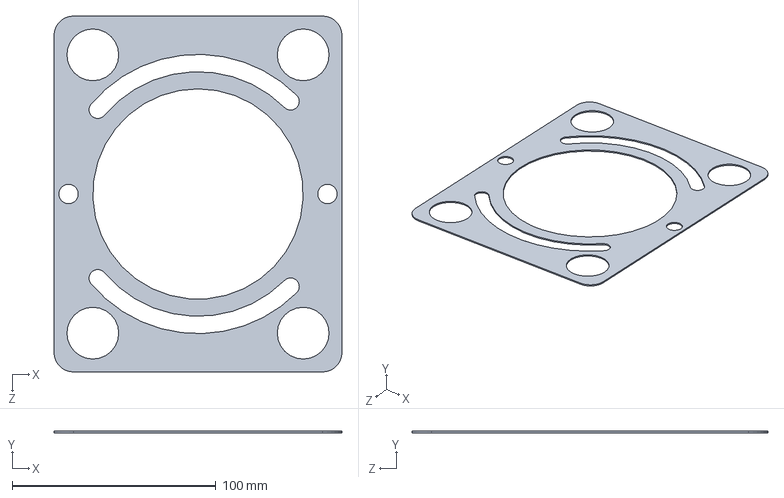
[picture p98: CAD file, 2019-07-24]
Part Files/Engine Block/DH-EB-M019.SLDPRT
141.3 x 0.794 x 174.6 mm
