trm79/Motorcycle-Engine-Design/Part Files/Powertrain/DH-PT-M003.SLDPRT

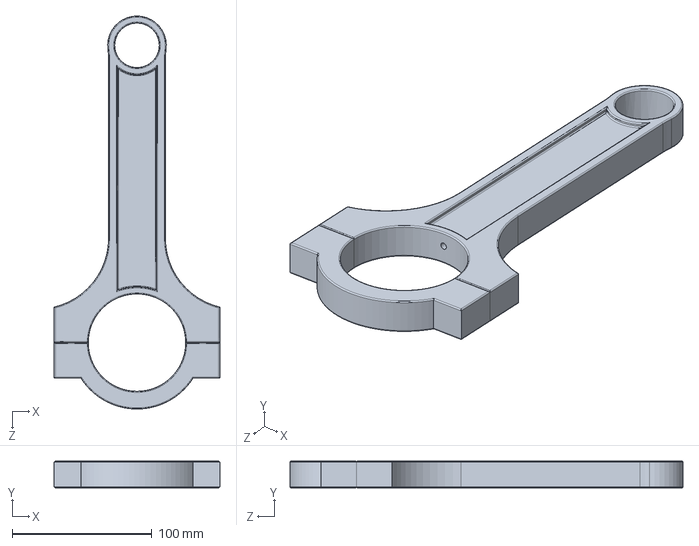
[picture p99: CAD file, 2019-07-24]
Part Files/Powertrain/DH-PT-M003.SLDPRT
118.6 x 19.1 x 281.4 mm
