trm79/Motorcycle-Engine-Design/Part Files/Valvetrain/DH-VT-M007.SLDPRT

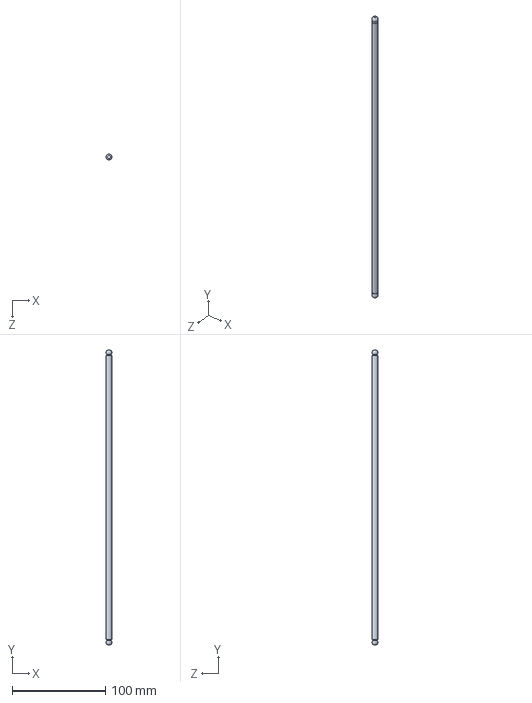
[picture p100: CAD file, 2019-07-24]
Part Files/Valvetrain/DH-VT-M007.SLDPRT
6.35 x 316.7 x 6.35 mm
