trm79/Motorcycle-Engine-Design/Part Files/Engine Block/DH-EB-P005.SLDPRT

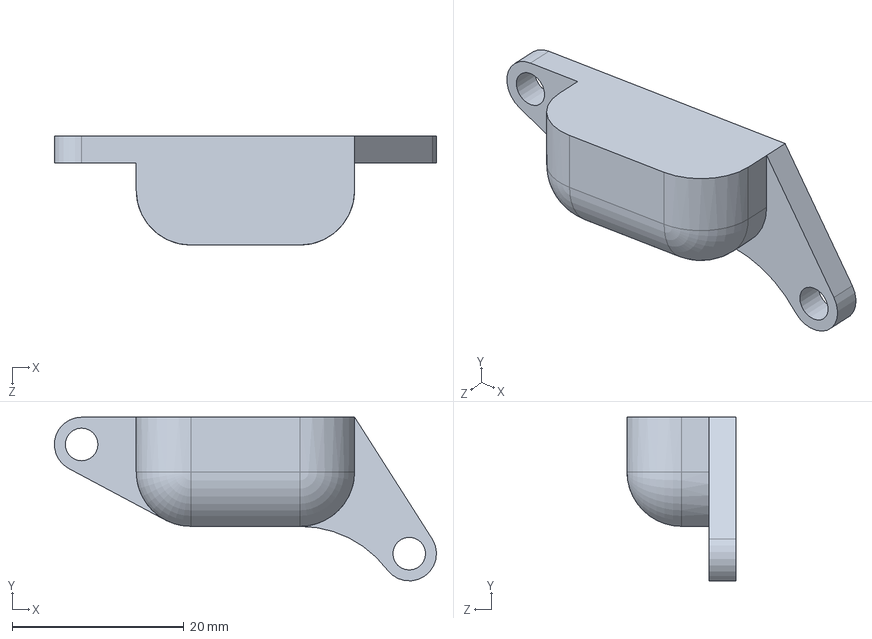
[picture p101: CAD file, 2019-07-24]
Part Files/Engine Block/DH-EB-P005.SLDPRT
44.4 x 19.0 x 12.7 mm
