trm79/Motorcycle-Engine-Design/Part Files/Powertrain/DH-PT-M012.SLDPRT

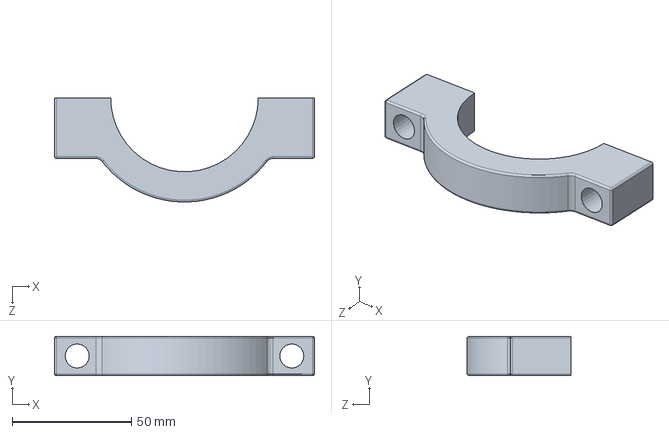
[picture p102: CAD file, 2019-07-24]
Part Files/Powertrain/DH-PT-M012.SLDPRT
109.1 x 16.5 x 43.6 mm
