trm79/Motorcycle-Engine-Design/Part Files/Engine Block/DH-EB-M001.SLDPRT

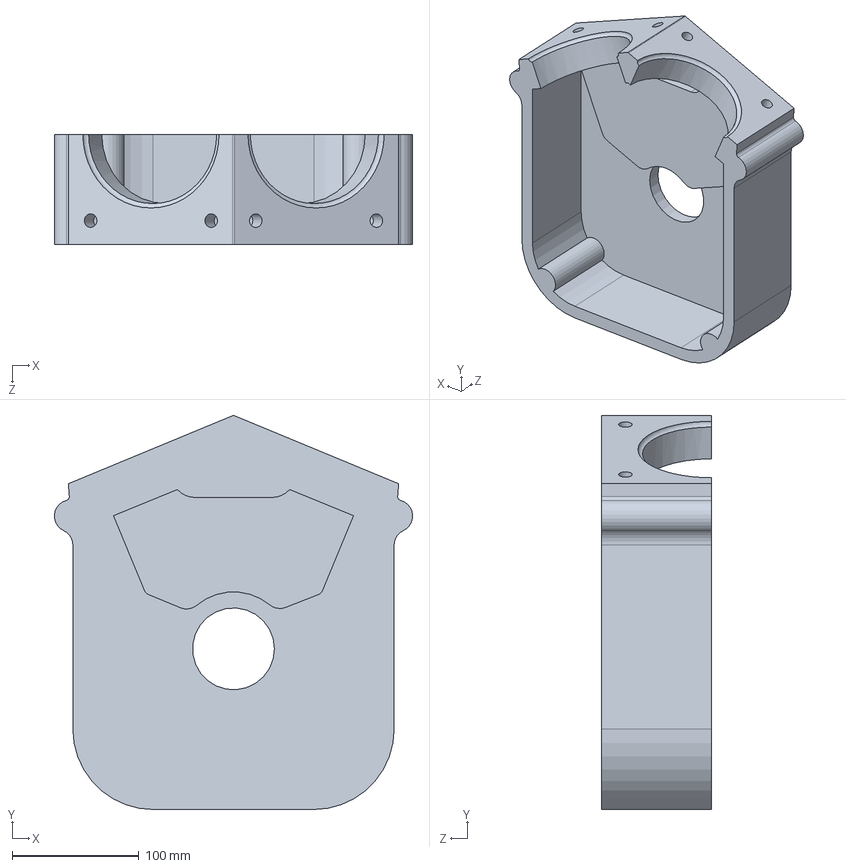
[picture p103: CAD file, 2019-07-24]
Part Files/Engine Block/DH-EB-M001.SLDPRT
283.1 x 311.5 x 87.3 mm
