trm79/Motorcycle-Engine-Design/Part Files/Powertrain/DH-LC-P027.SLDPRT

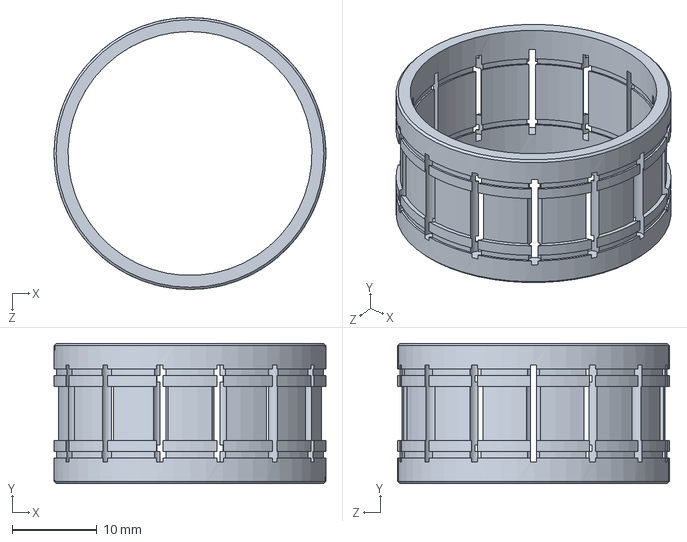
[picture p104: CAD file, 2019-07-24]
Part Files/Powertrain/DH-LC-P027.SLDPRT
32.0 x 16.5 x 32.0 mm
