trm79/Motorcycle-Engine-Design/Part Files/Valvetrain/DH-VT-M012.SLDPRT

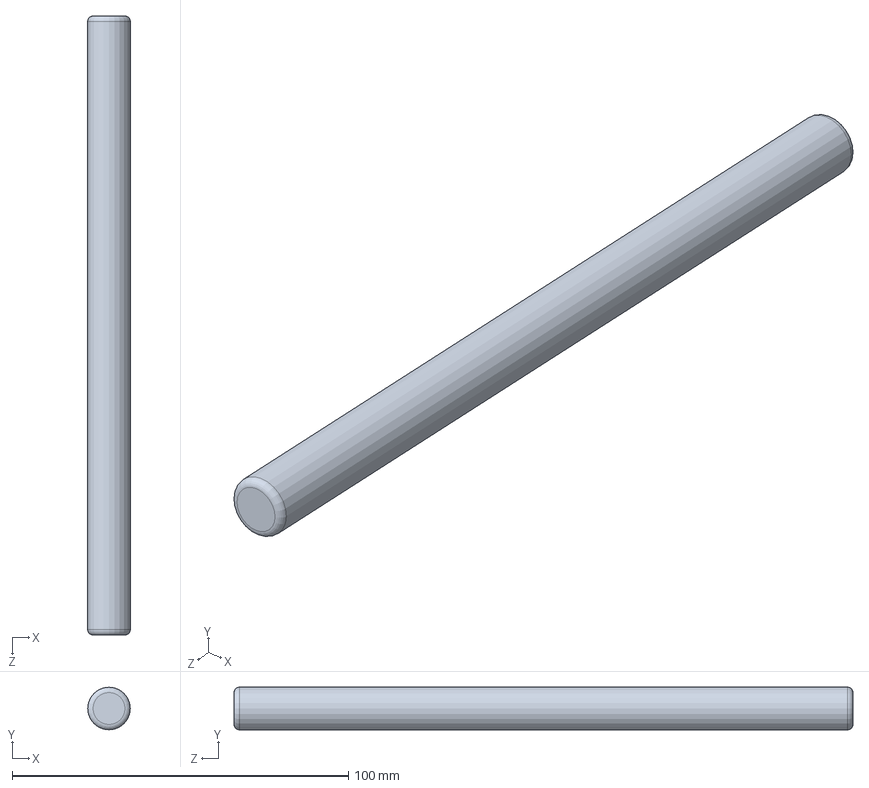
[picture p105: CAD file, 2019-07-24]
Part Files/Valvetrain/DH-VT-M012.SLDPRT
12.7 x 12.7 x 184.1 mm
