trm79/Motorcycle-Engine-Design/Part Files/Engine Block/DH-LC-P016.SLDPRT

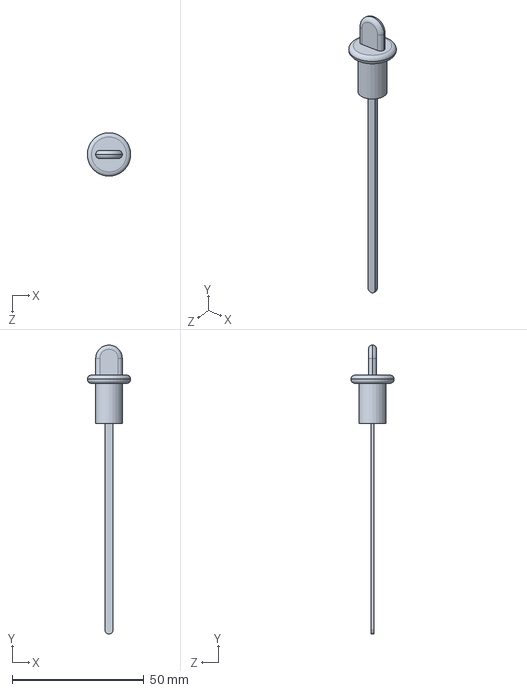
[picture p106: CAD file, 2019-07-24]
Part Files/Engine Block/DH-LC-P016.SLDPRT
16.5 x 109.9 x 16.5 mm
