trm79/Motorcycle-Engine-Design/Part Files/Valvetrain/DH-VT-P001.SLDPRT

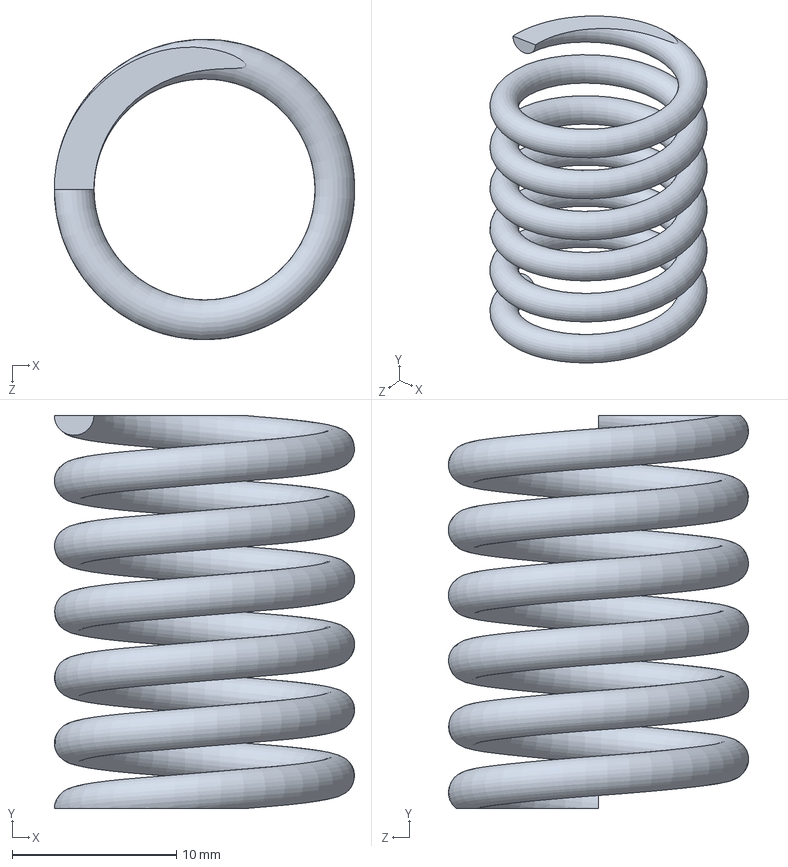
[picture p107: CAD file, 2019-07-24]
Part Files/Valvetrain/DH-VT-P001.SLDPRT
18.3 x 23.9 x 18.3 mm
