trm79/Motorcycle-Engine-Design/Part Files/Valvetrain/Exhaust Rocker.SLDPRT

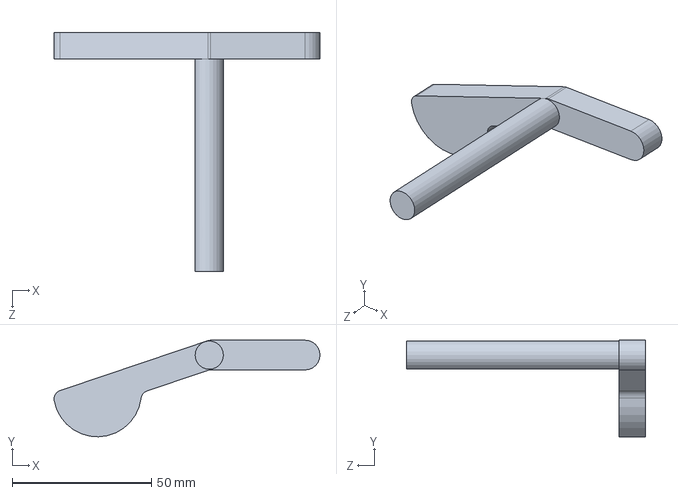
[picture p108: CAD file, 2019-07-24]
Part Files/Valvetrain/Exhaust Rocker.SLDPRT
95.6 x 34.7 x 85.7 mm
