trm79/Motorcycle-Engine-Design/Part Files/Engine Block/DH-EB-M010.SLDPRT

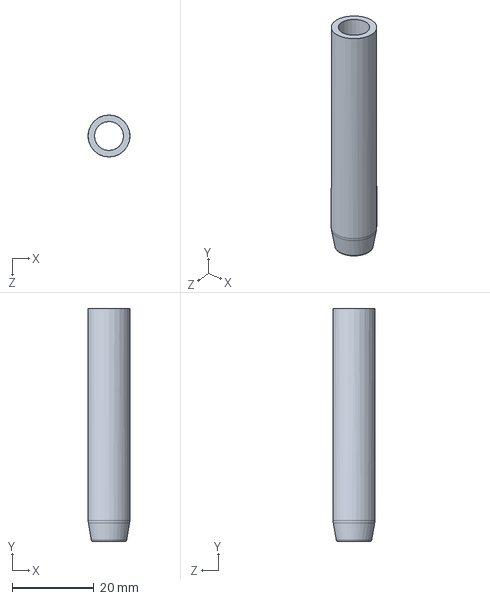
[picture p109: CAD file, 2019-07-24]
Part Files/Engine Block/DH-EB-M010.SLDPRT
10.3 x 57.1 x 10.3 mm
