trm79/Motorcycle-Engine-Design/Part Files/Engine Block/DH-EB-M002.sldprt

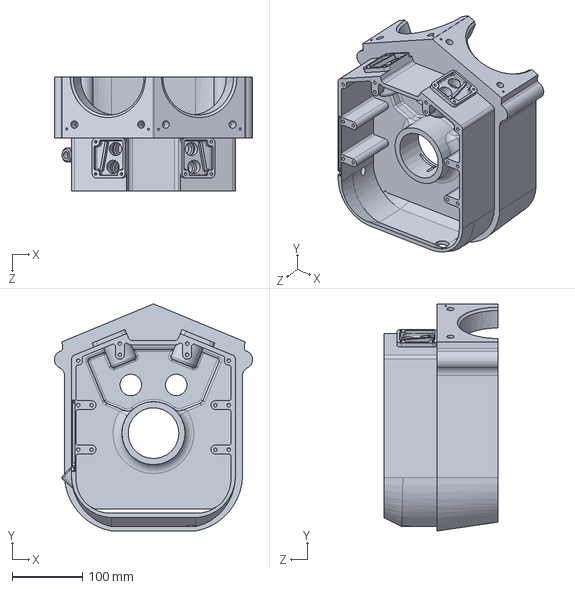
[picture p110: CAD file, 2019-07-24]
Part Files/Engine Block/DH-EB-M002.sldprt
283.1 x 324.2 x 163.5 mm
