trm79/Motorcycle-Engine-Design/Part Files/Engine Block/DH-EB-M006.SLDPRT

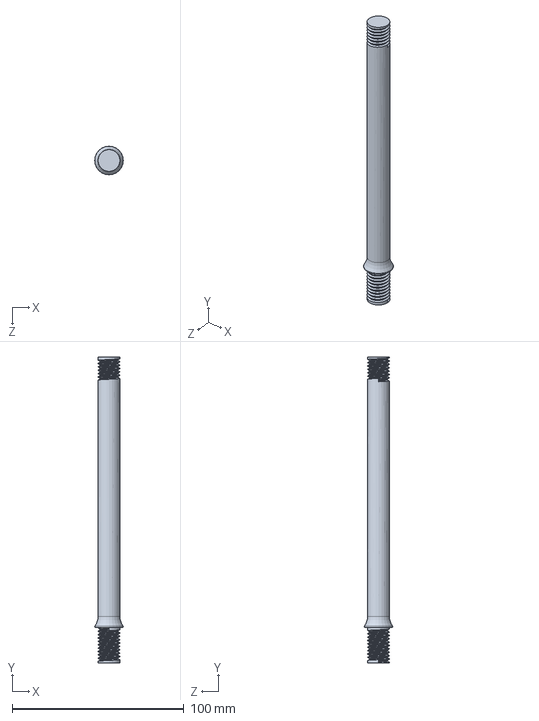
[picture p111: CAD file, 2019-07-24]
Part Files/Engine Block/DH-EB-M006.SLDPRT
16.7 x 177.9 x 16.7 mm
