trm79/Motorcycle-Engine-Design/Part Files/Engine Block/DH-EB-P001.SLDPRT

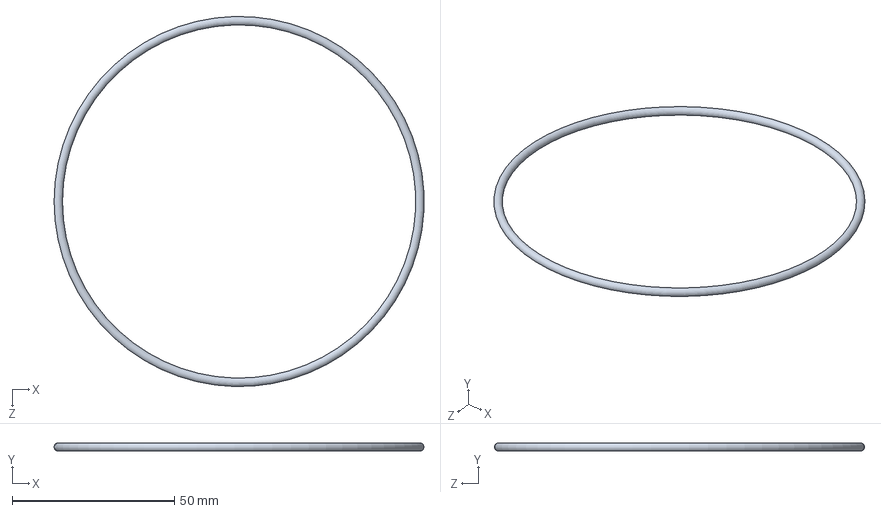
[picture p112: CAD file, 2019-07-24]
Part Files/Engine Block/DH-EB-P001.SLDPRT
114.0 x 2.62 x 114.0 mm
