trm79/Motorcycle-Engine-Design/Part Files/Engine Block/DH-LC-P015.SLDPRT

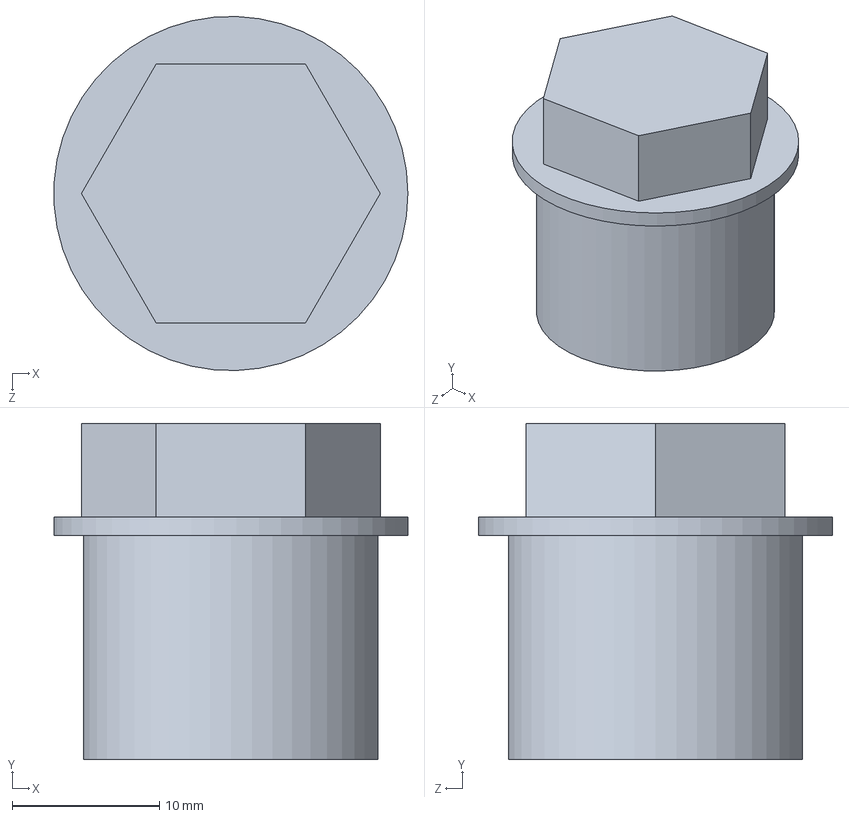
[picture p113: CAD file, 2019-07-24]
Part Files/Engine Block/DH-LC-P015.SLDPRT
24.1 x 22.9 x 24.1 mm
