trm79/Motorcycle-Engine-Design/Part Files/Valvetrain/DH-VT-A003.SLDASM

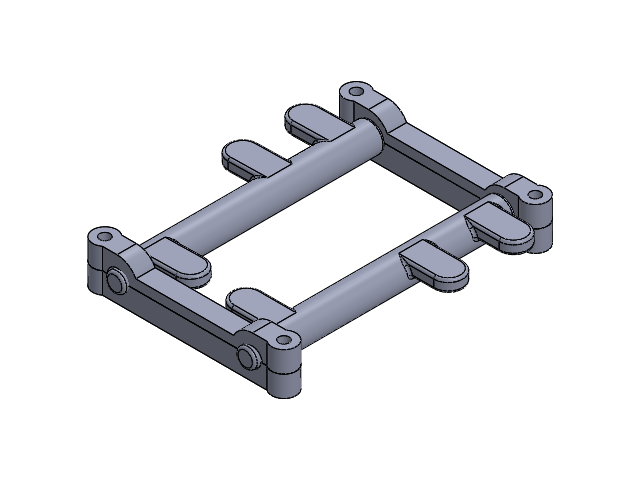
[picture p114: CAD file, 2019-07-24]
Part Files/Valvetrain/DH-VT-A003.SLDASM
DH-VT-M008 x 2
DH-VT-M009 x 2
DH-VT-M010
DH-VT-M012 x 2
DH-VT-M011
