trm79/Motorcycle-Engine-Design/(list of files, cad)

Other CAD files:
Part Files/Engine Block/DH-EB-A000.SLDASM
Part Files/Engine Block/DH-EB-P004.SLDPRT
Part Files/Engine Block/Rocker Box.SLDPRT
Part Files/Intake_Exhaust/DH-IE-M003.SLDPRT
Part Files/Valvetrain/DH-VT-M014.SLDPRT
Part Files/Engine Block/DH-EB-M020.SLDPRT
Part Files/Powertrain/Piston.SLDPRT
Part Files/Valvetrain/DH-VT-M016.SLDPRT
Part Files/Engine Block/DH-EB-P003.SLDPRT
Part Files/Valvetrain/DH-VT-M017.SLDPRT
Part Files/Valvetrain/Intake Stem.SLDPRT
Part Files/Engine Block/DH-EB-M013.SLDPRT
Part Files/Valvetrain/DH-VT-P004.SLDPRT
Part Files/Valvetrain/DH-LC-P023.SLDPRT
Part Files/Engine Block/DH-EB-M009.SLDPRT
Part Files/Drawings/Cylinder Head Assembly.SLDDRW
Part Files/Drawings/Engine Block Assembly.SLDDRW
Part Files/Drawings/Exhaust Manifold 1.SLDDRW
Part Files/Drawings/Exhaust Manifold 2 Part.SLDDRW
Part Files/Drawings/Exhaust Manifold 2.SLDDRW
Part Files/Drawings/Front Engine Block.SLDDRW
Part Files/Drawings/Full Assembly with Dimensions.SLDDRW
Part Files/Drawings/Intake Manifold Assembly Drawing.SLDDRW
Part Files/Drawings/Intake Manifold.SLDDRW
Part Files/Drawings/Main crank bearing bottom.SLDDRW
Part Files/Drawings/Main crank bearing top.SLDDRW
Part Files/Drawings/Powertrain Assembly.SLDDRW
Part Files/Drawings/Valve Subassembly.SLDDRW
Part Files/Drawings/aux crank bearing bottom.SLDDRW
Part Files/Drawings/aux crank bearing top.SLDDRW
Part Files/Drawings/cam bearing bottom.SLDDRW
Part Files/Drawings/cam bearing top.SLDDRW
Part Files/Drawings/con rod bearing (bottom).SLDDRW
Part Files/Drawings/con rod bearing (top).SLDDRW
Part Files/Drawings/dipstick.SLDDRW
Part Files/Drawings/wrist pin bearing.SLDDRW
Part Files/Powertrain/DH-LC-P018.SLDDRW
Part Files/Powertrain/DH-LC-P021.SLDDRW
Part Files/Powertrain/DH-PT-M001.SLDPRT
