trm79/Motorcycle-Engine-Design/Lubrication/FMEA Lubrication.xlsx

Pump | Loss of power
Pump | Cavitation
Pump | Pump failure
Cylinder Head | Flood cylinder head with oil
Oil Pan | Leak/loss of oil
Oil | Degradation of oil
Oil | Overheated oil
Filter | Clogged filter
