trm79/Motorcycle-Engine-Design/Other Work/FMEA.xlsx

Sheet: Full List
System | Part | Function | Failure Mode | Effect of Failure | Cause of Failure | S | O | D | RPN | Corrective Action | S | O | D | RPN
 |  |  | In what ways does the key input go wrong? | What is the impact on the key output variables (customer requirements)? | What causes the key input to go wrong? |  |  |  |  | What are the actions for reducing the occurence of the cause, or improving detection?
Powertrain | Crankshaft | Converts linear motion from the piston into rotary motion | Breakage | Catastrophic Engine Failure | Fatigue Failure | 5 | 2 | 1 | 10 | Design for minimum safety factor of 3 | 5 | 1 | 1 | 5
Powertrain | Crankshaft | Converts linear motion from the piston into rotary motion | Breakage | Catastrophic Engine Failure | Failure due to vibration | 5 | 3 | 2 | 30 | Quality checks to ensure balanced center of mass | 5 | 2 | 1 | 10
Powertrain | Crankshaft | Converts linear motion from the piston into rotary motion | Bearing wipeout/Breakage | Catastrophic Engine Failure | Insufficient lubrication | 5 | 3 | 1 | 15 | Recommend regular maintenence, including lubrication | 5 | 1 | 1 | 5
Powertrain | Conrod | Transferrs forces from piston to crankshaft | Breakage | Catastrophic Engine Failure | Over-Revving | 5 | 4 | 1 | 20 | Limit RPM from exceeding redline | 5 | 1 | 1 | 5
Powertrain | Conrod | Transferrs forces from piston to crankshaft | Breakage | Catastrophic Engine Failure | Insufficient Lubrication | 5 | 3 | 1 | 15 | Recommend regular maintenence, including lubrication | 5 | 1 | 1 | 5
Powertrain | Conrod | Transferrs forces from piston to crankshaft | Breakage | Catastrophic Engine Failure | Fatigue Failure | 5 | 2 | 1 | 10 | Design connecting rods with a minimum safety factor of 3 | 5 | 1 | 1 | 5
Powertrain | Piston | Converts chemical energy into kinetic energy | Breakage | Catastrophic Engine Failure | Failure due to Mechanical Damage | 5 | 2 | 1 | 10 | Design the engine with sufficient intake filtration to prevent debris from entering the engine. | 5 | 1 | 1 | 5
Powertrain | Piston | Converts chemical energy into kinetic energy | Breakage | Catastrophic Engine Failure | Insufficient Cooling | 5 | 3 | 1 | 15 | Recommend regular maintenence, including cooling | 5 | 1 | 1 | 5
Powertrain | Piston | Converts chemical energy into kinetic energy | Breakage | Catastrophic Engine Failure | Insufficient Lubrication | 5 | 3 | 1 | 15 | Recommend regular maintenence, including lubrication | 5 | 1 | 1 | 5
Powertrain | Piston | Converts chemical energy into kinetic energy | Breakage | Catastrophic Engine Failure | Incorrent Combustion Process | 5 | 2 | 1 | 10 | Recommend regular maintenence | 5 | 1 | 1 | 5
Powertrain | Piston | Converts chemical energy into kinetic energy | Breakage | Catastrophic Engine Failure | Thermal Fatigue Failure | 5 | 2 | 1 | 10 | Design Piston with a minimum safety factor of 3 | 5 | 1 | 1 | 5
Exhaust/Emissions | Catalytic Converter | Converts NOx, CO, and HC into less harmful gasses | Lack of oxygen | Reduces efficiency - excess fuel consumes all the oxygen before the catalyst | Too much fuel in air to fuel ratio (rich) | 2 | 1 | 3 | 6 | Oxygen sensor | 2 | 1 | 1 | 2
Exhaust/Emissions | Catalytic Converter | Converts NOx, CO, and HC into less harmful gasses | Too much oxygen | Reduction of NOx is not favored | Not enough fuel in air to fuel ratio (lean) | 2 | 1 | 3 | 6 | Oxygen sensor | 2 | 1 | 1 | 2
Exhaust/Emissions | Catalytic Converter | Converts NOx, CO, and HC into less harmful gasses | Working surface coated | Catalyst poisoning - substances cannot contact and react with the exhaust | Exposure to substances such as lead, sulfur, magnesium, and silicon - can enter exhaust if engine has leak that allows coolant into combustion chamber | 3 | 2 | 2 | 12 | OBD-II diagnostic systems - "check engine" light | 3 | 2 | 1 | 6
Exhaust/Emissions | Catalytic Converter | Converts NOx, CO, and HC into less harmful gasses | Meltdown of substrate | catalytic deactivation and severe exhaust restriction | Conditions causing abnormally high levels of hydrocarbons - manifold rust/corrosion/fatigue, damaged fuel system, oil with viscosity that is too thick | 4 | 2 | 2 | 16 | OBD-II diagnostic systems - "check engine" light | 4 | 2 | 1 | 8
Exhaust/Emissions | Exhaust Manifold | Allows for flow of exhaust gases out of engine and into exhaust pipe | Thermomechanical fatigue cracking | Exhaust gas leak - exposes rider to high temperature and releases more pollutants | Sustained high temperature exhaust gases | 4 | 3 | 1 | 12 | High temperature coating | 4 | 2 | 1 | 8
Exhaust/Emissions | Exhaust Manifold | Allows for flow of exhaust gases out of engine and into exhaust pipe | High cycle fatigue | Lowers fatigue life of manifold | Dynamic excitation, vibrational loading - usually related to unfavorable bracket design | 2 | 1 | 4 | 8 | Better bolt tightening/optimization of manifold geometry | 1 | 1 | 4 | 4
Exhaust/Emissions | Exhaust Gasket | Seals gap between manifold and engine block | Breakage | Leakage of exhaust gas | Expansion and contraction due to heat exposure | 3 | 3 | 1 | 9 | Adequate sealing stress and pressure distribution | 3 | 2 | 1 | 6
Exhaust/Emissions | Muffler | Reduces noice pollution | Wear/breakage | Increased engine noise, engine misfiring | Exposure to salt, frequent impacts due to speed bumps, pot holes, etc | 2 | 3 | 1 | 6 | Replace muffler | 1 | 3 | 1 | 3
Electronics | Spark Plugs | Provides the spark to ignite the fuel in combustion chamber, releases heat out. | Wear and Tear | Poor gas mileage, rough idle, stalling, lack of power, excess emissions. | Oil in Combustion Chamber | 3 | 1 | 2 | 6 | Place O-ring under spark plug to avoid oil flow inside chamber. Regular motorcycle maintenance recommended. | 2 | 1 | 1 | 2
Electronics | Spark Plugs | Provides the spark to ignite the fuel in combustion chamber, releases heat out. | Wear and Tear | Poor gas mileage, rough idle, stalling, lack of power, excess emissions. | Improperly Gapped Spark Plugs | 5 | 1 | 2 | 10 | Make sure that spark plug is placed and gapped correctly. Regular motorcycle maintenance recommended. | 2 | 1 | 1 | 2
Electronics | Spark Plugs | Provides the spark to ignite the fuel in combustion chamber, releases heat out. | Wear and Tear | Poor gas mileage, rough idle, stalling, lack of power, excess emissions. | Carbon Build Up | 4 | 1 | 2 | 8 | Caused by rich fuel to air ratio. Use oxygen sensor. | 2 | 1 | 1 | 2
Electronics | Spark Plugs | Provides the spark to ignite the fuel in combustion chamber, releases heat out. | Wear and Tear | Poor gas mileage, rough idle, stalling, lack of power, excess emissions. | Overheating | 3 | 1 | 2 | 6 | Analysing exhaust, smell for unburnt fuel. Regular car maintenance. | 2 | 1 | 1 | 2
Electronics | Starter Motor | Provides the electricity to the spark plug to ignite the fuel. | Wear | Motorcycle won't start | Oil Soaked | 4 | 1 | 3 | 12 | Look for fluid leakage near motor. | 4 | 1 | 2 | 8
Electronics | Starter Motor | Provides the electricity to the spark plug to ignite the fuel. | Broken Connection | Motorcycle won't start | Loose connection | 5 | 1 | 1 | 5 | Tighten wires, make sure connections are placed correctly | 4 | 1 | 1 | 4
Electronics | Starter Motor | Provides the electricity to the spark plug to ignite the fuel. | Wear and Tear | Motorcycle won't start | Broken Gear | 5 | 1 | 2 | 10 | Motorcycle will make whirring sound when trying to start it, and won't start | 4 | 1 | 1 | 4
Engine Block | DH-EB-M002, DH-EB-M003 | Houses crankshaft assembly | Corrosion or loosening of connecting bolts | Leaking oil | Improper material selection, excessive vibrations | 2 | 1 | 2 | 4 | Proper material selection, minimize vibrations | 2 | 1 | 1 | 2
Engine Block | DB-EB-M004 | Contains combustion chamber. Houses cylinder sleeve | Cracking, warping | Cracking, catatstrophic engine failure | Excessive friction or vibration | 5 | 1 | 4 | 20 | Proper material selection, ensure proper lubrication | 5 | 1 | 2 | 10
Injection | Fuel Injector | Inject fuel into the combustion chamber | Lack of fuel in air/fuel mixture (Lean) | Lack of fuel injected/uneven distribution of fuel leading to potential misfires, starting issues, poor idle, failed emissions, engine knock, full RPM not reached | Fuel nozzle coking leading to old fuel and carbon deposit buildup in injector causing oxygen sensor to read lean | 3 | 2 | 3 | 18 | Clean fuel injector - if that does not help, replace the fuel injector | 3 | 1 | 2 | 6
Injection | Oxygen Sensor | Determines the amount of oxygen in the exhaust so the ECU can determine whether the fuel is running rich or lean | Lack of fuel in air/fuel mixture (Lean) | Lack of fuel injected/uneven distribution of fuel leading to potential misfires, starting issues, poor idle, failed emissions, engine knock, full RPM not reached | Faulty sensor readings causing the engine to run lean for extended period of time | 3 | 2 | 3 | 18 | Check if the sensor can be cleaned, if not then replace the sensor | 3 | 1 | 2 | 6
Injection | Oxygen Sensor | Determines the amount of oxygen in the exhaust so the ECU can determine whether the fuel is running rich or lean | Surplus of fuel in air/fuel mixture (Rich) | Poor fuel efficiency and economy, slow acceleration, catalytic converter damage | Faulty sensor readings causing the engine to run rich for extended period of time | 2 | 2 | 2 | 8 | Check if the sensor can be cleaned, if not then replace the sensor | 2 | 1 | 2 | 4
Injection | Fuel Injector | Inject fuel into the combustion chamber | Breakage, Surplus of fuel in air/fuel mixture (Rich) | Poor fuel efficiency and economy, slow acceleration, catalytic converter damage, poor idle, hard starting | Cracked fuel injector leaking fuel from the injector body rather than the nozzle | 2 | 2 | 2 | 8 | Replace fuel injector | 2 | 1 | 2 | 4
Injection | Fuel injector | Inject fuel into the combustion chamber | Surplus of fuel in air/fuel mixture (Rich) | Poor fuel efficiency and economy, slow acceleration, catalytic converter damage | Fuel injector stuck open | 2 | 2 | 2 | 8 | Replace fuel injector | 2 | 1 | 2 | 4
Injection | Fuel injector | Inject fuel into the combustion chamber | No fuel in air/fuel mixture | Engine misfires which could lead to engine overheating | Fuel injector not injecting any fuel | 3 | 2 | 1 | 6 | Check if fuel injector is clogged and clean it, if not then replace fuel injector | 3 | 2 | 1 | 6
Valvetrain | Valve | Opens and closes cylinder | Bending | Engine Failure | Excessive loading | 5 | 3 | 2 | 30 | Material selection | 5 | 2 | 2 | 20
Valvetrain | Valve | Opens and closes cylinder | Burning | Engine Failure | Poor sealing | 5 | 3 | 3 | 45 | Material selection | 5 | 2 | 3 | 30
Valvetrain | Valve | Opens and closes cylinder | Bending | Engine Failure | Excessive loading | 5 | 3 | 4 | 60 | Material selection | 5 | 2 | 4 | 40
Valvetrain | Valve | Opens and closes cylinder | Burning | Engine Failure | Poor sealing | 5 | 3 | 3 | 45 | Material selection | 5 | 2 | 3 | 30
Valvetrain | Sprocket | Used to control timing | Fracture | Inability to engage chain/belt, engine failure | Fatigue, excessive loading | 4 | 3 | 4 | 48 | Material selection | 4 | 2 | 4 | 32
Valvetrain | Sprocket | Used to control timing | Misalignment | Inability to engage chain/belt, engine failure | Improperly lined up | 5 | 3 | 3 | 45 | Assemble with care | 5 | 1 | 3 | 15
Valvetrain | Cam Lobe | Open and closes cylinder valve | Wear | Incorrect timing/valve firing, decreased efficiency | Poor lubrication between lobe and follower | 4 | 1 | 2 | 8 | Control lubrication | 4 | 1 | 1 | 4
Valvetrain | Cam Lobe | Open and closes cylinder valve | Fracture | Valves won't open, incorrect timing/valve firing, decreased efficiency | Poor lubrication between lobe and follower | 4 | 2 | 2 | 16 | Control lubrication | 3 | 1 | 2 | 6
Valvetrain | Cam shaft | pushes valves and controls timing | Bending | Incorrect timing/valve firing, decreased efficiency | Poor lubrication, poor oil, excessive loading, valve spring pressure incorrect | 4 | 2 | 2 | 16 | Control lubrication, material selection | 3 | 2 | 2 | 12
Valvetrain | Valve Retainer | Retains valve | Breaking | Loss of power, engine failure | Fatigue, excessive loading | 3 | 2 | 2 | 12 | Material selection | 3 | 1 | 2 | 6
Valvetrain | Valve Retainer | Retains valve | Warping | Loss of efficiency, engine failure | Fatigue, excessive loading | 3 | 3 | 3 | 27 | Material selection | 3 | 1 | 3 | 9
Valvetrain | Spring | Pushes valve | Wear | Engine failure, decreased performance | Spring too stiff, fatigue | 3 | 3 | 4 | 36 | Material selection, regular maintenance | 3 | 2 | 4 | 24
Valvetrain | Spring | Pushes valve | Fractures | Engine failure | Spring too stiff, fatigue | 5 | 3 | 4 | 60 | Material selection, regular maintenance | 5 | 2 | 3 | 30
Valvetrain | Spring | Pushes valve | Valve Float | Decreased performance, incorrect timing | Spring too flexible | 3 | 3 | 4 | 36 | Material selection, regular maintenance | 3 | 2 | 4 | 24
Valvetrain | Cylinder Head | End cover of cylinder | Fractures | Decreased performance, incorrect timing | Fatigue, combustion pressure too high | 4 | 3 | 5 | 60 | Material selection, control fuel injection | 4 | 1 | 5 | 20
Valvetrain | Cylinder Head | End cover of cylinder | Warping | Decreased performance, incorrect timing | Overheating, fatigue, combustion pressure too high | 3 | 3 | 4 | 36 | Material selection, control fuel injection, control coolant | 3 | 2 | 4 | 24
Valvetrain | Cylinder Head | End cover of cylinder | Improper Sealing | Decreased performance, incorrect timing | Misaligned during assembly | 3 | 3 | 5 | 45 | Assemble with care | 3 | 2 | 5 | 30
Cooling/Lubrication | Radiator | Draws heat out of coolant fluid. | Coolant leak | Engine temperature increase, overheating | Loss of coolant causes lower heat transfer | 4 | 2 | 4 | 32 | Regular checks on coolant fluid. Coolant temperature meter. | 4 | 1 | 2 | 8
Cooling/Lubrication | Radiator | Draws heat out of coolant fluid. | Physical Damage (fins) | Reduced heat dissapation of radiator. | Hitting something. Small rocks or other projectiles from road. | 2 | 2 | 5 | 20 | Visual inspections of radiator. | 2 | 2 | 2 | 8
Cooling/Lubrication | Radiator | Draws heat out of coolant fluid. | Tank Cracking | Coolant leak. Engine temperature increase. Overheating | Stress concentrations in tank on tabs/corners propagate into cracks over time | 4 | 2 | 4 | 32 | Using metal tanks rather than plastic (heavier) or regular radiator checks. | 4 | 2 | 2 | 16
Cooling/Lubrication | Thermostat | Regulates flow of coolant into radiator based on engine temperature. | Stuck open/closed | High engine temperatures/overheating. Coolant leaks. | Faulty Installation | 4 | 2 | 3 | 24 | Quality checks in manufacturing to ensure proper installation. | 1 | 1 | 3 | 3
Cooling/Lubrication | Fan |  |  |  |  |  |  |  | 0 |  |  |  |  | 0
Cooling/Lubrication | Pump | Pumps oil through system at flow and pressure requirements | timing chain damaged, loss of power | oil is no longer pumped through the engine, no parts are lubricated, extreme wear and damage on components | Pinion rod misalignment or malfunction | 5 | 1 | 5 | 25 | Ensure proper assembly procedures and tolerances | 5 | 1 | 4 | 20
Cooling/Lubrication | Pump | Pumps oil through system at flow and pressure requirements | cavitation | insufficient or inconsistent flow rate to the engine | Bubbles in oil due to spinning of bearing, or intense movement of oil within oil pan, causing pump to pick up air | 2 | 3 | 3 | 18 | Ample time is given for oil to settle in the oil pan so that aeration of the oil will be decreased | 2 | 1 | 3 | 6
Cooling/Lubrication | Pump | Pumps oil through system at flow and pressure requirements | pump failure | oil is no longer pumped through the engine, no parts are lubricated, extreme wear and damage on components | Wear within pump internals, gears break | 5 | 1 | 5 | 25 | Flow rate sensors will help detect changes in pump flow to determine when the pump should be replaced | 5 | 1 | 3 | 15
Cooling/Lubrication | Oil Pan | Storage of oil | leak/loss of oil | oil is no longer pumped through the engine, no parts are lubricated, extreme wear and damage on components | Punctured from debris while riding, or some other outside impact | 3 | 2 | 4 | 24 | Pan will be raised up as high as possible, and customer can optionally install a skid plate uner the pan to protect it from debris | 3 | 1 | 4 | 12
Cooling/Lubrication | Oil | Lubricates engine components | degradation | Oil will not sufficiently lubricate the engine components | oil temperature is too high, failure to change oil at correct time | 3 | 4 | 4 | 48 | A proper time of oil changes will be specified with a sufficient safety factor. The change oil light will illuminate when oil should be changed | 3 | 3 | 2 | 18
Cooling/Lubrication | Oil | Lubricates engine components | overheated | Higher overall engine temp, decrease engine efficiency, could lead to oil degradation | High outside temperature, or extended riding times | 3 | 2 | 2 | 12 | Oil will be allowed to rest in oil pan for sufficient time to cool down. There will also be a temperature snesor in the pan to alert the rider if the oil becomes too hot and the bike must rest before continuing | 2 | 2 | 1 | 4
Cooling/Lubrication | Filters | Keeps oil free of particles so clean lubrication occurs | clogged | oil is no longer pumped through the engine, no parts are lubricated, extreme wear and damage on components | Failure to change filters on time, extreme wear of internal components, causing faser buildup of material within filter | 2 | 3 | 2 | 12 | Filters will be changed regularly, and placed in an easily accessible place so that users can change them easier | 2 | 2 | 2 | 8
Cooling/Lubrication | Bearings | Allows for hydrodynamic spinning of shafts, reduces wear on components | wear/damage | increased wear on spinning shafts, resulting in shorter lives of expensive components | Incorrect dimensionioning/tolerances of bearings not allowing for full hydrodynamic lubrication | 4 | 1 | 4 | 16 | Bearing tolerances will be set with a correct safety factor, and flow to bearings will also have a safety factor to ensure proper lubrication all the time | 3 | 1 | 4 | 12
Cooling/Lubrication | Intake Tube | Supplies oil from pan to oil channels | leak/loss of oil | oil is no longer pumped through the engine, no parts are lubricated, extreme wear and damage on components | Unexpected foreign object punctures tube, connection to pump or strainer shaken loose | 3 | 2 | 2 | 12 | High strength materials will be selected, and the tubes will be placed away from moving components | 3 | 1 | 2 | 6
Cooling/Lubrication | Pump Mount | Mounts pump to oil pan | vibration causes pump to come loose | pump can no longer function, same effect as loss of power to the pump |  | 4 | 2 | 1 | 8 | appropriately sized bolts will be chosen, with fine threads to prevent loosening from vibrations | 4 | 1 | 1 | 4

Sheet: TOP 5
System | Part | Function | Failure Mode | Effect of Failure | Cause of Failure | S | O | D | RPN | Corrective Action | S | O | D | RPN
Cooling/Lubrication | Oil | Lubricates engine components | Degradation | Oil will not sufficiently lubricate the engine components | Oil temperature is too high, failure to change oil at correct time | 5 | 4 | 4 | 80 | Regular oil changes specified with a sufficient safety factor. Oil change light. | 5 | 3 | 2 | 30
Valvetrain | Cylinder Head | Contains Valves, Combustion Chamber | Fractures | Decreased performance, incorrect timing | Overheating, fatigue | 4 | 3 | 4 | 48 | Cooling temperature gauge. Increase cooling flow through cylinder head. | 3 | 2 | 5 | 30
Valvetrain | Valve | Controls Injection/Exhaust | Fractures | Engine failure | Spring too stiff, fatigue | 5 | 3 | 4 | 60 | Quality checks for spring stiffness. | 5 | 2 | 3 | 30
Valvetrain | Sprocket | Controls timing chain | Fracture | Inability to engage chain/belt, engine failure | Fatigue, excessive loading | 4 | 3 | 4 | 48 | Timing checks in maintenance, ensure proper lubrication | 4 | 2 | 3 | 24
Powertrain | Crankshaft | Converts linear motion from the piston into rotary motion | Breakage | Catastrophic Engine Failure | Failure due to vibration | 5 | 3 | 3 | 45 | Quality checks to ensure balanced center of mass | 5 | 2 | 2 | 20

Sheet: Powertrain
System | Subsystem | Part | Function | Failure Mode | Effect of Failure | Cause of Failure | SEVERITY | OCCURRENCE | DETECTION | RPN | Corrective Action | SEVERITY | OCCURRENCE | DETECTION | RPN
 |  |  |  | In what ways does the key input go wrong? | What is the impact on the key output variables (customer requirements)? | What causes the key input to go wrong? |  |  |  |  | What are the actions for reducing the occurence of the cause, or improving detection?
Powertrain | Crankshaft |  | Converts linear motion from the piston into rotary motion | Breakage | Catastrophic Engine Failure | Fatigue Failure | 5 | 2 | 1 | 10 | Design for minimum safety factor of 3 | 5 | 1 | 1 | 5
Powertrain | Crankshaft |  | Converts linear motion from the piston into rotary motion | Breakage | Catastrophic Engine Failure | Failure due to vibration | 5 | 3 | 2 | 30 | Quality checks to ensure balanced center of mass | 5 | 2 | 1 | 10
Powertrain | Crankshaft |  | Converts linear motion from the piston into rotary motion | Bearing wipeout/Breakage | Catastrophic Engine Failure | Insufficient lubrication | 5 | 3 | 1 | 15 | Recommend regular maintenence, including lubrication | 5 | 1 | 1 | 5
Powertrain | Conrod |  | Transferrs forces from piston to crankshaft | Breakage | Catastrophic Engine Failure | Over-Revving | 5 | 4 | 1 | 20 | Limit RPM from exceeding redline | 5 | 1 | 1 | 5
Powertrain | Conrod |  | Transferrs forces from piston to crankshaft | Breakage | Catastrophic Engine Failure | Insufficient Lubrication | 5 | 3 | 1 | 15 | Recommend regular maintenence, including lubrication | 5 | 1 | 1 | 5
Powertrain | Conrod |  | Transferrs forces from piston to crankshaft | Breakage | Catastrophic Engine Failure | Fatigue Failure | 5 | 2 | 1 | 10 | Design connecting rods with a minimum safety factor of 3 | 5 | 1 | 1 | 5
Powertrain | Piston |  | Converts chemical energy into kinetic energy | Breakage | Catastrophic Engine Failure | Failure due to Mechanical Damage | 5 | 2 | 1 | 10 | Design the engine with sufficient intake filtration to prevent debris from entering the engine. | 5 | 1 | 1 | 5
Powertrain | Piston |  | Converts chemical energy into kinetic energy | Breakage | Catastrophic Engine Failure | Insufficient Cooling | 5 | 3 | 1 | 15 | Recommend regular maintenence, including cooling | 5 | 1 | 1 | 5
Powertrain | Piston |  | Converts chemical energy into kinetic energy | Breakage | Catastrophic Engine Failure | Insufficient Lubrication | 5 | 3 | 1 | 15 | Recommend regular maintenence, including lubrication | 5 | 1 | 1 | 5
Powertrain | Piston |  | Converts chemical energy into kinetic energy | Breakage | Catastrophic Engine Failure | Incorrent Combustion Process | 5 | 2 | 1 | 10 | Recommend regular maintenence | 5 | 1 | 1 | 5
Powertrain | Piston |  | Converts chemical energy into kinetic energy | Breakage | Catastrophic Engine Failure | Thermal Fatigue Failure | 5 | 2 | 1 | 10 | Design Piston with a minimum safety factor of 3 | 5 | 1 | 1 | 5
Powertrain |  |  |  |  |  |  |  |  |  | 0 |  |  |  |  | 0
Powertrain |  |  |  |  |  |  |  |  |  | 0 |  |  |  |  | 0
Powertrain |  |  |  |  |  |  |  |  |  | 0 |  |  |  |  | 0
Powertrain |  |  |  |  |  |  |  |  |  | 0 |  |  |  |  | 0
Powertrain |  |  |  |  |  |  |  |  |  | 0 |  |  |  |  | 0

Sheet: ExhaustEmission Control
System | Subsystem | Part | Function | Failure Mode | Effect of Failure | Cause of Failure | SEVERITY | OCCURRENCE | DETECTION | RPN | Corrective Action | SEVERITY | OCCURRENCE | DETECTION | RPN
 |  |  |  | In what ways does the key input go wrong? | What is the impact on the key output variables (customer requirements)? | What causes the key input to go wrong? |  |  |  |  | What are the actions for reducing the occurence of the cause, or improving detection?
Exhaust/Emissions | Emissions Control | Catalytic Converter | Converts NOx, CO, and HC into less harmful gasses | Lack of oxygen | Reduces efficiency - excess fuel consumes all the oxygen before the catalyst | Too much fuel in air to fuel ratio (rich) | 2 | 1 | 3 | 6 | Oxygen sensor | 2 | 1 | 1 | 2
Exhaust/Emissions | Emissions Control | Catalytic Converter | Converts NOx, CO, and HC into less harmful gasses | Too much oxygen | Reduction of NOx is not favored | Not enough fuel in air to fuel ratio (lean) | 2 | 1 | 3 | 6 | Oxygen sensor | 2 | 1 | 1 | 2
Exhaust/Emissions | Emissions Control | Catalytic Converter | Converts NOx, CO, and HC into less harmful gasses | Working surface coated | Catalyst poisoning - substances cannot contact and react with the exhaust | Exposure to substances such as lead, sulfur, magnesium, and silicon - can enter exhaust if engine has leak that allows coolant into combustion chamber | 3 | 2 | 2 | 12 | OBD-II diagnostic systems - "check engine" light | 3 | 2 | 1 | 6
Exhaust/Emissions | Emissions Control | Catalytic Converter | Converts NOx, CO, and HC into less harmful gasses | Meltdown of substrate | catalytic deactivation and severe exhaust restriction | Conditions causing abnormally high levels of hydrocarbons - manifold rust/corrosion/fatigue, damaged fuel system, oil with viscosity that is too thick | 4 | 2 | 2 | 16 | OBD-II diagnostic systems - "check engine" light | 4 | 2 | 1 | 8
Exhaust/Emissions | Exhaust System | Exhaust Manifold | Allows for flow of exhaust gases out of engine and into exhaust pipe | Thermomechanical fatigue cracking | Exhaust gas leak - exposes rider to high temperature and releases more pollutants | Sustained high temperature exhaust gases | 4 | 3 | 1 | 12 | High temperature coating | 4 | 2 | 1 | 8
Exhaust/Emissions | Exhaust System | Exhaust Manifold | Allows for flow of exhaust gases out of engine and into exhaust pipe | High cycle fatigue | Lowers fatigue life of manifold | Dynamic excitation, vibrational loading - usually related to unfavorable bracket design | 2 | 1 | 4 | 8 | Better bolt tightening/optimization of manifold geometry | 1 | 1 | 4 | 4
Exhaust/Emissions | Exhaust System | Exhaust Gasket | Seals gap between manifold and engine block | Breakage | Leakage of exhaust gas | Expansion and contraction due to heat exposure | 3 | 3 | 1 | 9 | Adequate sealing stress and pressure distribution | 3 | 2 | 1 | 6
Exhaust/Emissions | Exhaust System | Muffler | Reduces noice pollution | Wear/breakage | Increased engine noise, engine misfiring | Exposure to salt, frequent impacts due to speed bumps, pot holes, etc | 2 | 3 | 1 | 6 | Replace muffler | 1 | 3 | 1 | 3
Exhaust/Emissions |  |  |  |  |  |  |  |  |  | 0 |  |  |  |  | 0
Exhaust/Emissions |  |  |  |  |  |  |  |  |  | 0 |  |  |  |  | 0
Exhaust/Emissions |  |  |  |  |  |  |  |  |  | 0 |  |  |  |  | 0
Exhaust/Emissions |  |  |  |  |  |  |  |  |  | 0 |  |  |  |  | 0
Exhaust/Emissions |  |  |  |  |  |  |  |  |  | 0 |  |  |  |  | 0
Exhaust/Emissions |  |  |  |  |  |  |  |  |  | 0 |  |  |  |  | 0
Exhaust/Emissions |  |  |  |  |  |  |  |  |  | 0 |  |  |  |  | 0
Exhaust/Emissions |  |  |  |  |  |  |  |  |  | 0 |  |  |  |  | 0
Exhaust/Emissions |  |  |  |  |  |  |  |  |  | 0 |  |  |  |  | 0
Exhaust/Emissions |  |  |  |  |  |  |  |  |  | 0 |  |  |  |  | 0

Sheet: Electronics
System | Subsystem | Part | Function | Failure Mode | Effect of Failure | Cause of Failure | SEVERITY | OCCURRENCE | DETECTION | RPN | Corrective Action | SEVERITY | OCCURRENCE | DETECTION | RPN
 |  |  |  | In what ways does the key input go wrong? | What is the impact on the key output variables (customer requirements)? | What causes the key input to go wrong? |  |  |  |  | What are the actions for reducing the occurence of the cause, or improving detection?
Electronics |  | Spark Plugs | Provides the spark to ignite the fuel in combustion chamber, releases heat out. | Wear and Tear | Poor gas mileage, rough idle, stalling, lack of power, excess emissions. | Oil in Combustion Chamber | 3 | 1 | 2 | 6 | Place O-ring under spark plug to avoid oil flow inside chamber. Regular motorcycle maintenance recommended. | 2 | 1 | 1 | 2
Electronics |  | Spark Plugs | Provides the spark to ignite the fuel in combustion chamber, releases heat out. | Wear and Tear | Poor gas mileage, rough idle, stalling, lack of power, excess emissions. | Improperly Gapped Spark Plugs | 5 | 1 | 2 | 10 | Make sure that spark plug is placed and gapped correctly. Regular motorcycle maintenance recommended. | 2 | 1 | 1 | 2
Electronics |  | Spark Plugs | Provides the spark to ignite the fuel in combustion chamber, releases heat out. | Wear and Tear | Poor gas mileage, rough idle, stalling, lack of power, excess emissions. | Carbon Build Up | 4 | 1 | 2 | 8 | Caused by rich fuel to air ratio. Use oxygen sensor. | 2 | 1 | 1 | 2
Electronics |  | Spark Plugs | Provides the spark to ignite the fuel in combustion chamber, releases heat out. | Wear and Tear | Poor gas mileage, rough idle, stalling, lack of power, excess emissions. | Overheating | 3 | 1 | 2 | 6 | Analysing exhaust, smell for unburnt fuel. Regular car maintenance. | 2 | 1 | 1 | 2
Electronics |  | Starter Motor | Provides the electricity to the spark plug to ignite the fuel. | Wear | Motorcycle won't start | Oil Soaked | 4 | 1 | 3 | 12 | Look for fluid leakage near motor. | 4 | 1 | 2 | 8
Electronics |  | Starter Motor | Provides the electricity to the spark plug to ignite the fuel. | Broken Connection | Motorcycle won't start | Loose connection | 5 | 1 | 1 | 5 | Tighten wires, make sure connections are placed correctly | 4 | 1 | 1 | 4
Electronics |  | Starter Motor | Provides the electricity to the spark plug to ignite the fuel. | Wear and Tear | Motorcycle won't start | Broken Gear | 5 | 1 | 2 | 10 | Motorcycle will make whirring sound when trying to start it, and won't start | 4 | 1 | 1 | 4

Sheet: Engine Block
System | Subsystem | Part | Function | Failure Mode | Effect of Failure | Cause of Failure | SEVERITY | OCCURRENCE | DETECTION | RPN | Corrective Action | SEVERITY | OCCURRENCE | DETECTION | RPN
 |  |  |  | In what ways does the key input go wrong? | What is the impact on the key output variables (customer requirements)? | What causes the key input to go wrong? |  |  |  |  | What are the actions for reducing the occurence of the cause, or improving detection?
Engine Block | Crankcase | DH-EB-M002, DH-EB-M003 | Houses crankshaft assembly | Corrosion or loosening of connecting bolts | Leaking oil | Improper material selection, excessive vibrations | 2 | 1 | 2 | 4 | Proper material selection, minimize vibrations | 2 | 1 | 1 | 2
Engine Block | Cylinder | DB-EB-M004 | Contains combustion chamber. Houses cylinder sleeve | Cracking, warping | Cracking, catatstrophic engine failure | Excessive friction or vibration | 5 | 1 | 4 | 20 | Proper material selection, ensure proper lubrication | 5 | 1 | 2 | 10
Engine Block |  |  |  |  |  |  |  |  |  | 0 |  |  |  |  | 0
Engine Block |  |  |  |  |  |  |  |  |  | 0 |  |  |  |  | 0
Engine Block |  |  |  |  |  |  |  |  |  | 0 |  |  |  |  | 0
Engine Block |  |  |  |  |  |  |  |  |  | 0 |  |  |  |  | 0
Engine Block |  |  |  |  |  |  |  |  |  | 0 |  |  |  |  | 0
Engine Block |  |  |  |  |  |  |  |  |  | 0 |  |  |  |  | 0
Engine Block |  |  |  |  |  |  |  |  |  | 0 |  |  |  |  | 0
Engine Block |  |  |  |  |  |  |  |  |  | 0 |  |  |  |  | 0
Engine Block |  |  |  |  |  |  |  |  |  | 0 |  |  |  |  | 0
Engine Block |  |  |  |  |  |  |  |  |  | 0 |  |  |  |  | 0
Engine Block |  |  |  |  |  |  |  |  |  | 0 |  |  |  |  | 0
Engine Block |  |  |  |  |  |  |  |  |  | 0 |  |  |  |  | 0
Engine Block |  |  |  |  |  |  |  |  |  | 0 |  |  |  |  | 0
Engine Block |  |  |  |  |  |  |  |  |  | 0 |  |  |  |  | 0
Engine Block |  |  |  |  |  |  |  |  |  | 0 |  |  |  |  | 0
Engine Block |  |  |  |  |  |  |  |  |  | 0 |  |  |  |  | 0

Sheet: Injection
System | Subsystem | Part | Function | Failure Mode | Effect of Failure | Cause of Failure | SEVERITY | OCCURRENCE | DETECTION | RPN | Corrective Action | SEVERITY | OCCURRENCE | DETECTION | RPN |  | Running rich: can detect via smell and black smoke
 |  |  |  | In what ways does the key input go wrong? | What is the impact on the key output variables (customer requirements)? | What causes the key input to go wrong? |  |  |  |  | What are the actions for reducing the occurence of the cause, or improving detection? |  |  |  |  | https://www.buyautoparts.com/howto/symptoms-of-bad-fuel-injectors.htm
Injection | Fuel Injection | Fuel Injector | Inject fuel into the combustion chamber | Lack of fuel in air/fuel mixture (Lean) | Lack of fuel injected/uneven distribution of fuel leading to potential misfires, starting issues, poor idle, failed emissions, engine knock, full RPM not reached | Fuel nozzle coking leading to old fuel and carbon deposit buildup in injector causing oxygen sensor to read lean | 3 | 2 | 3 | 18 | Clean fuel injector - if that does not help, replace the fuel injector | 3 | 1 | 2 | 6 | http://automedicsafrica.com/car-running-rich-lean-means-much-insufficient-fuel-supply/ | https://www.knowyourparts.com/technical-resources/engine/replace-a-fuel-injector/ | https://www.injectorrx.com/fuel-injector-cleaning-and-flow-testing-service/fuel-injector-symptoms/
Injection | Fuel Injection | Oxygen Sensor | Determines the amount of oxygen in the exhaust so the ECU can determine whether the fuel is running rich or lean | Lack of fuel in air/fuel mixture (Lean) | Lack of fuel injected/uneven distribution of fuel leading to potential misfires, starting issues, poor idle, failed emissions, engine knock, full RPM not reached | Faulty sensor readings causing the engine to run lean for extended period of time | 3 | 2 | 3 | 18 | Check if the sensor can be cleaned, if not then replace the sensor | 3 | 1 | 2 | 6
Injection | Fuel Injection | Oxygen Sensor | Determines the amount of oxygen in the exhaust so the ECU can determine whether the fuel is running rich or lean | Surplus of fuel in air/fuel mixture (Rich) | Poor fuel efficiency and economy, slow acceleration, catalytic converter damage | Faulty sensor readings causing the engine to run rich for extended period of time | 2 | 2 | 2 | 8 | Check if the sensor can be cleaned, if not then replace the sensor | 2 | 1 | 2 | 4
Injection | Fuel Injection | Fuel Injector | Inject fuel into the combustion chamber | Breakage, Surplus of fuel in air/fuel mixture (Rich) | Poor fuel efficiency and economy, slow acceleration, catalytic converter damage, poor idle, hard starting | Cracked fuel injector leaking fuel from the injector body rather than the nozzle | 2 | 2 | 2 | 8 | Replace fuel injector | 2 | 1 | 2 | 4
Injection | Fuel Injection | Fuel injector | Inject fuel into the combustion chamber | Surplus of fuel in air/fuel mixture (Rich) | Poor fuel efficiency and economy, slow acceleration, catalytic converter damage | Fuel injector stuck open | 2 | 2 | 2 | 8 | Replace fuel injector | 2 | 1 | 2 | 4
Injection | Fuel Injection | Fuel injector | Inject fuel into the combustion chamber | No fuel in air/fuel mixture | Engine misfires which could lead to engine overheating | Fuel injector not injecting any fuel | 3 | 2 | 1 | 6 | Check if fuel injector is clogged and clean it, if not then replace fuel injector | 3 | 2 | 1 | 6

Sheet: Valvetrain
System | Subsystem | Part | Function | Failure Mode | Effect of Failure | Cause of Failure | SEVERITY | OCCURRENCE | DETECTION | RPN | Corrective Action | SEVERITY | OCCURRENCE | DETECTION | RPN
 |  |  |  | In what ways does the key input go wrong? | What is the impact on the key output variables (customer requirements)? | What causes the key input to go wrong? |  |  |  |  | What are the actions for reducing the occurence of the cause, or improving detection?
Valvetrain | Intake | Valve |  | Bending | Engine Failure | Excessive loading | 5 | 3 | 2 | 30 | Material selection | 5 | 2 | 2 | 20
Valvetrain |  | Valve |  | Burning | Engine Failure | Poor sealing | 5 | 3 | 3 | 45 | Material selection | 5 | 2 | 3 | 30
Valvetrain | Exhaust | Valve |  | Bending | Engine Failure | Excessive loading | 5 | 3 | 4 | 60 | Material selection | 5 | 2 | 4 | 40
Valvetrain |  | Valve |  | Burning | Engine Failure | Poor sealing | 5 | 3 | 3 | 45 | Material selection | 5 | 2 | 3 | 30
Valvetrain | Camshaft | Sprocket |  | Fracture | Inability to engage chain/belt, engine failure | Fatigue, excessive loading | 4 | 3 | 4 | 48 | Material selection | 4 | 2 | 4 | 32
Valvetrain |  |  |  | Misalignment | Inability to engage chain/belt, engine failure | Improperly lined up | 5 | 3 | 3 | 45 | Assemble with care | 5 | 1 | 3 | 15
Valvetrain |  | Cam Lobe |  | Wear | Incorrect timing/valve firing, decreased efficiency | Poor lubrication between lobe and follower | 4 | 1 | 2 | 8 | Control lubrication | 4 | 1 | 1 | 4
Valvetrain |  | Cam Lobe |  | Fracture | Valves won't open, incorrect timing/valve firing, decreased efficiency | Poor lubrication between lobe and follower | 4 | 2 | 2 | 16 | Control lubrication | 3 | 1 | 2 | 6
Valvetrain |  | Shaft |  | Bending | Incorrect timing/valve firing, decreased efficiency | Poor lubrication, poor oil, excessive loading, valve spring pressure incorrect | 4 | 2 | 2 | 16 | Control lubrication, material selection | 3 | 2 | 2 | 12
Valvetrain | Valve | Retainer |  | Breaking | Loss of power, engine failure | Fatigue, excessive loading | 3 | 2 | 2 | 12 | Material selection | 3 | 1 | 2 | 6
Valvetrain |  |  |  | Warping | Loss of efficiency, engine failure | Fatigue, excessive loading | 3 | 3 | 3 | 27 | Material selection | 3 | 1 | 3 | 9
Valvetrain |  | Spring |  | Wear | Engine failure, decreased performance | Spring too stiff, fatigue | 3 | 3 | 4 | 36 | Material selection, regular maintenance | 3 | 2 | 4 | 24
Valvetrain |  |  |  | Fractures | Engine failure | Spring too stiff, fatigue | 5 | 3 | 4 | 60 | Material selection, regular maintenance | 5 | 2 | 3 | 30
Valvetrain |  |  |  | Valve Float | Decreased performance, incorrect timing | Spring too flexible | 3 | 3 | 4 | 36 | Material selection, regular maintenance | 3 | 2 | 4 | 24
Valvetrain | Cylinder | Head |  | Fractures | Decreased performance, incorrect timing | Fatigue, combustion pressure too high | 4 | 3 | 5 | 60 | Material selection, control fuel injection | 4 | 1 | 5 | 20
Valvetrain |  |  |  | Warping | Decreased performance, incorrect timing | Overheating, fatigue, combustion pressure too high | 3 | 3 | 4 | 36 | Material selection, control fuel injection, control coolant | 3 | 2 | 4 | 24
Valvetrain |  |  |  | Improper Sealing | Decreased performance, incorrect timing | Misaligned during assembly | 3 | 3 | 5 | 45 | Assemble with care | 3 | 2 | 5 | 30
Valvetrain | Rocker Arm |  |  | Warping | Decreased performance, incorrect timing | Poor lubrication, excessive loading |  |  |  | 0 | Material selection, control lubrication |  |  |  | 0
Valvetrain |  |  |  | Breaking | Engine failure | Poor lubrication, excessive loading |  |  |  | 0 | Material selection, control lubrication |  |  |  | 0
Valvetrain | Pushrod |  |  | Warping | Engine failure | Poor lubrication, excessive loading |  |  |  | 0 | Material selection, control lubrication |  |  |  | 0
Valvetrain |  |  |  | Breaking | Engine failure | Poor lubrication, excessive loading |  |  |  | 0 | Material selection, control lubrication |  |  |  | 0
Valvetrain |  | Follower |  | Wear | Decreased performance, incorrect timing | Poor lubrication |  |  |  | 0 | Material selection, control lubrication |  |  |  | 0

Sheet: CoolingLubrication
System | Subsystem | Part | Function | Failure Mode | Effect of Failure | Cause of Failure | SEVERITY | OCCURRENCE | DETECTION | RPN | Corrective Action | SEVERITY | OCCURRENCE | DETECTION | RPN
 |  |  |  | In what ways does the key input go wrong? | What is the impact on the key output variables (customer requirements)? | What causes the key input to go wrong? |  |  |  |  | What are the actions for reducing the occurence of the cause, or improving detection?
Cooling/Lubrication | Radiator |  | Draws heat out of coolant fluid. | Coolant leak | Engine temperature increase, overheating | Loss of coolant causes lower heat transfer | 4 | 2 | 4 | 32 | Regular checks on coolant fluid. Coolant temperature meter. | 4 | 1 | 2 | 8
Cooling/Lubrication | Radiator |  | Draws heat out of coolant fluid. | Physical Damage (fins) | Reduced heat dissapation of radiator. | Hitting something. Small rocks or other projectiles from road. | 2 | 2 | 5 | 20 | Visual inspections of radiator. | 2 | 2 | 2 | 8
Cooling/Lubrication | Radiator |  | Draws heat out of coolant fluid. | Tank Cracking | Coolant leak. Engine temperature increase. Overheating | Stress concentrations in tank on tabs/corners propagate into cracks over time | 4 | 2 | 4 | 32 | Using metal tanks rather than plastic (heavier) or regular radiator checks. | 4 | 2 | 2 | 16
Cooling/Lubrication | Thermostat |  | Regulates flow of coolant into radiator based on engine temperature. | Stuck open/closed | High engine temperatures/overheating. Coolant leaks. | Faulty Installation | 4 | 2 | 3 | 24 | Quality checks in manufacturing to ensure proper installation. | 1 | 1 | 3 | 3
Cooling/Lubrication | Fan |  |  |  |  |  |  |  |  | 0 |  |  |  |  | 0
Cooling/Lubrication | Pump |  | Pumps oil through system at flow and pressure requirements | timing chain damaged, loss of power | oil is no longer pumped through the engine, no parts are lubricated, extreme wear and damage on components | Pinion rod misalignment or malfunction | 5 | 1 | 5 | 25 | Ensure proper assembly procedures and tolerances | 5 | 1 | 4 | 20
Cooling/Lubrication | Pump |  | Pumps oil through system at flow and pressure requirements | cavitation | insufficient or inconsistent flow rate to the engine | Bubbles in oil due to spinning of bearing, or intense movement of oil within oil pan, causing pump to pick up air | 2 | 3 | 3 | 18 | Ample time is given for oil to settle in the oil pan so that aeration of the oil will be decreased | 2 | 1 | 3 | 6
Cooling/Lubrication | Pump |  | Pumps oil through system at flow and pressure requirements | pump failure | oil is no longer pumped through the engine, no parts are lubricated, extreme wear and damage on components | Wear within pump internals, gears break | 5 | 1 | 5 | 25 | Flow rate sensors will help detect changes in pump flow to determine when the pump should be replaced | 5 | 1 | 3 | 15
Cooling/Lubrication | Oil Pan |  | Storage of oil | leak/loss of oil | oil is no longer pumped through the engine, no parts are lubricated, extreme wear and damage on components | Punctured from debris while riding, or some other outside impact | 3 | 2 | 4 | 24 | Pan will be raised up as high as possible, and customer can optionally install a skid plate uner the pan to protect it from debris | 3 | 1 | 4 | 12
Cooling/Lubrication | Oil |  | Lubricates engine components | degradation | Oil will not sufficiently lubricate the engine components | oil temperature is too high, failure to change oil at correct time | 3 | 4 | 4 | 48 | A proper time of oil changes will be specified with a sufficient safety factor. The change oil light will illuminate when oil should be changed | 3 | 3 | 2 | 18
Cooling/Lubrication | Oil |  | Lubricates engine components | overheated | Higher overall engine temp, decrease engine efficiency, could lead to oil degradation | High outside temperature, or extended riding times | 3 | 2 | 2 | 12 | Oil will be allowed to rest in oil pan for sufficient time to cool down. There will also be a temperature snesor in the pan to alert the rider if the oil becomes too hot and the bike must rest before continuing | 2 | 2 | 1 | 4
Cooling/Lubrication | Filters |  | Keeps oil free of particles so clean lubrication occurs | clogged | oil is no longer pumped through the engine, no parts are lubricated, extreme wear and damage on components | Failure to change filters on time, extreme wear of internal components, causing faser buildup of material within filter | 2 | 3 | 2 | 12 | Filters will be changed regularly, and placed in an easily accessible place so that users can change them easier | 2 | 2 | 2 | 8
Cooling/Lubrication | Bearings |  | Allows for hydrodynamic spinning of shafts, reduces wear on components | wear/damage | increased wear on spinning shafts, resulting in shorter lives of expensive components | Incorrect dimensionioning/tolerances of bearings not allowing for full hydrodynamic lubrication | 4 | 1 | 4 | 16 | Bearing tolerances will be set with a correct safety factor, and flow to bearings will also have a safety factor to ensure proper lubrication all the time | 3 | 1 | 4 | 12
Cooling/Lubrication | Intake Tube |  | Supplies oil from pan to oil channels | leak/loss of oil | oil is no longer pumped through the engine, no parts are lubricated, extreme wear and damage on components | Unexpected foreign object punctures tube, connection to pump or strainer shaken loose | 3 | 2 | 2 | 12 | High strength materials will be selected, and the tubes will be placed away from moving components | 3 | 1 | 2 | 6
Cooling/Lubrication | Pump Mount |  | Mounts pump to oil pan | vibration causes pump to come loose | pump can no longer function, same effect as loss of power to the pump |  | 4 | 2 | 1 | 8 | appropriately sized bolts will be chosen, with fine threads to prevent loosening from vibrations | 4 | 1 | 1 | 4
Cooling/Lubrication | Oil Drillings |  | Carries oil to components | clogged | channels become clogged and oil can no longer be supplied at correct pressure/flow | poor oil quality and high engine wear rate | 3 | 2 | 3 | 18 | good oil filter and oil change increments specified | 3 | 1 | 2 | 6
Cooling/Lubrication |  |  |  |  |  |  |  |  |  | 0 |  |  |  |  | 0
Cooling/Lubrication |  |  |  |  |  |  |  |  |  | 0 |  |  |  |  | 0
