trm79/Motorcycle-Engine-Design/Other Work/Cylinder Head Assembly.PDF

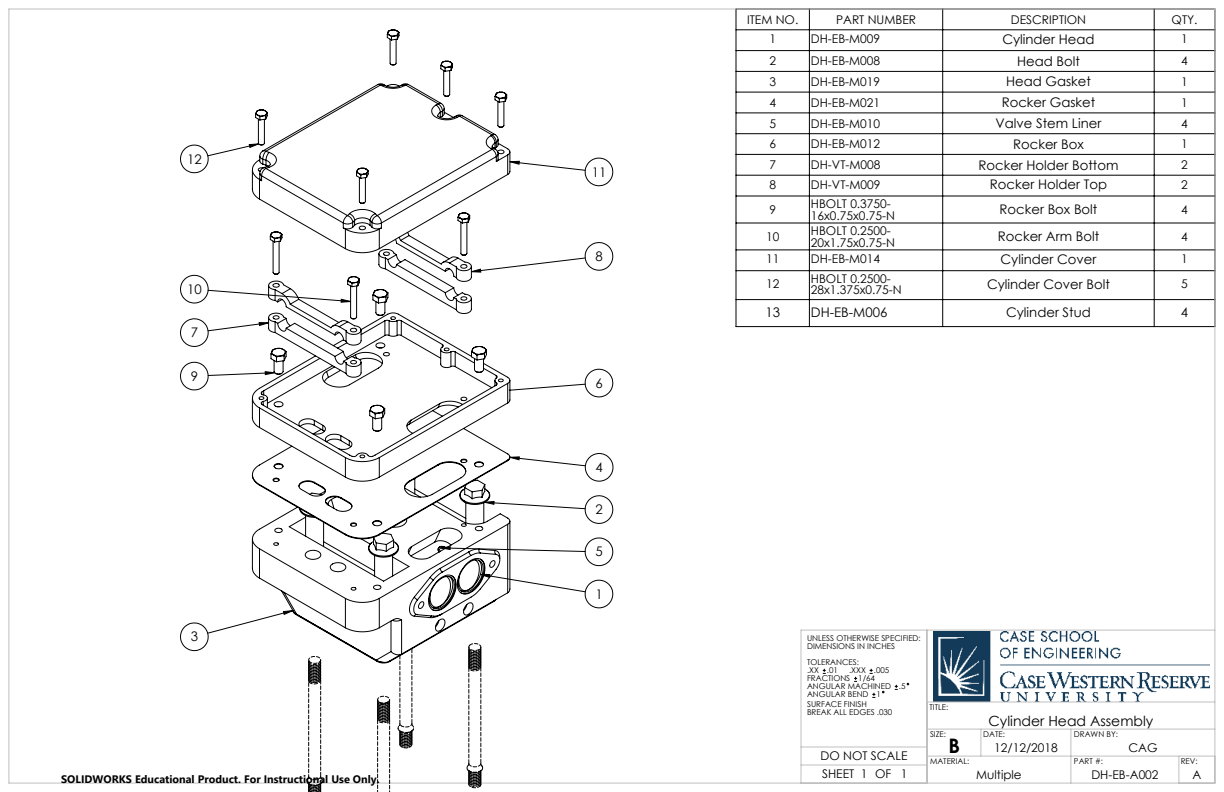
[picture p115: page 1]
DO NOT SCALE; SHEET 1 OF 1; Cylinder Head Assembly; DRAWN BY:; PART #:

ITEM NO. | PART NUMBER | DESCRIPTION | QTY.
1 | DH-EB-M009 | Cylinder Head | 1
2 | DH-EB-M008 | Head Bolt | 4
3 | DH-EB-M019 | Head Gasket | 1
4 | DH-EB-M021 | Rocker Gasket | 1
5 | DH-EB-M010 | Valve Stem Liner | 4
6 | DH-EB-M012 | Rocker Box | 1
7 | DH-VT-M008 | Rocker Holder Bottom | 2
8 | DH-VT-M009 | Rocker Holder Top | 2
9 | HBOLT 0.3750-16x0.75x0.75-N | Rocker Box Bolt | 4
10 | HBOLT 0.2500-20x1.75x0.75-N | Rocker Arm Bolt | 4
11 | DH-EB-M014 | Cylinder Cover | 1
12 | HBOLT 0.2500-28x1.375x0.75-N | Cylinder Cover Bolt | 5
13 | DH-EB-M006 | Cylinder Stud | 4

UNLESS OTHERWISE SPECIFIED:
DIMENSIONS IN INCHES
TOLERANCES:
.XX .01 .XXX .005
FRACTIONS 1/64
ANGULAR MACHINED .5
ANGULAR BEND 1
SURFACE FINISH
BREAK ALL EDGES .030

SOLIDWORKS Educational Product. For Instructional Use Only.
