trm79/Motorcycle-Engine-Design/Other Work/Full Assembly with Dimensions.PDF

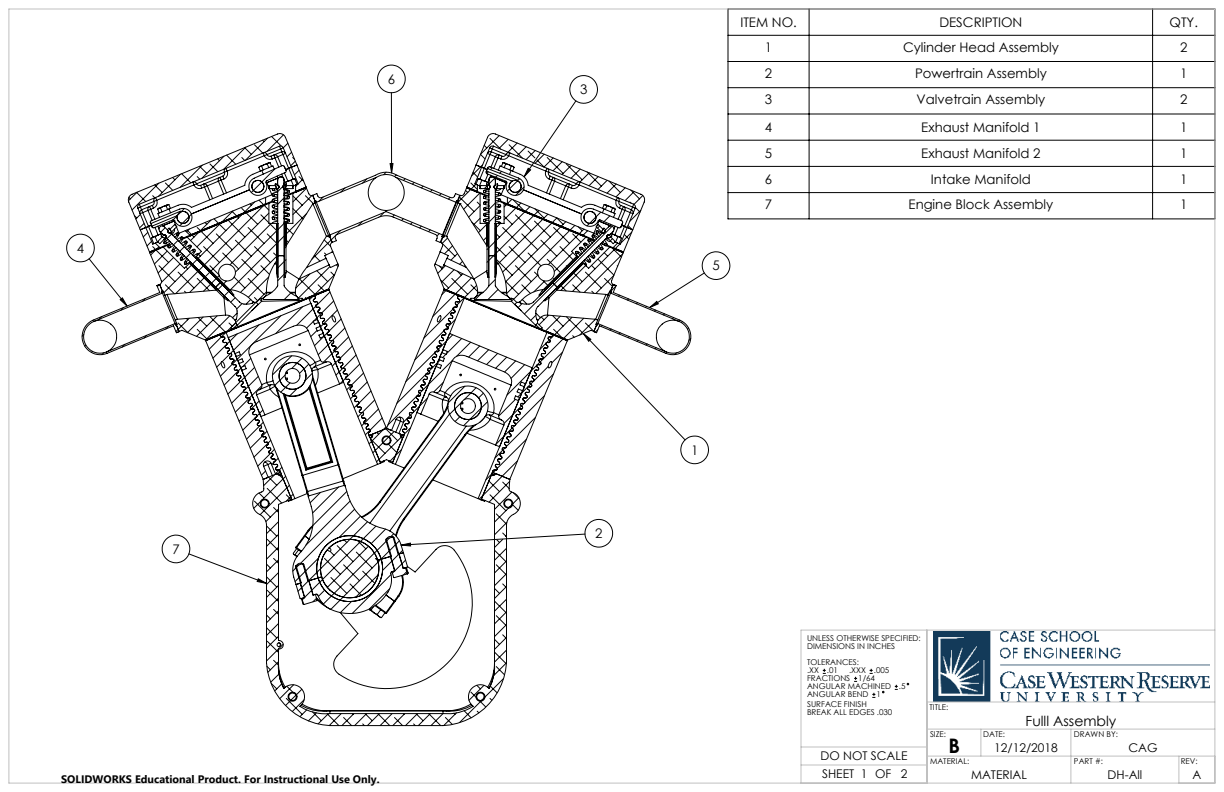
[picture p117: page 1]
DO NOT SCALE; SHEET 1 OF 2; DH-All; Fulll Assembly; DRAWN BY:; PART #:

ITEM NO. | DESCRIPTION | QTY.
1 | Cylinder Head Assembly | 2
2 | Powertrain Assembly | 1
3 | Valvetrain Assembly | 2
4 | Exhaust Manifold 1 | 1
5 | Exhaust Manifold 2 | 1
6 | Intake Manifold | 1
7 | Engine Block Assembly | 1

UNLESS OTHERWISE SPECIFIED:
DIMENSIONS IN INCHES
TOLERANCES:
.XX .01 .XXX .005
FRACTIONS 1/64
ANGULAR MACHINED .5
ANGULAR BEND 1
SURFACE FINISH
BREAK ALL EDGES .030

SOLIDWORKS Educational Product. For Instructional Use Only.

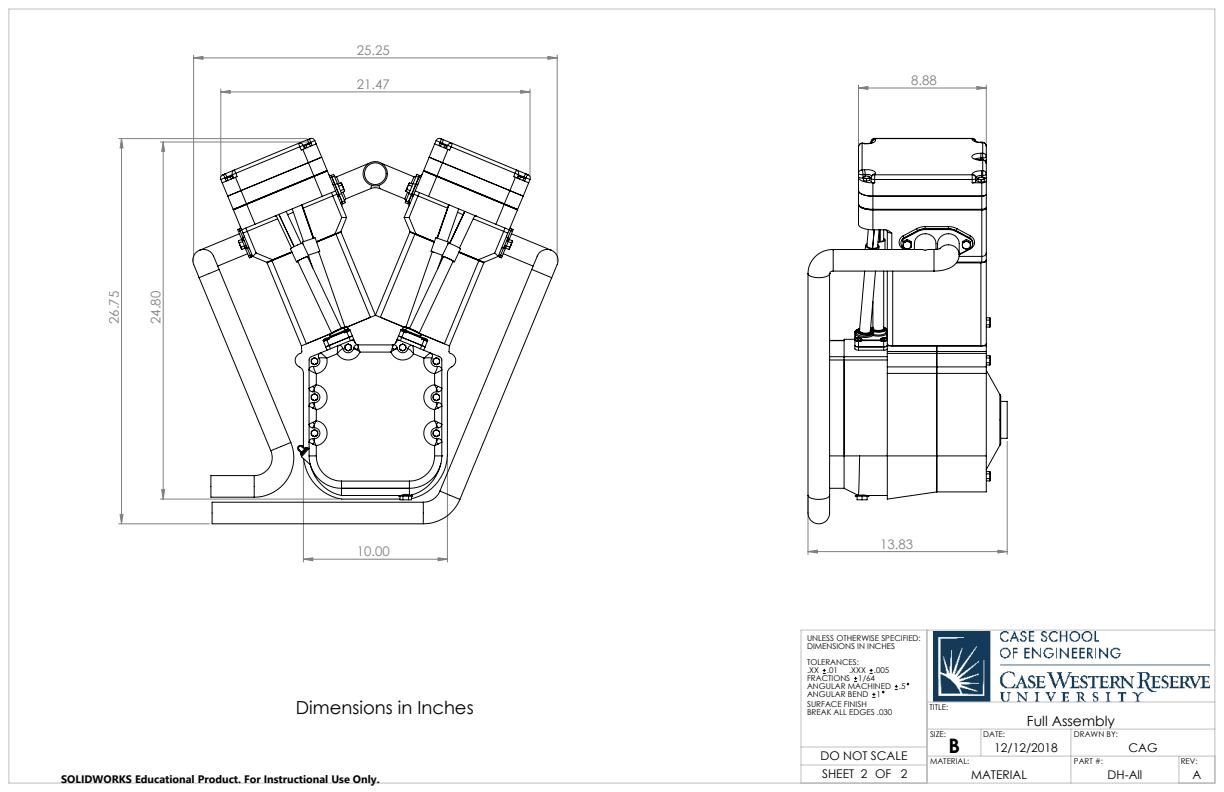
[picture p118: page 2]
DO NOT SCALE; SHEET 2 OF 2; DH-All; Full Assembly; DRAWN BY:; PART #:

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

Dimensions in Inches

SOLIDWORKS Educational Product. For Instructional Use Only.
