trm79/Motorcycle-Engine-Design/Other Work/Intake Manifold Assembly.PDF

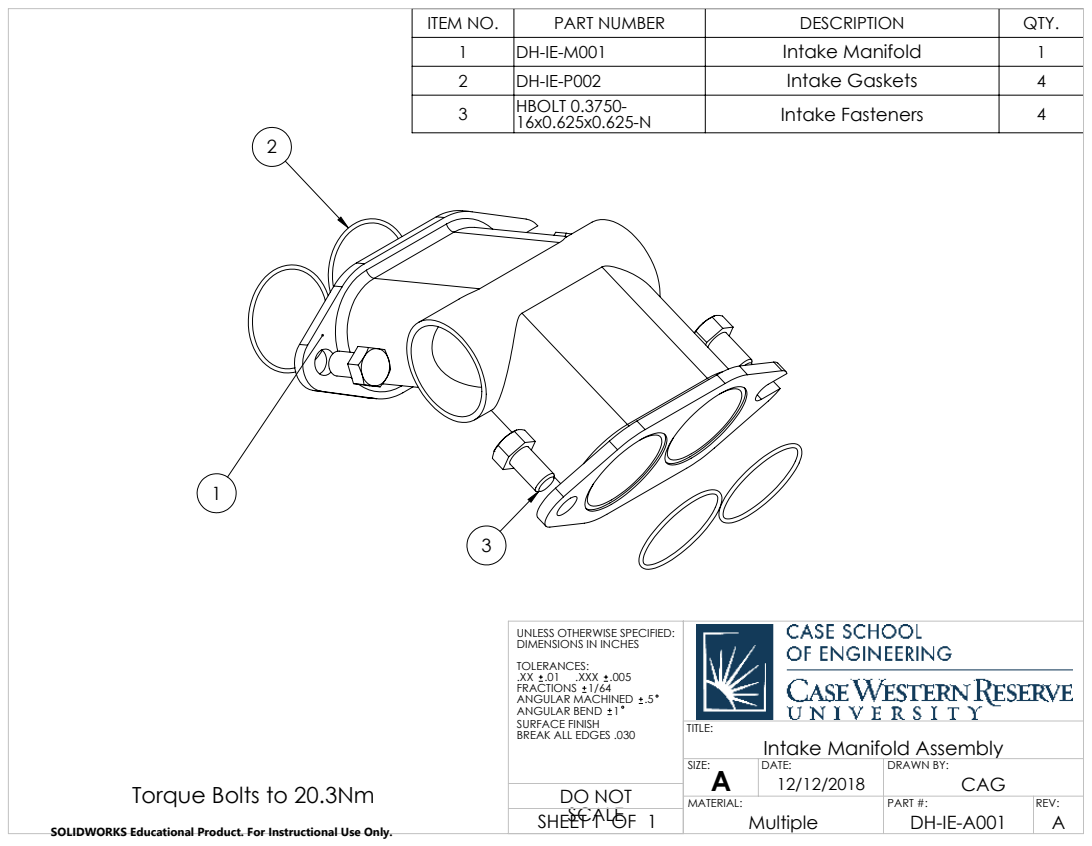
[picture p119: page 1]
PART #:; DRAWN BY:; Intake Manifold Assembly; SHEET 1 OF 1

ITEM NO. | PART NUMBER | DESCRIPTION | QTY.
1 | DH-IE-M001 | Intake Manifold | 1
2 | DH-IE-P002 | Intake Gaskets | 4
3 | HBOLT 0.3750-16x0.625x0.625-N | Intake Fasteners | 4

UNLESS OTHERWISE SPECIFIED:
DIMENSIONS IN INCHES
TOLERANCES:
.XX .01 .XXX .005
FRACTIONS 1/64
ANGULAR MACHINED .5
ANGULAR BEND 1
SURFACE FINISH
BREAK ALL EDGES .030
A DO NOT
SCALE

Torque Bolts to 20.3Nm

SOLIDWORKS Educational Product. For Instructional Use Only.
