trm79/Motorcycle-Engine-Design/Other Work/Valve Subassembly.PDF

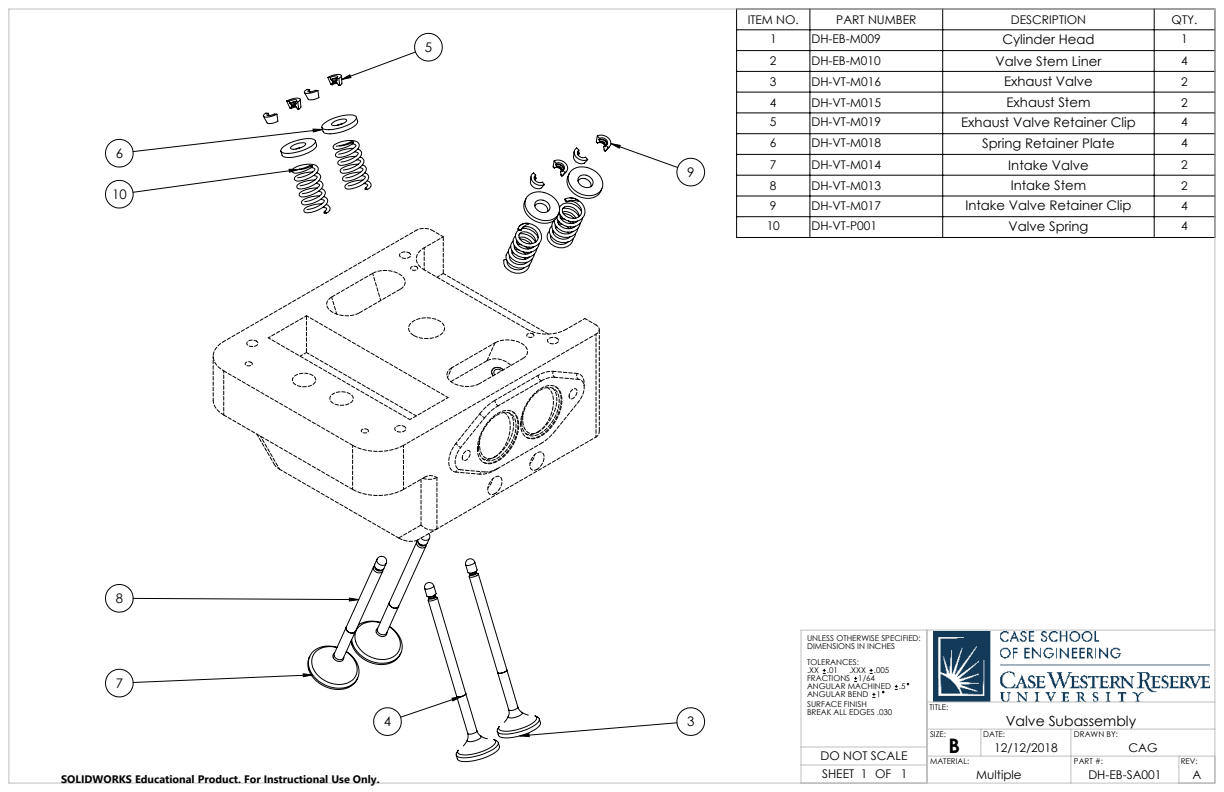
[picture p121: page 1]
DO NOT SCALE; SHEET 1 OF 1; Valve Subassembly; DRAWN BY:; PART #:

ITEM NO. | PART NUMBER | DESCRIPTION | QTY.
1 | DH-EB-M009 | Cylinder Head | 1
2 | DH-EB-M010 | Valve Stem Liner | 4
3 | DH-VT-M016 | Exhaust Valve | 2
4 | DH-VT-M015 | Exhaust Stem | 2
5 | DH-VT-M019 | Exhaust Valve Retainer Clip | 4
6 | DH-VT-M018 | Spring Retainer Plate | 4
7 | DH-VT-M014 | Intake Valve | 2
8 | DH-VT-M013 | Intake Stem | 2
9 | DH-VT-M017 | Intake Valve Retainer Clip | 4
10 | DH-VT-P001 | Valve Spring | 4

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

SOLIDWORKS Educational Product. For Instructional Use Only.
