trm79/Motorcycle-Engine-Design/Other Work/Connecting_Rod.pdf

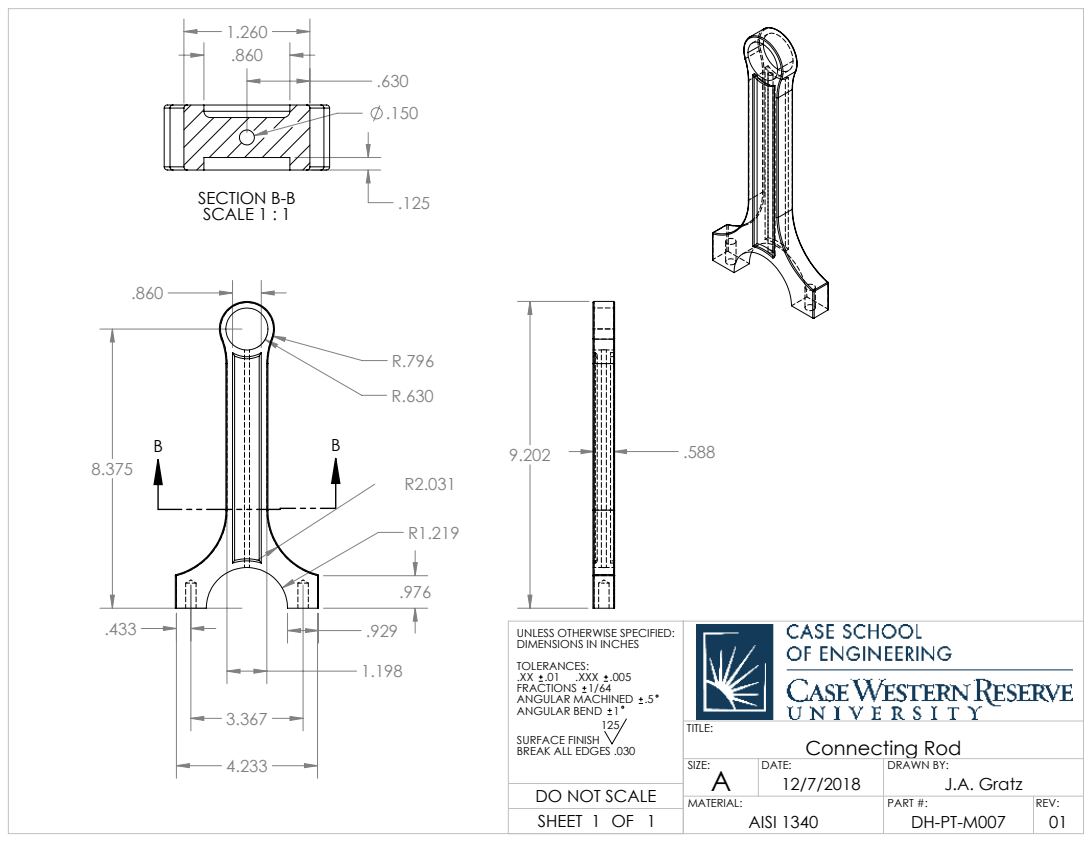
[picture p122: page 1]
SECTION B-B SCALE 1 : 1; PART #:; DRAWN BY:; Connecting Rod; AISI 1340; J.A. Gratz; SHEET 1 OF 1

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

SURFACE FINISH
BREAK ALL EDGES .030
A DO NOT SCALE
