trm79/Motorcycle-Engine-Design/Other Work/DH-PT-M008 (Lubrication view).PDF

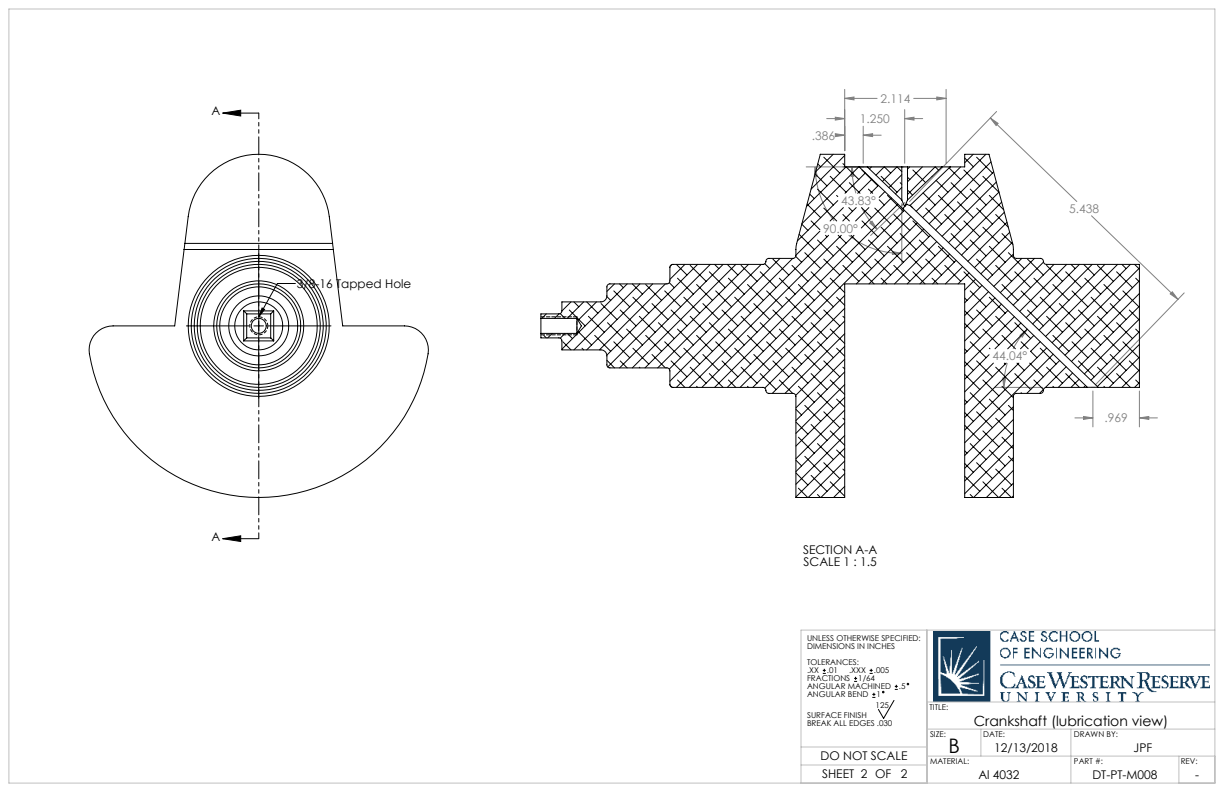
[picture p123: page 1]
3/8-16 Tapped Hole; SECTION A-A SCALE 1 : 1.5; DO NOT SCALE; SHEET 2 OF 2; Crankshaft (lubrication view); DRAWN BY:; PART #:

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

SURFACE FINISH
BREAK ALL EDGES .030
