trm79/Motorcycle-Engine-Design/Other Work/Exhaust Manifold 1.PDF

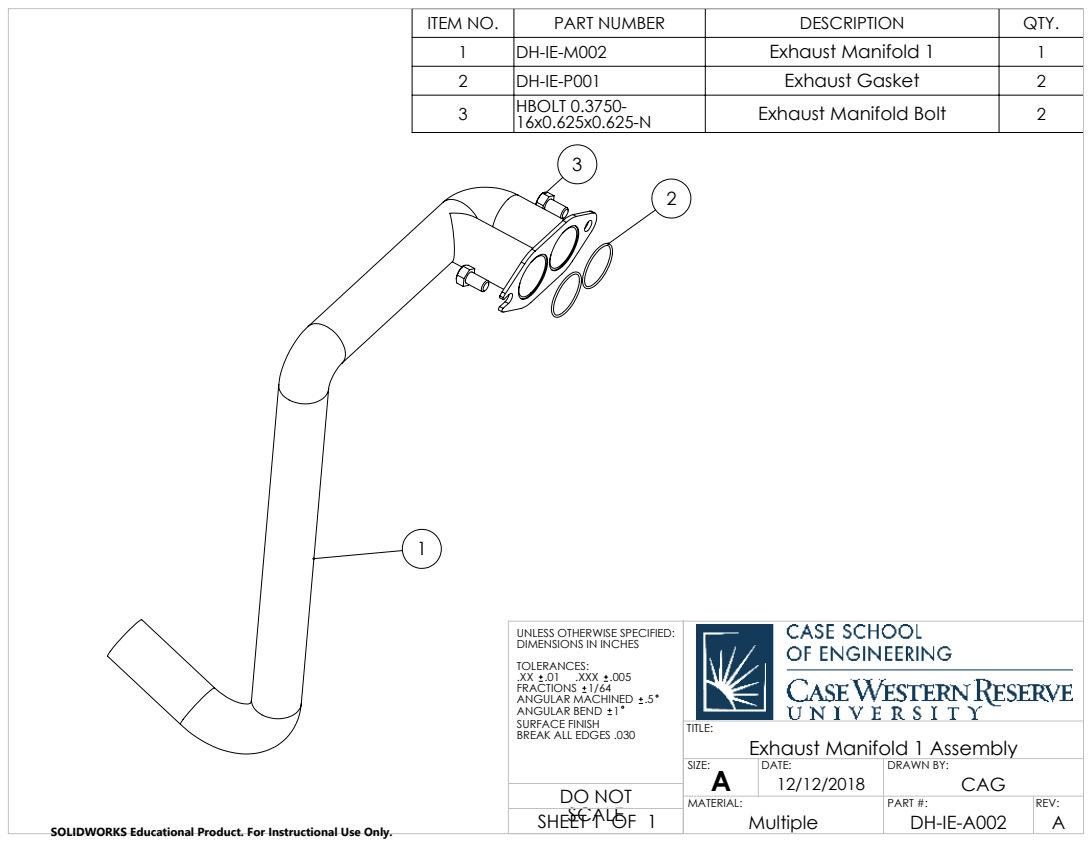
[picture p124: page 1]
PART #:; DRAWN BY:; Exhaust Manifold 1 Assembly; SHEET 1 OF 1

ITEM NO. | PART NUMBER | DESCRIPTION | QTY.
1 | DH-IE-M002 | Exhaust Manifold 1 | 1
2 | DH-IE-P001 | Exhaust Gasket | 2
3 | HBOLT 0.3750-16x0.625x0.625-N | Exhaust Manifold Bolt | 2

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

SOLIDWORKS Educational Product. For Instructional Use Only.
