trm79/Motorcycle-Engine-Design/Part Files/Drawings/PDFs/aux crank bearing bottom.PDF

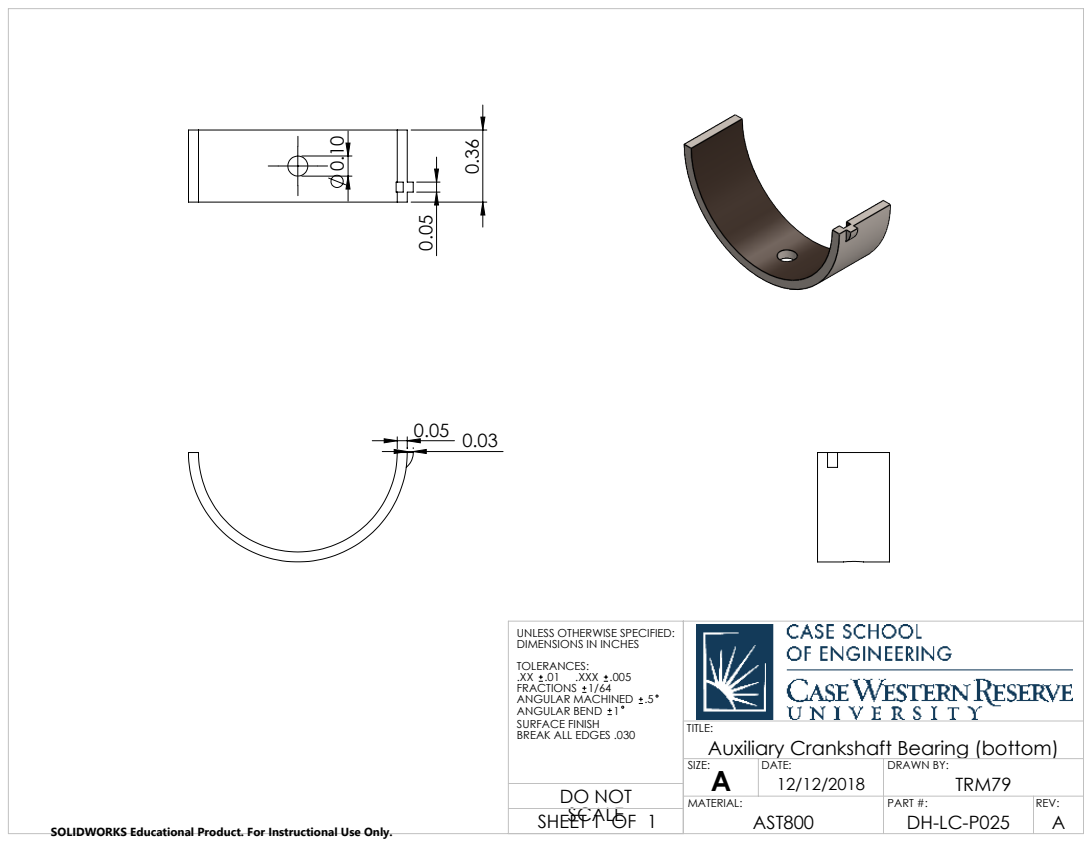
[picture p125: page 1]
PART #:; DRAWN BY:; SHEET 1 OF 1

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

TITLE:
Auxiliary Crankshaft Bearing (bottom)
SIZE:

SOLIDWORKS Educational Product. For Instructional Use Only.
