trm79/Motorcycle-Engine-Design/Part Files/Drawings/PDFs/wrist pin bearing.PDF

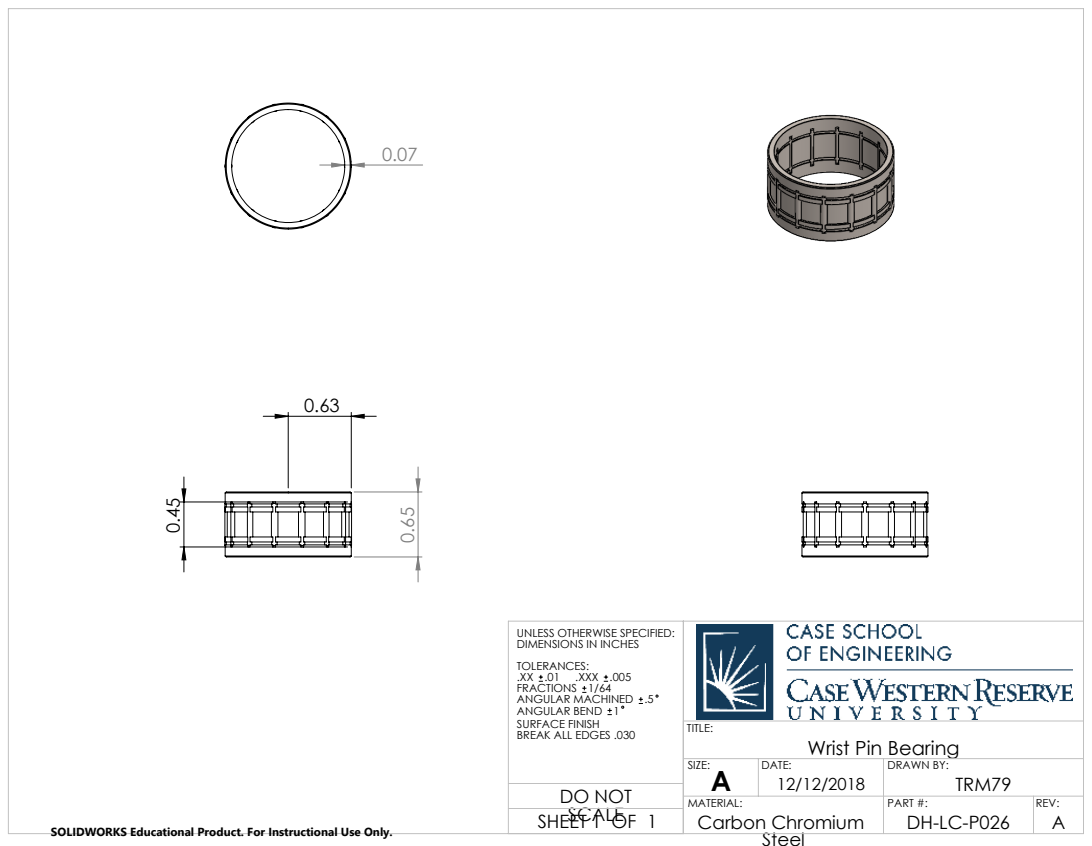
[picture p126: page 1]
PART #:; DRAWN BY:; Carbon Chromium; SHEET 1 OF 1

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

Wrist Pin Bearing

SOLIDWORKS Educational Product. For Instructional Use Only.
