trm79/Motorcycle-Engine-Design/Other Work/DH-PT-M008 (External view).PDF

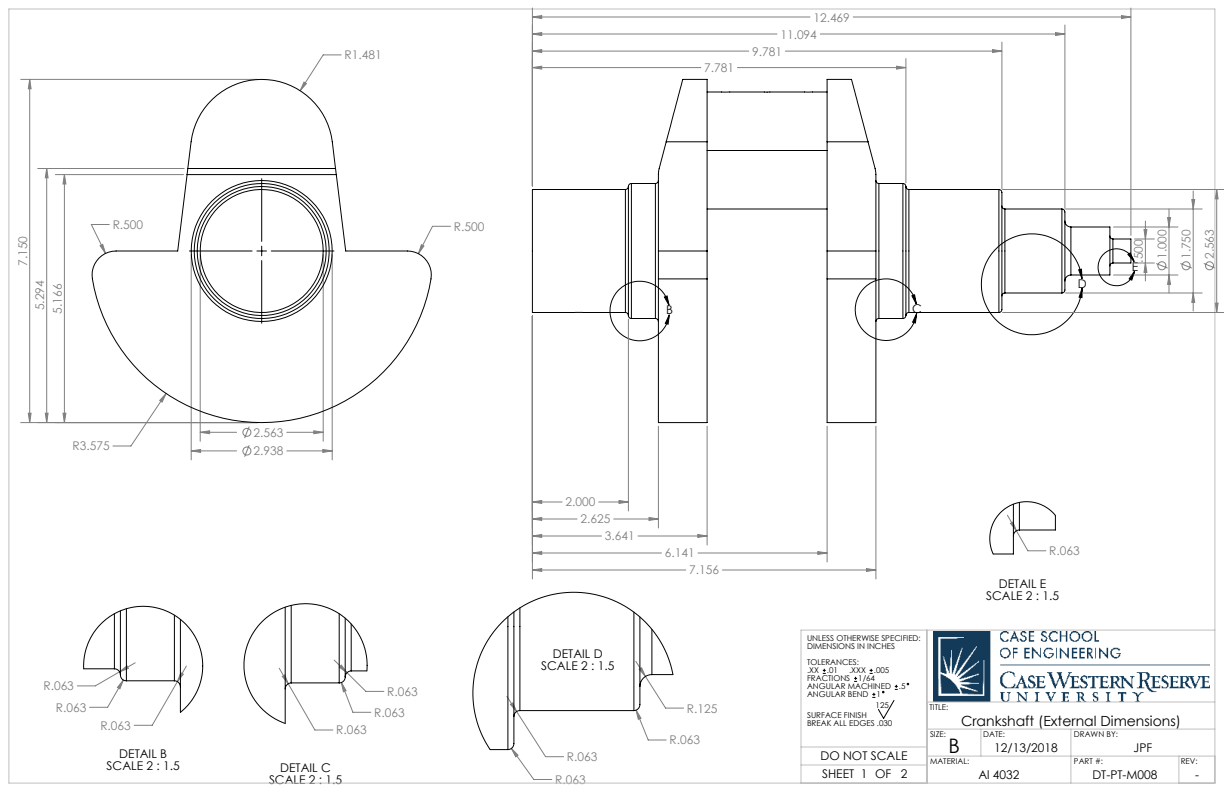
[picture p127: page 1]
DETAIL B SCALE 2 : 1.5; DETAIL C; SCALE 2 : 1.5; DETAIL D SCALE 2 : 1.5; DETAIL E SCALE 2 : 1.5; DO NOT SCALE; SHEET 1 OF 2; Crankshaft (External Dimensions); DRAWN BY:; PART #:

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

SURFACE FINISH
BREAK ALL EDGES .030
