trm79/Motorcycle-Engine-Design/Other Work/Front Engine Block.PDF

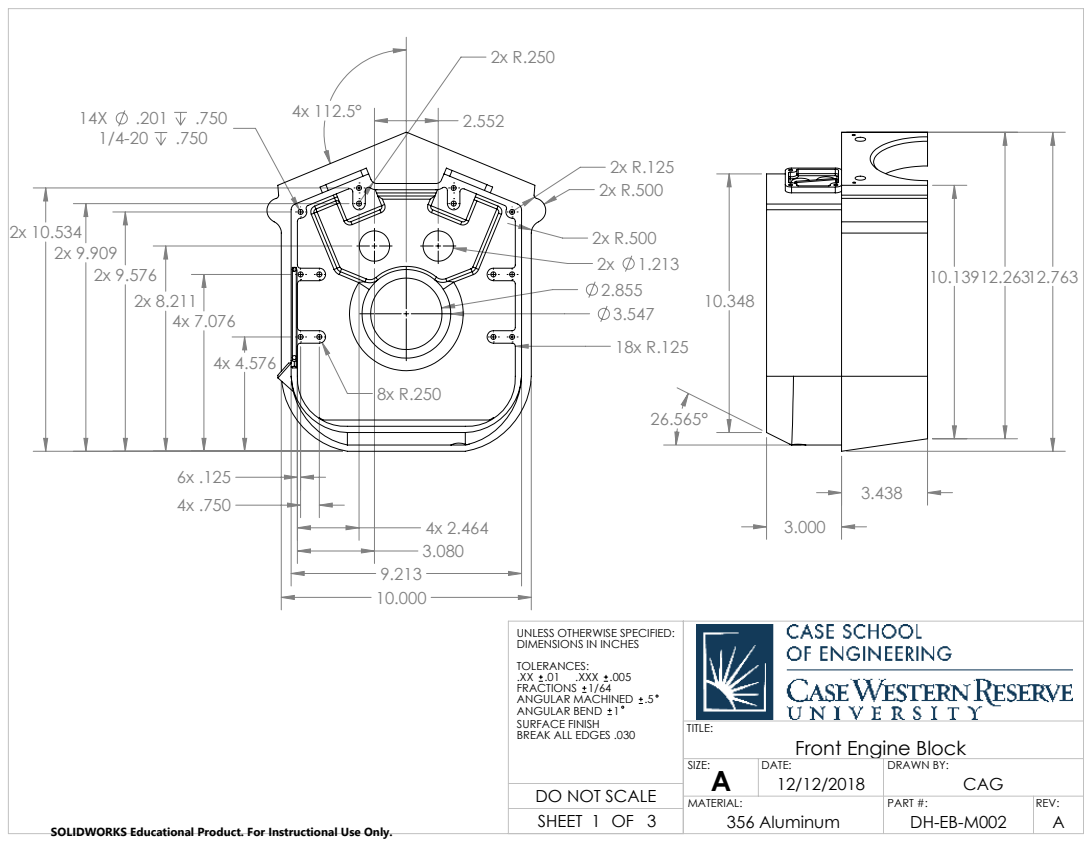
[picture p129: page 1]
PART #:; DRAWN BY:; 356 Aluminum; SHEET 1 OF 3

UNLESS OTHERWISE SPECIFIED:
DIMENSIONS IN INCHES
TOLERANCES:
.XX .01 .XXX .005
FRACTIONS 1/64
ANGULAR MACHINED .5
ANGULAR BEND 1
SURFACE FINISH
BREAK ALL EDGES .030
A DO NOT SCALE

Front Engine Block
DATE:

SOLIDWORKS Educational Product. For Instructional Use Only.

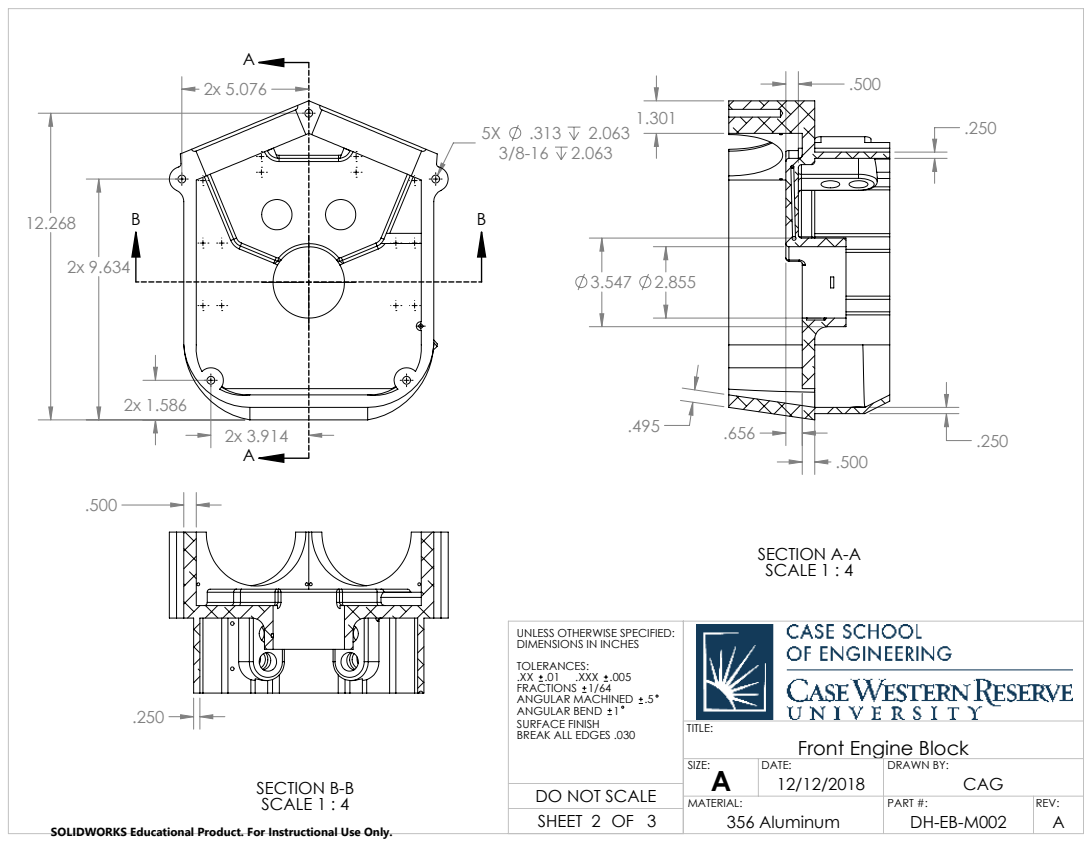
[picture p130: page 2]
SECTION B-B SCALE 1 : 4; SECTION A-A SCALE 1 : 4; DRAWN BY:; SHEET 2 OF 3

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

Front Engine Block
DATE:

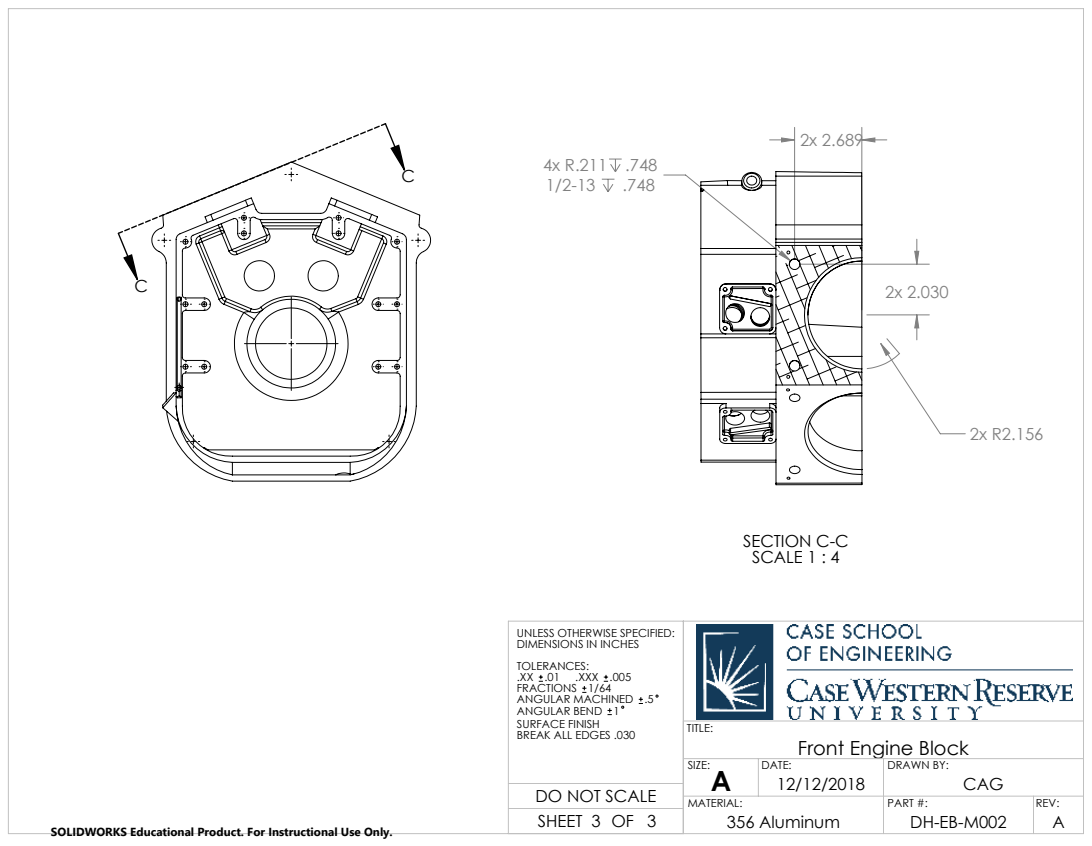
[picture p131: page 3]
SECTION C-C SCALE 1 : 4; DRAWN BY:; SHEET 3 OF 3

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

Front Engine Block
DATE:
