trm79/Motorcycle-Engine-Design/Other Work/Piston.PDF

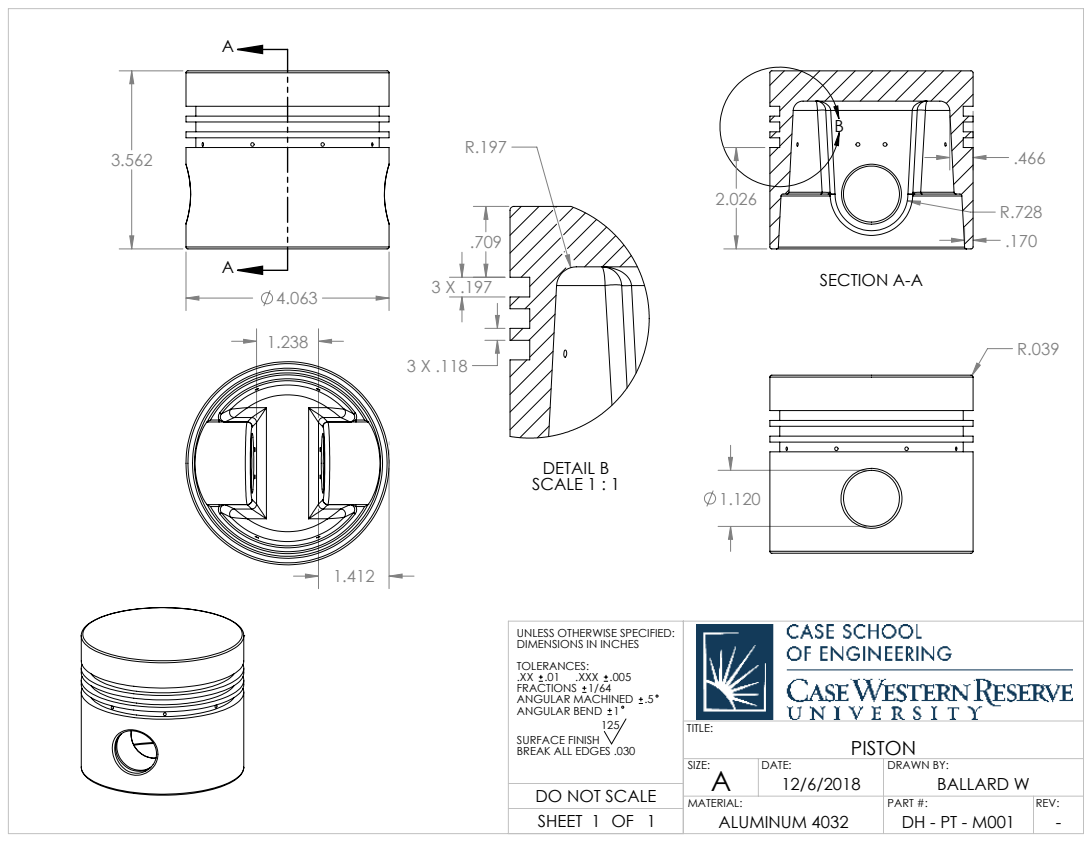
[picture p132: page 1]
SECTION A-A; DETAIL B SCALE 1 : 1; PART #:; DRAWN BY:; ALUMINUM 4032; BALLARD W; SHEET 1 OF 1

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

SURFACE FINISH
BREAK ALL EDGES .030
A DO NOT SCALE
